mattcarberry/echolink_hardware/Documentation/Project Documents/Pictures for Presentation and other docs/dj-audio-mixer-clip-art.jpg

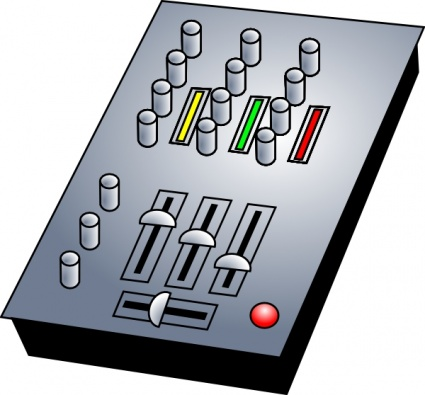
Documentation/Project Documents/Pictures for Presentation and other docs/dj-audio-mixer-clip-art.jpg
