mattcarberry/echolink_hardware/Documentation/Project Documents/2716_cyberspace/2716_example.jpg

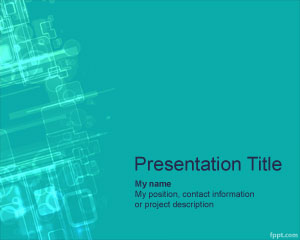
Documentation/Project Documents/2716_cyberspace/2716_example.jpg
