mattcarberry/echolink_hardware/README.md

# echolink_hardware
Hardware for interfacing AC6P's repeater design to an echolink server
