mattcarberry/echolink_hardware/Documentation/Project/Final Presentation/Final_Pres_SC_Only.pptx

## Antenna Switching Circuit

- System that switches active antenna
- Digital control and feedback signals

## Motivation

- Real time switching between antennas
- Switching event through DTMF tones

## Initial Design and Implementation

- Power supply
- Coaxial relays
- Power MOSFETs
- Two feedback signals

## Challenges

- Rectified DC voltage higher than calculations predicted
- Power resistors were found to get very hot
- DTMF board can’t completely tell state of switching board

## Final Design

- Added a fan to cool
- Third feedback signal added

## Results

- Reliable antenna switching
