mattcarberry/echolink_hardware/Documentation/Project/Final Presentation/PresentationLuis.pptx

## DTMF Controller

Overview:
- The DTMF Controller acts as a central control for the antenna switching system
  - Logic is collected and sent between this circuit and the Linking Interface as well as the Switching Circuit
  - Verifies DTMF sequences through hardware and switches between the VPOL and CPOL antenna upon an appropriate sequence

## Initial Design and Implementation

- Initial Design included DTMF decoder chip MT8870 and an Atmega328P
  - Atmega 328P provides enough GPIO ports for desired inputs, outputs, and additional pins for future work
  - Atmega 328P inputs are compatible with Decoder outputs
- Initial design involved Pulsed inputs using AND gates

## Challenges

- Debugging
- Slow Decoding
- Pulsed signals had potential for timing errors, so instead designed to function with latched signals synchronous

## Results

- Final Design
  - Faster Decoding Time
  - Latched Inputs
  - LCD Display
  - Status LED’s
  - Manual Switch
  - Audible Tone

## All Star Link Node

- Overview
  - Odroid U3
  - Asterisk PBX
  - AllStar Link
  - Validated Users
  - Security

## Approach and Initial Design

- IRLP
- Odroid U3
- CM 108 Audio Codec
- U3 I/O Daughter Board

## Challenges

- Processing power
- Software Installation
- Device Driver
- Little Documentation
- No Support for Odroid
- UDP Port Access

## Results
