mattcarberry/echolink_hardware/Documentation/Project/Meeting Records/meetingweek1.docx

Tim:

IRLP, and Echolink:

Maybe first, integrate each system on their own microcontroller, and once its working, then look into integrating them onto a single board.

Make sure to transpose all notes to a physical notebook.

Tim and Luis:

Make sure to specifically differentiate the work that each one does every week.

Kevin:
