mattcarberry/echolink_hardware/CPOLAntenna/TRASCO RF Relay kc-11200.pdf

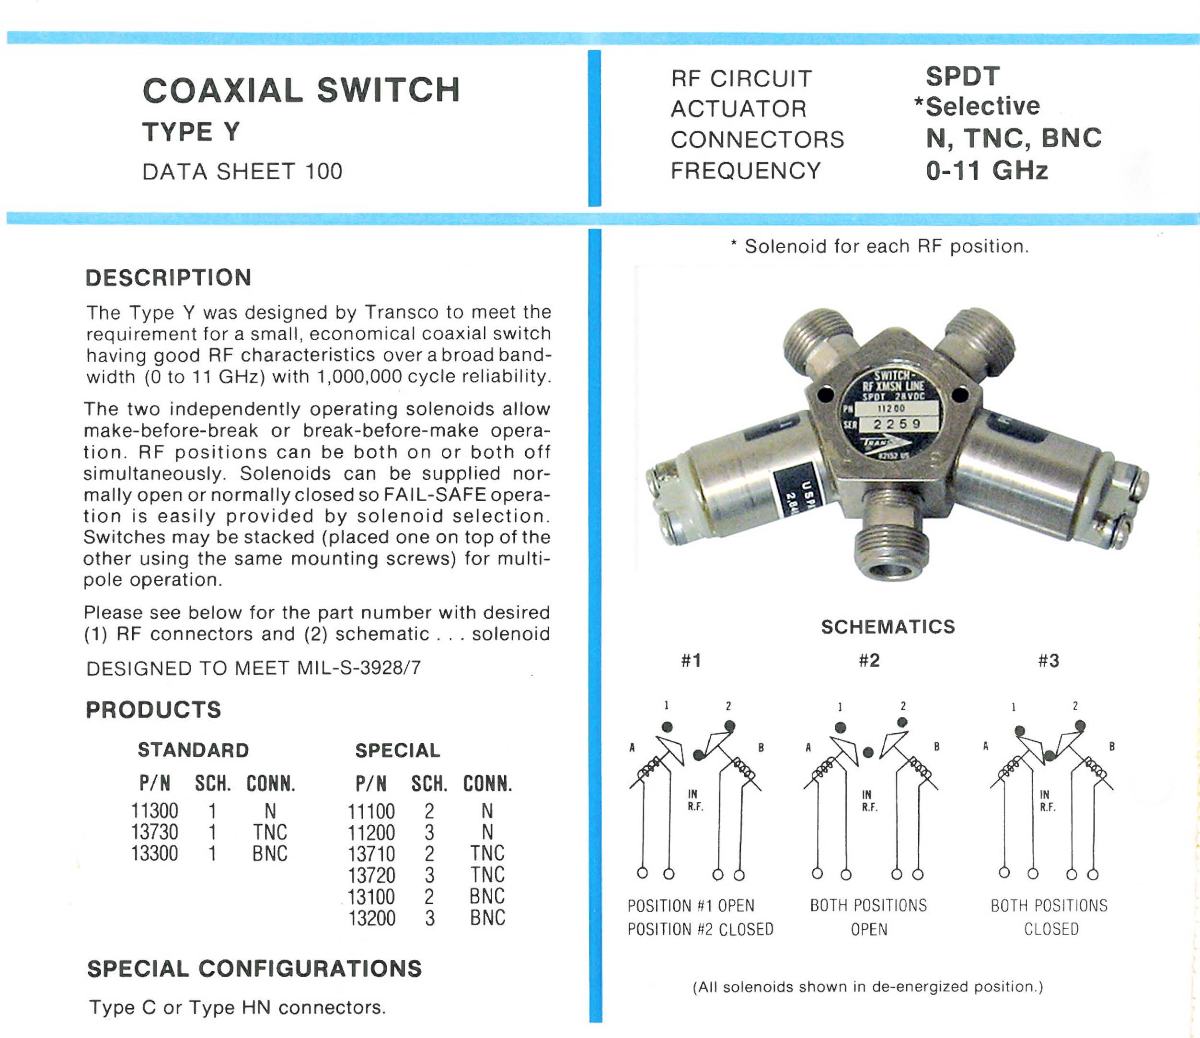
[picture p41: page 1]
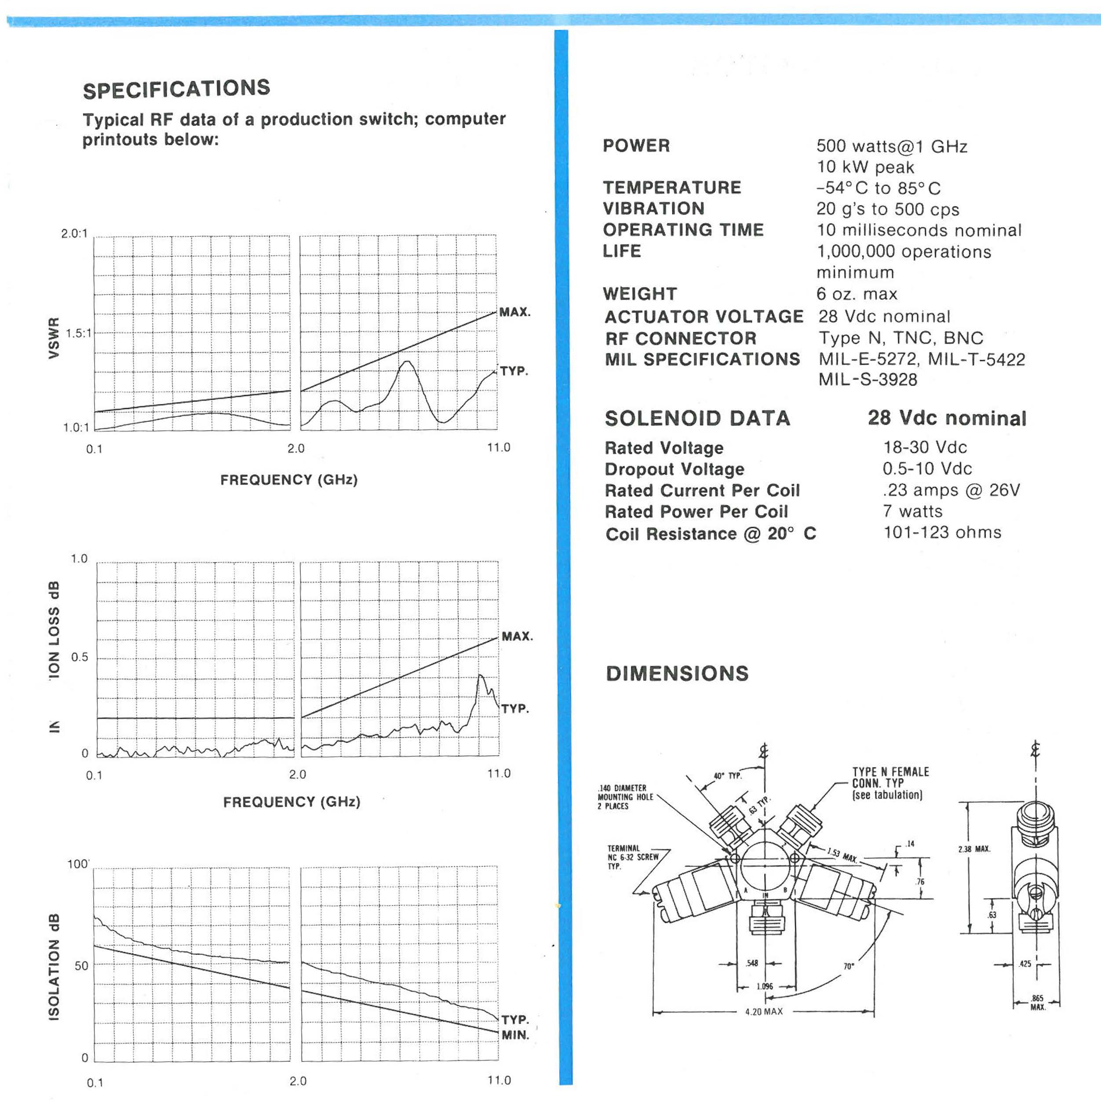
[picture p42: page 2]
