mattcarberry/echolink_hardware/Documentation/repeater_interface_v2_0.pdf

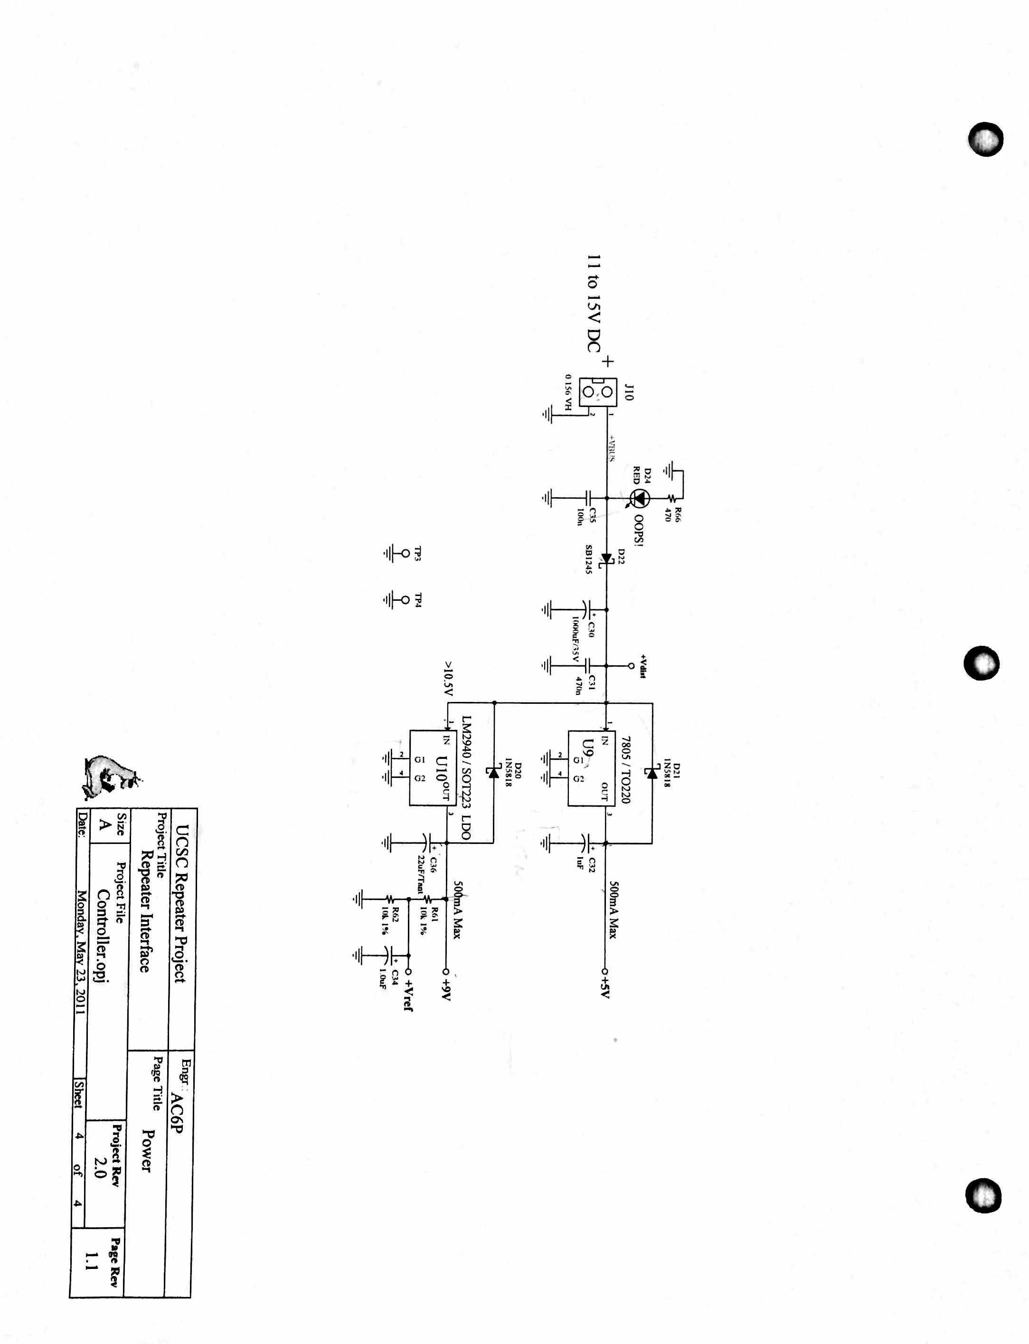
[picture p43: page 1]
