mattcarberry/echolink_hardware/Documentation/BlockDiagrams/Doc - Feb 17, 2015, 4-01 PM.pdf

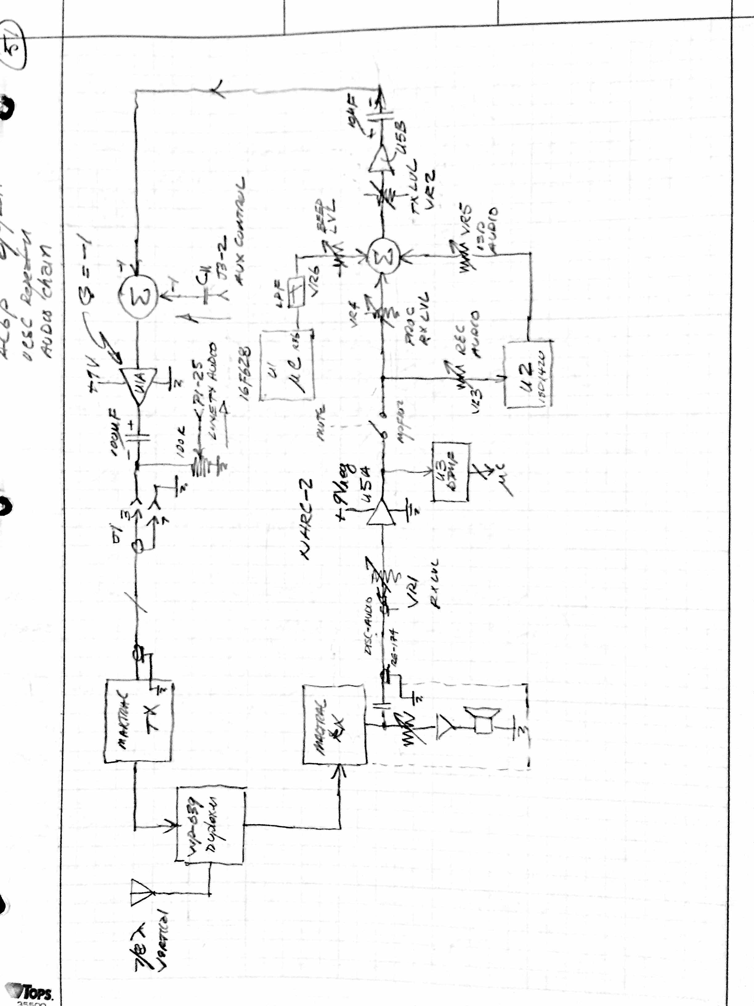
[picture p44: page 1]
