mattcarberry/echolink_hardware/Documentation/BlockDiagrams/Doc - Mar 3, 2015, 4-58 PM.pdf

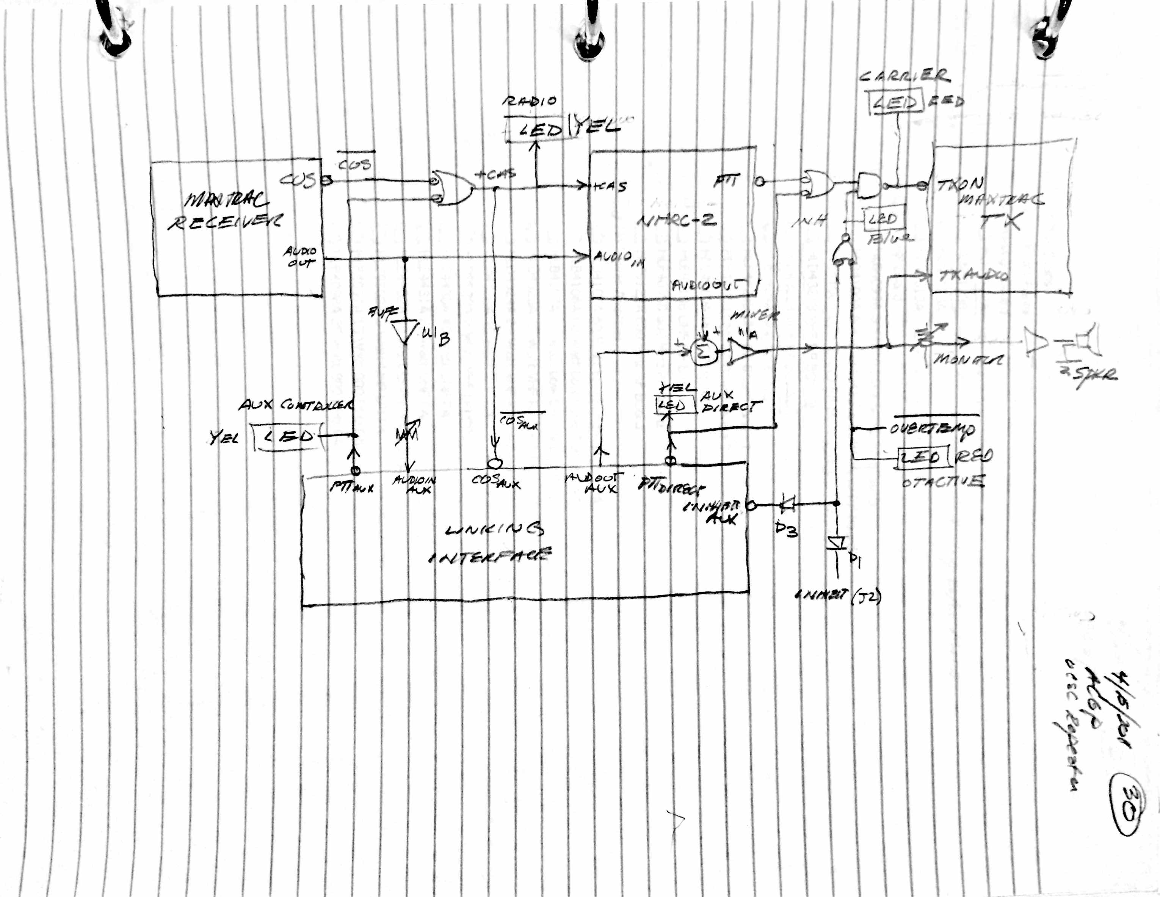
[picture p45: page 1]
