mattcarberry/echolink_hardware/Documentation/AppNotes/DTMF-code-table.jpg

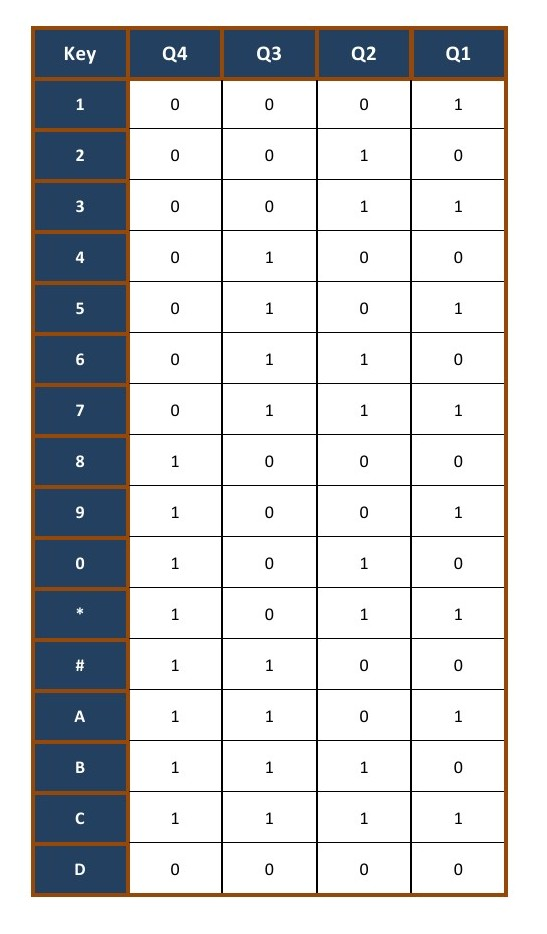
Documentation/AppNotes/DTMF-code-table.jpg
