mattcarberry/echolink_hardware/Documentation/AppNotes/image8.png

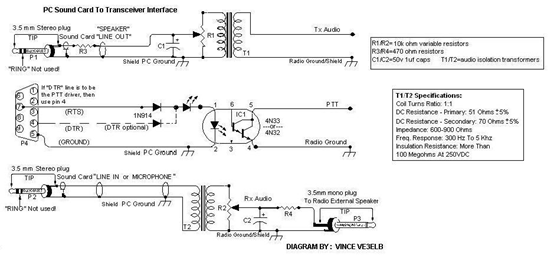
Documentation/AppNotes/image8.png
