mattcarberry/echolink_hardware/Documentation/AppNotes/image11.png

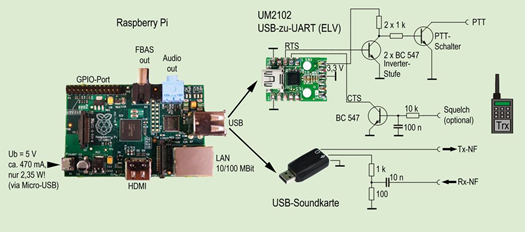
Documentation/AppNotes/image11.png
