mattcarberry/echolink_hardware/Documentation/AppNotes/irlpd.jpg

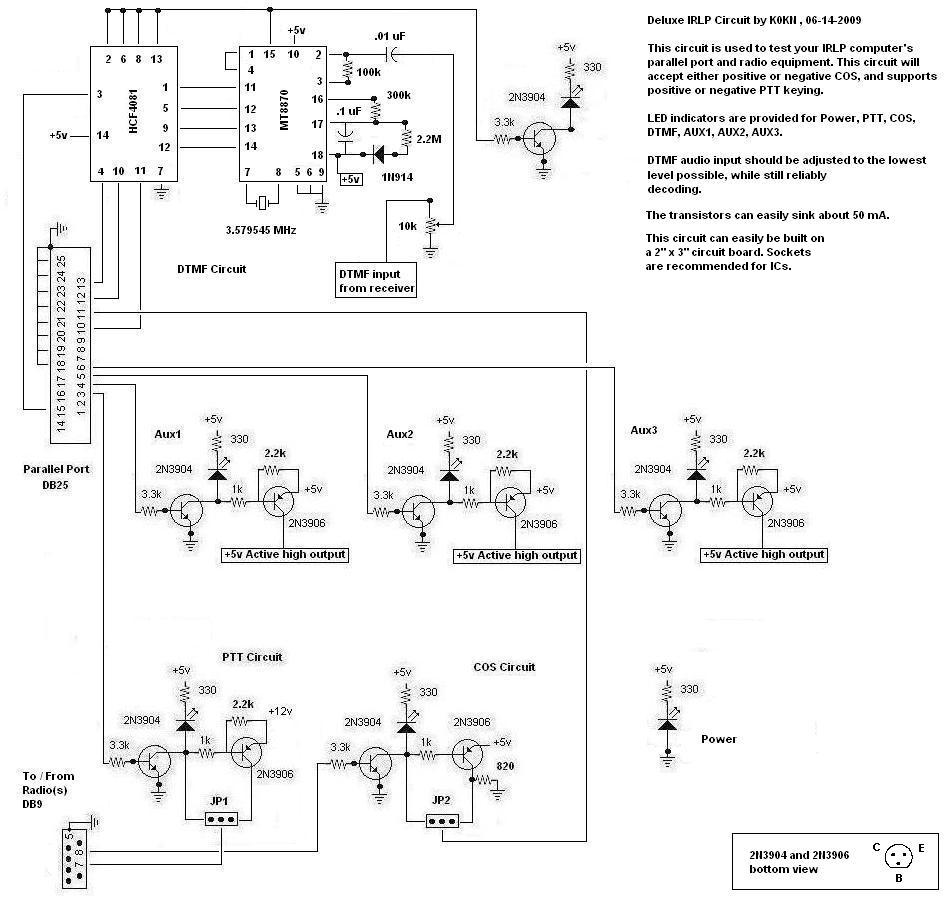
Documentation/AppNotes/irlpd.jpg
