mattcarberry/echolink_hardware/Documentation/AppNotes/simple_interface1.png

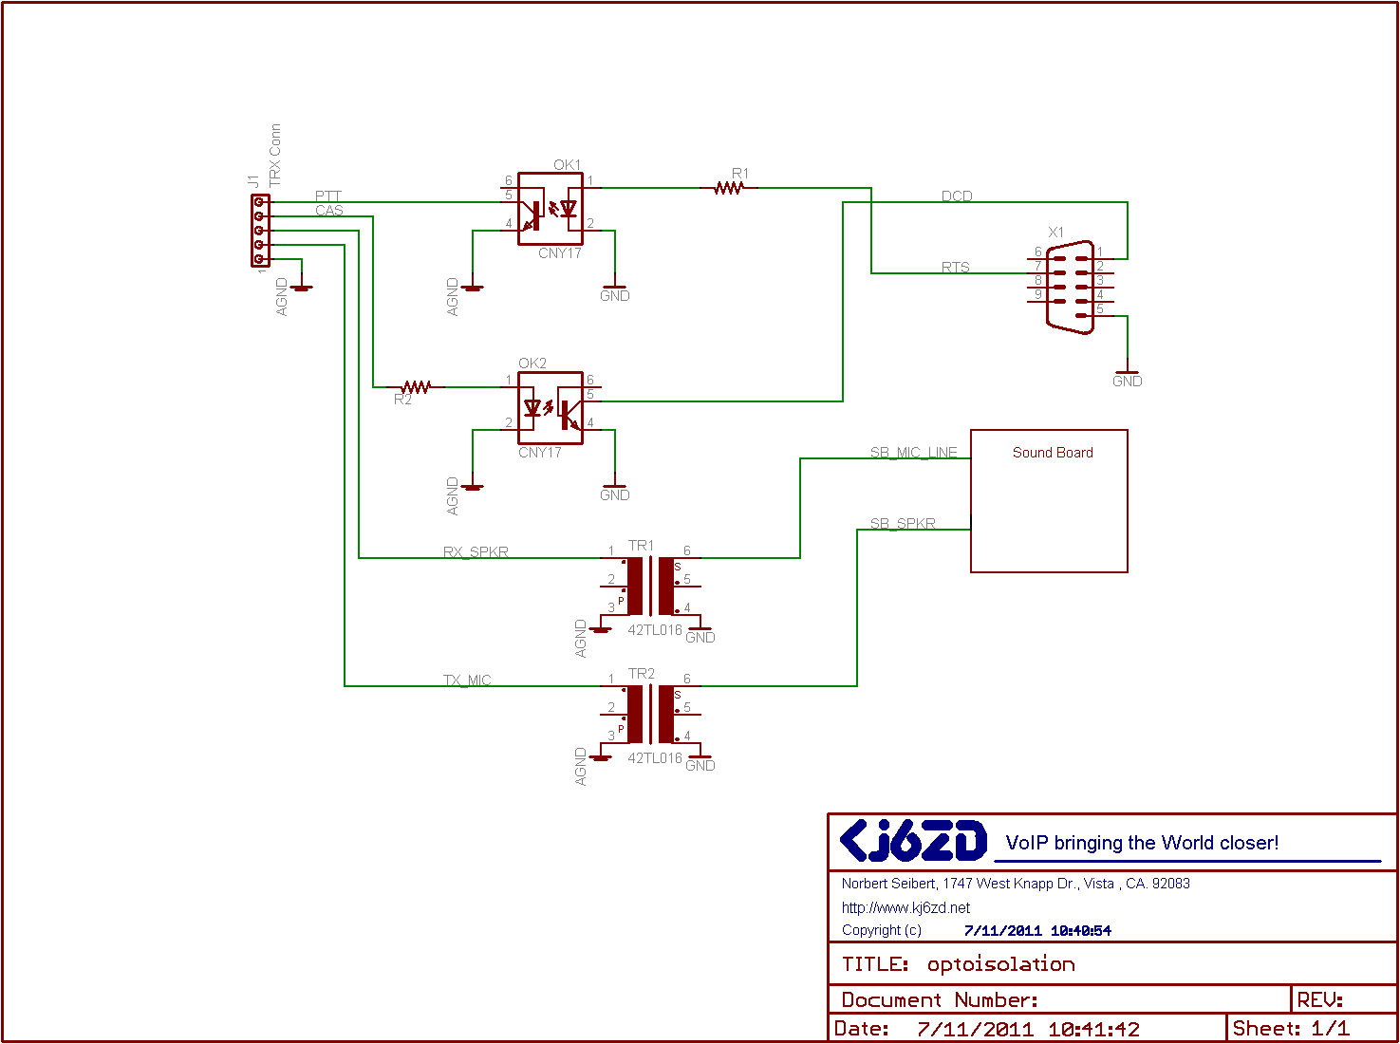
Documentation/AppNotes/simple_interface1.png
