mattcarberry/echolink_hardware/Documentation/AppNotes/SvxLink-Extension2.png

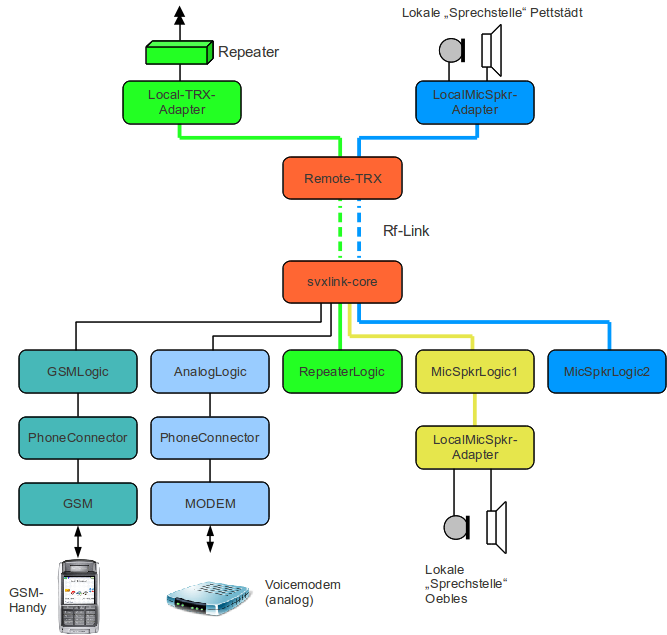
Documentation/AppNotes/SvxLink-Extension2.png
