mattcarberry/echolink_hardware/Documentation/AppNotes/typical.gif

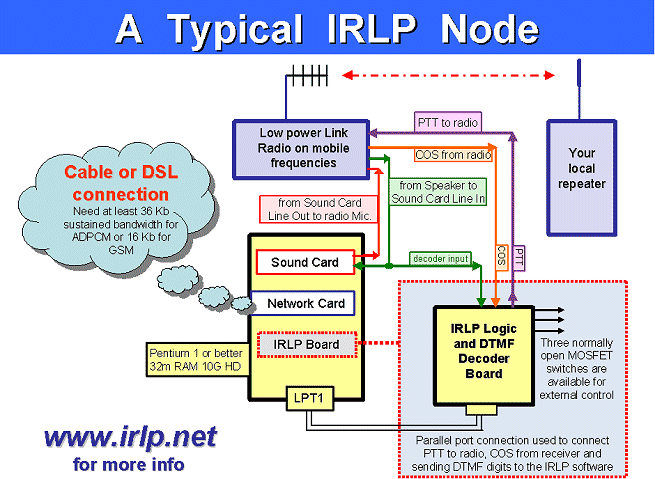
Documentation/AppNotes/typical.gif
