mattcarberry/echolink_hardware/Documentation/BlockDiagrams/FullSystemBlockDiagram_Final.jpg

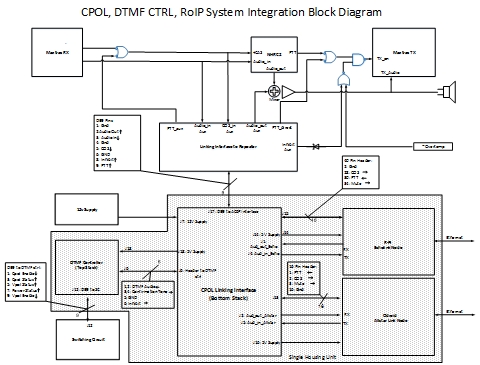
Documentation/BlockDiagrams/FullSystemBlockDiagram_Final.jpg
