mattcarberry/echolink_hardware/Documentation/BlockDiagrams/Screen Shot 2015-01-08 at 4.49.24 PM.png

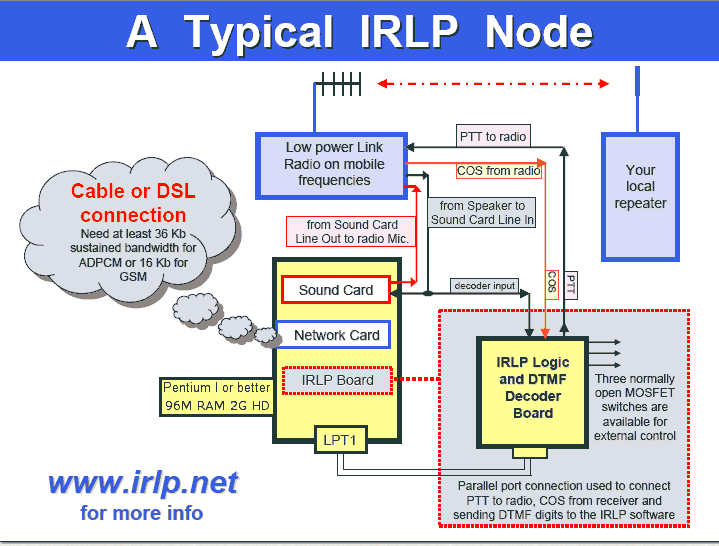
Documentation/BlockDiagrams/Screen Shot 2015-01-08 at 4.49.24 PM.png
