mattcarberry/echolink_hardware/Documentation/BlockDiagrams/Screen Shot 2015-01-08 at 7.00.11 PM.png

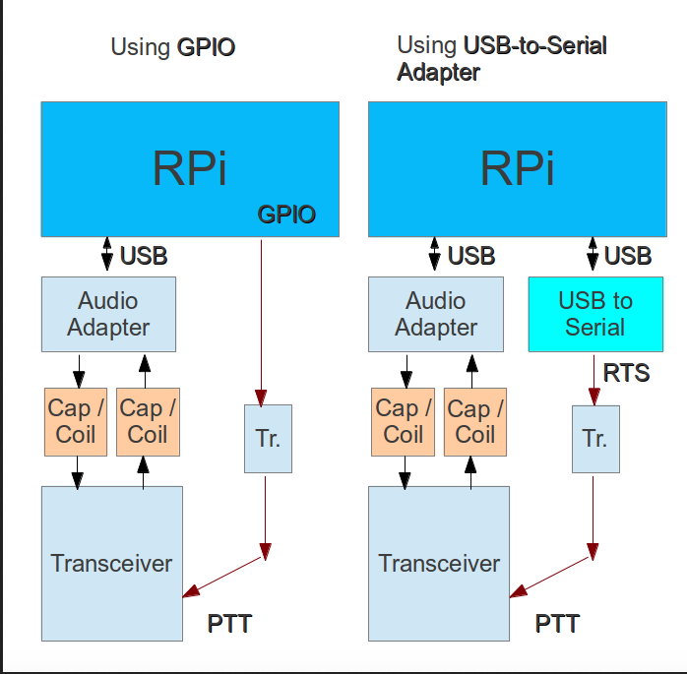
Documentation/BlockDiagrams/Screen Shot 2015-01-08 at 7.00.11 PM.png
