mattcarberry/echolink_hardware/Documentation/BlockDiagrams/SystemBlockDiagram_EcholinkANDAllstarLink.jpg

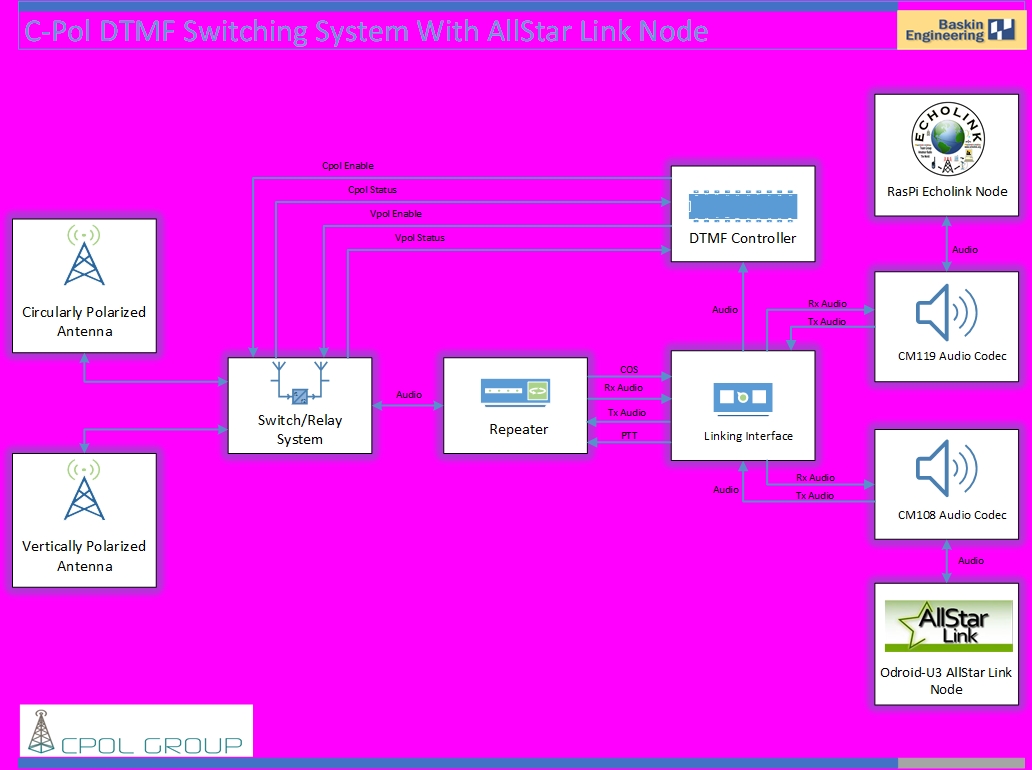
Documentation/BlockDiagrams/SystemBlockDiagram_EcholinkANDAllstarLink.jpg
