mattcarberry/echolink_hardware/Documentation/linking_interface_usb.png

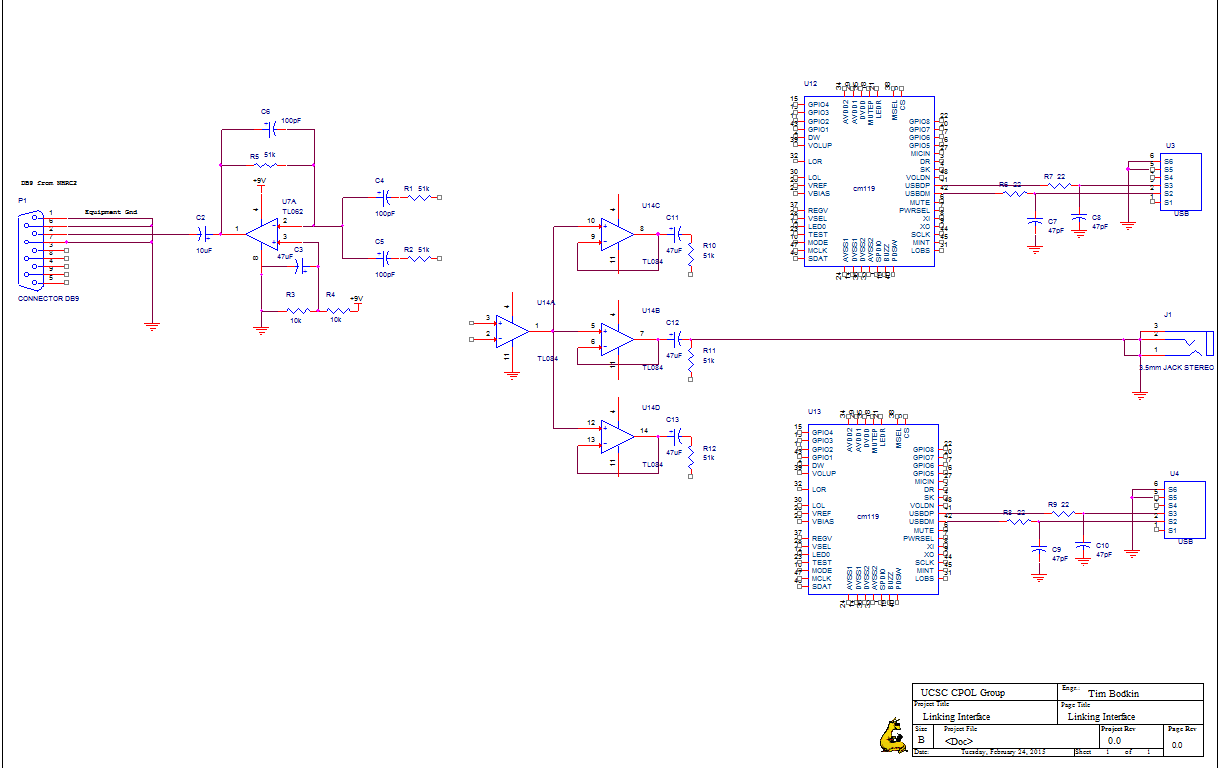
Documentation/linking_interface_usb.png
