mattcarberry/echolink_hardware/Documentation/plria.jpg

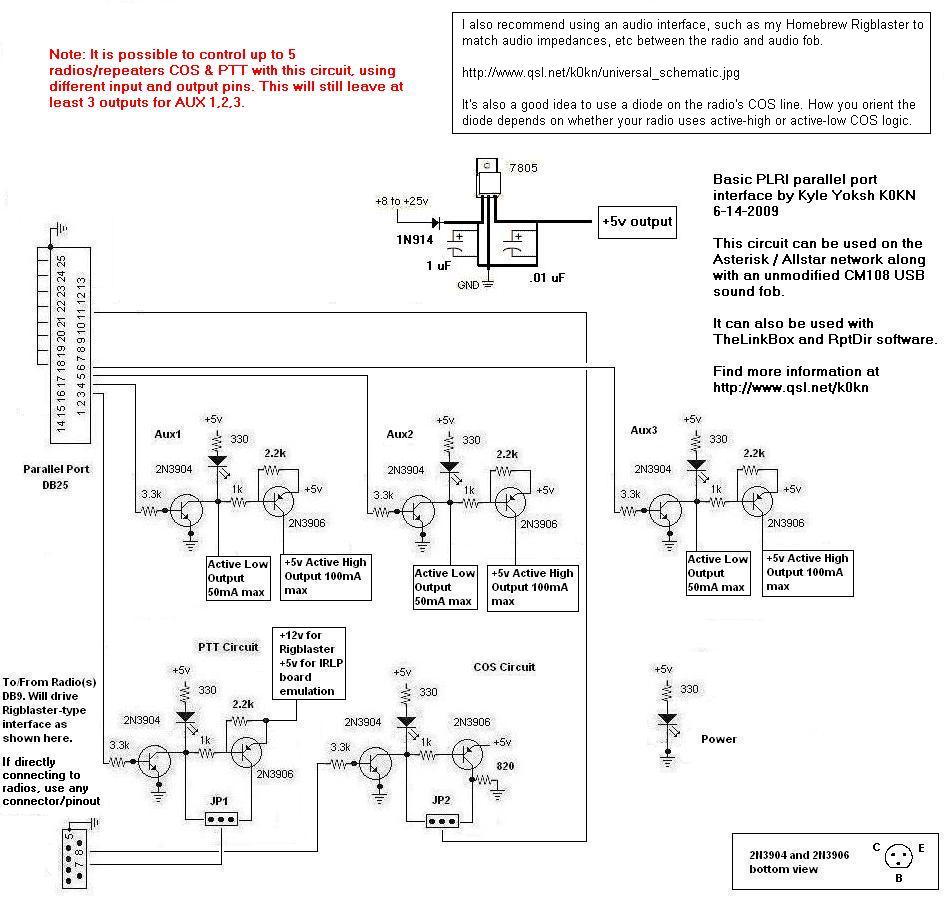
Documentation/plria.jpg
