mattcarberry/echolink_hardware/Documentation/Project Documents/2716_cyberspace/template_internal.jpg

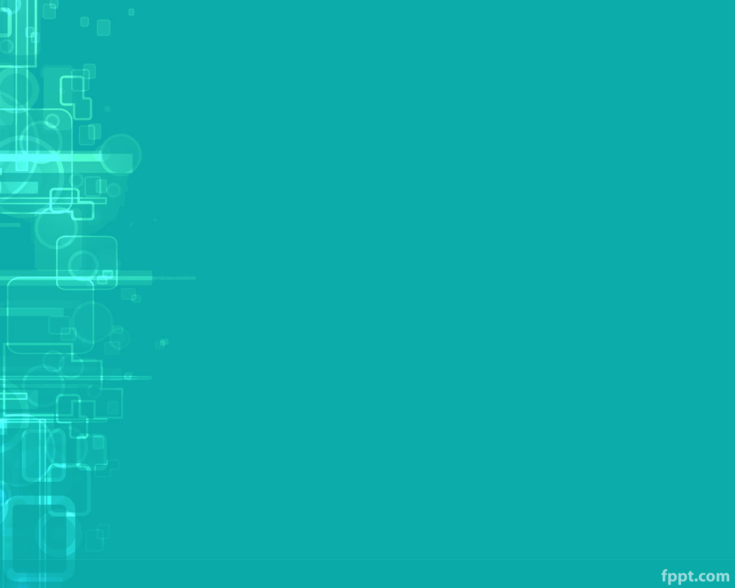
Documentation/Project Documents/2716_cyberspace/template_internal.jpg
