mattcarberry/echolink_hardware/Documentation/Project Documents/Pictures for Presentation and other docs/1105a.jpg

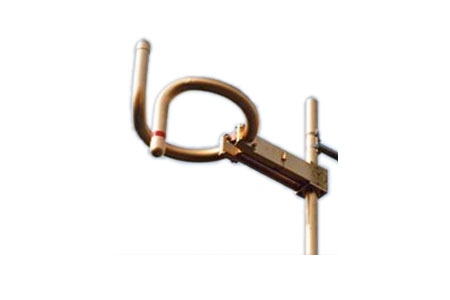
Documentation/Project Documents/Pictures for Presentation and other docs/1105a.jpg
