mattcarberry/echolink_hardware/Documentation/Project Documents/Pictures for Presentation and other docs/antenna-tower1.png

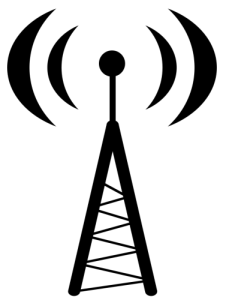
Documentation/Project Documents/Pictures for Presentation and other docs/antenna-tower1.png
