mattcarberry/echolink_hardware/Documentation/Project Documents/Pictures for Presentation and other docs/arrl_diamond_1.gif

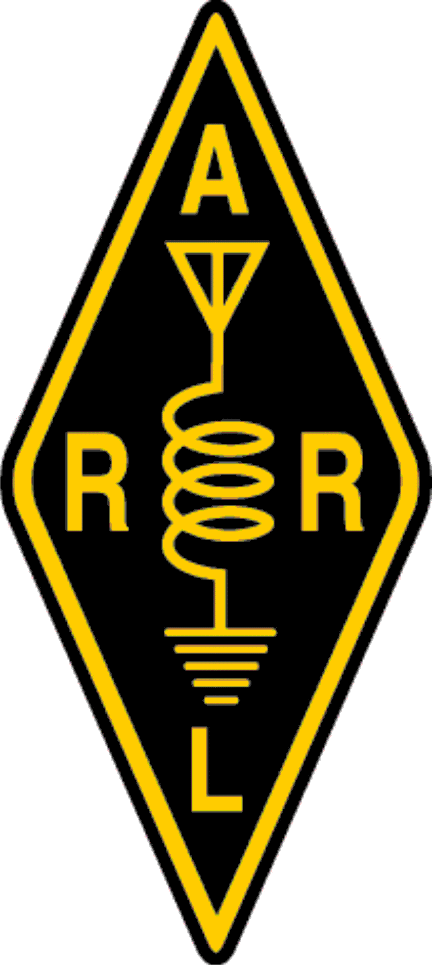
Documentation/Project Documents/Pictures for Presentation and other docs/arrl_diamond_1.gif
