mattcarberry/echolink_hardware/Documentation/Project Documents/Pictures for Presentation and other docs/capture_1x.png

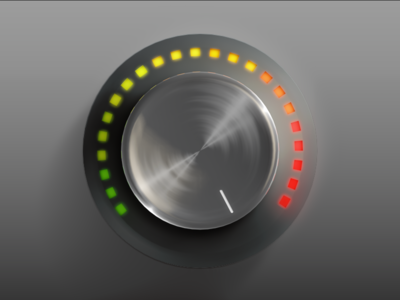
Documentation/Project Documents/Pictures for Presentation and other docs/capture_1x.png
