mattcarberry/echolink_hardware/Documentation/Project Documents/Pictures for Presentation and other docs/CPOL.jpg

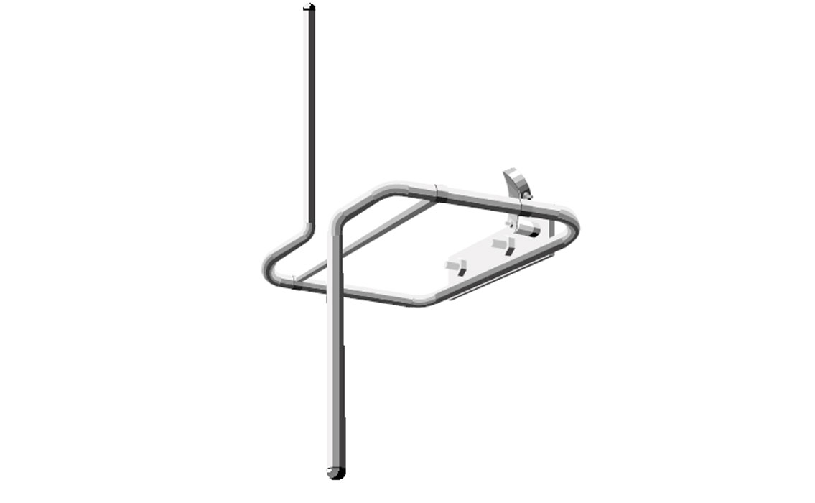
Documentation/Project Documents/Pictures for Presentation and other docs/CPOL.jpg
