mattcarberry/echolink_hardware/Documentation/Project Documents/Pictures for Presentation and other docs/Cycdiag2.gif

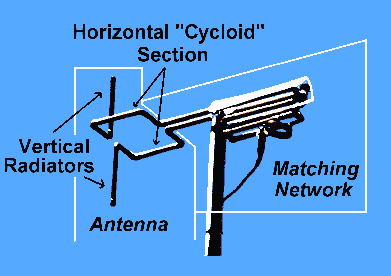
Documentation/Project Documents/Pictures for Presentation and other docs/Cycdiag2.gif
