mattcarberry/echolink_hardware/Documentation/Project Documents/Pictures for Presentation and other docs/fm1mountingdetail.gif

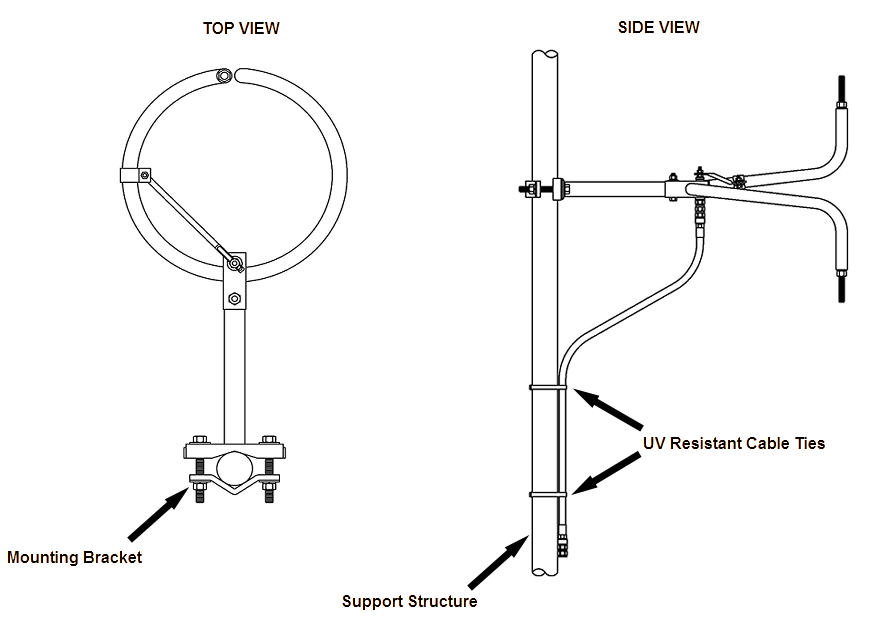
Documentation/Project Documents/Pictures for Presentation and other docs/fm1mountingdetail.gif
