mattcarberry/echolink_hardware/Documentation/Project Documents/Pictures for Presentation and other docs/keypad.gif

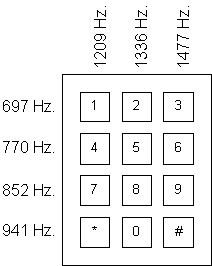
Documentation/Project Documents/Pictures for Presentation and other docs/keypad.gif
