mattcarberry/echolink_hardware/Documentation/Project Documents/Pictures for Presentation and other docs/maxresdefault.jpg

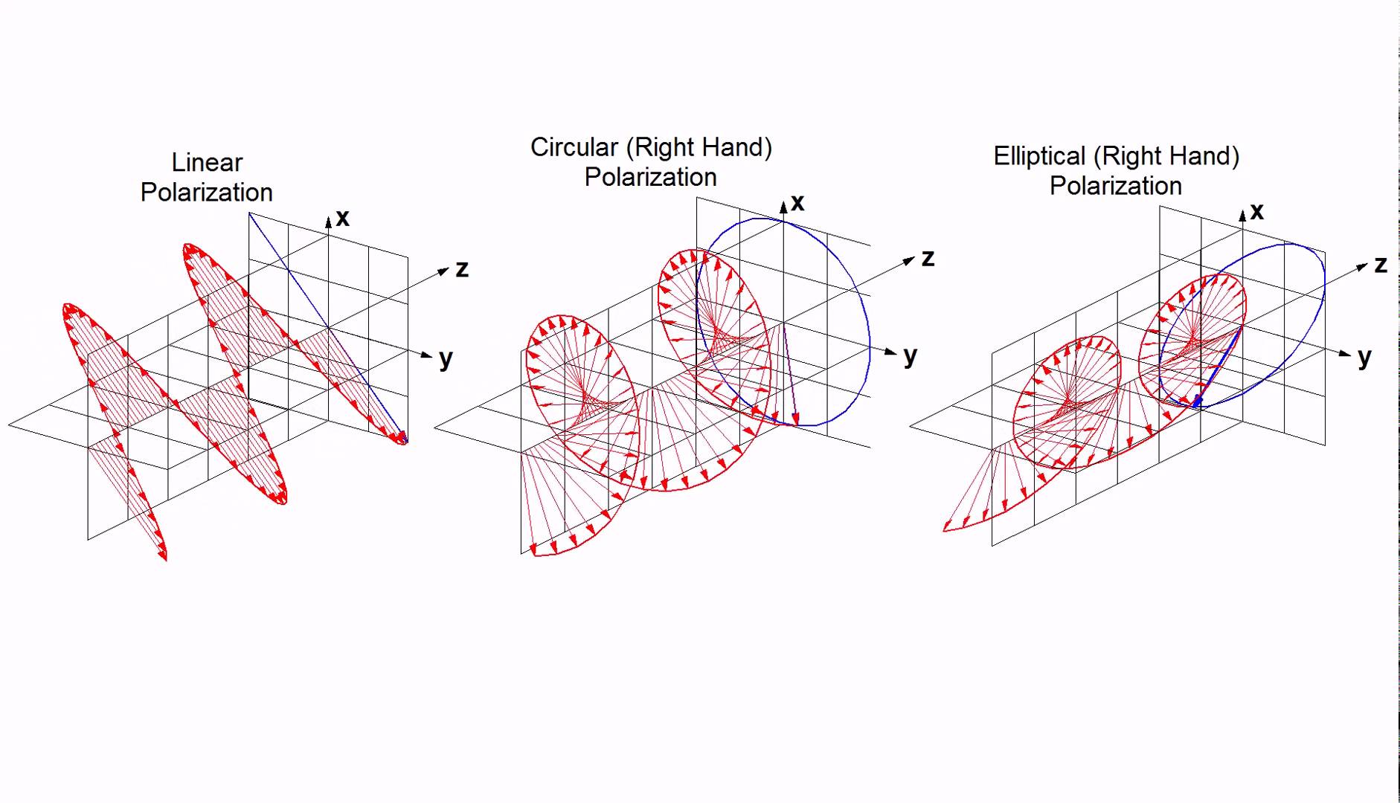
Documentation/Project Documents/Pictures for Presentation and other docs/maxresdefault.jpg
