mattcarberry/echolink_hardware/Documentation/Project Documents/Pictures for Presentation and other docs/P0013158_new_com3.jpg

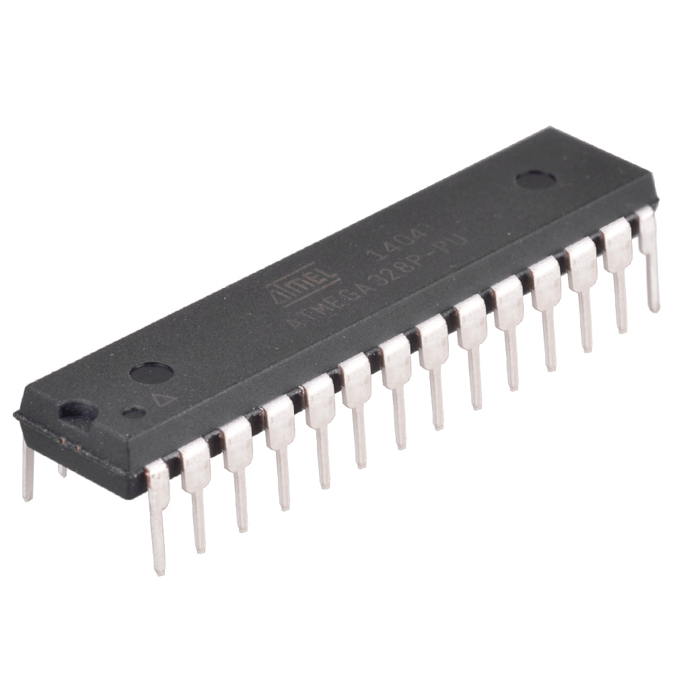
Documentation/Project Documents/Pictures for Presentation and other docs/P0013158_new_com3.jpg
