mattcarberry/echolink_hardware/Documentation/Project Documents/Pictures for Presentation and other docs/raspberry_pi_model_b_0.jpg

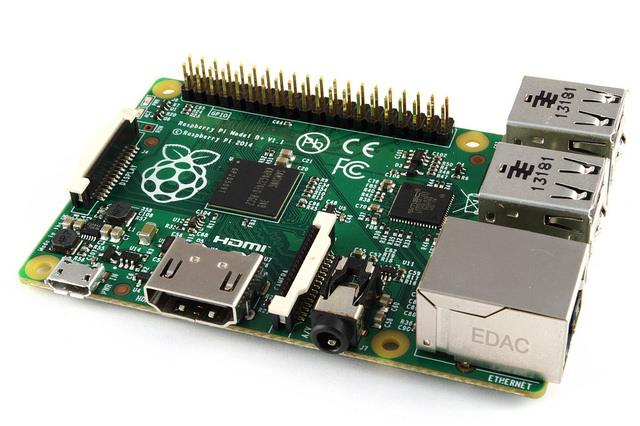
Documentation/Project Documents/Pictures for Presentation and other docs/raspberry_pi_model_b_0.jpg
