mattcarberry/echolink_hardware/Documentation/Project Documents/Pictures for Presentation and other docs/Untitled-1.png

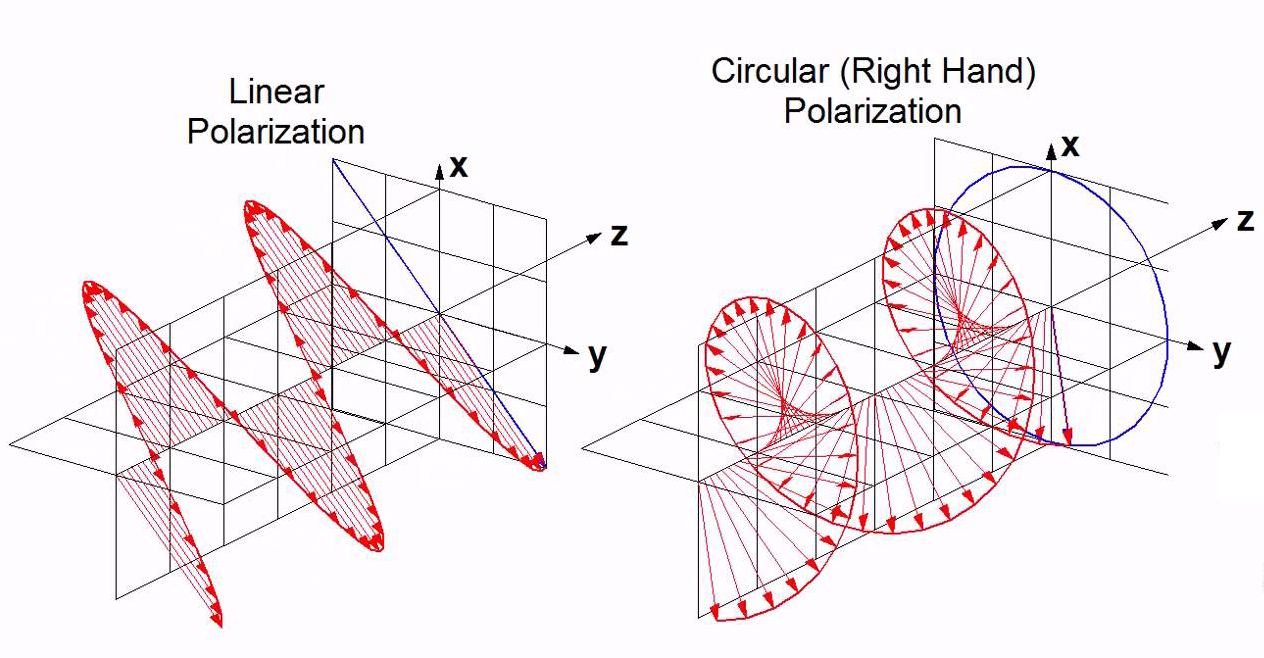
Documentation/Project Documents/Pictures for Presentation and other docs/Untitled-1.png
