mattcarberry/echolink_hardware/Documentation/Project Documents/Pictures for Presentation and other docs/walkie-talkie.gif

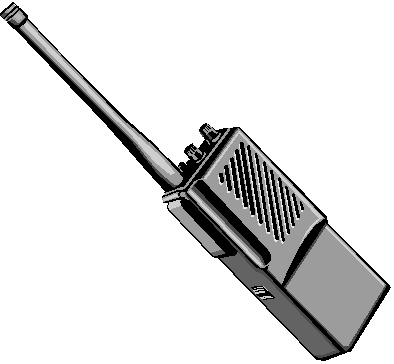
Documentation/Project Documents/Pictures for Presentation and other docs/walkie-talkie.gif
