mattcarberry/echolink_hardware/Documentation/Project Documents/Powerpoint Presentation/20150209_020059.jpg

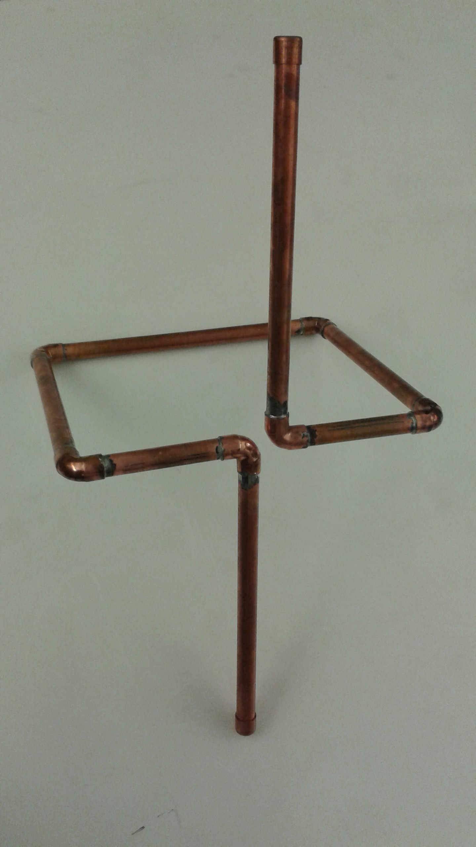
Documentation/Project Documents/Powerpoint Presentation/20150209_020059.jpg
