mattcarberry/echolink_hardware/Documentation/Project Documents/Powerpoint Presentation/IMG_1258.JPG

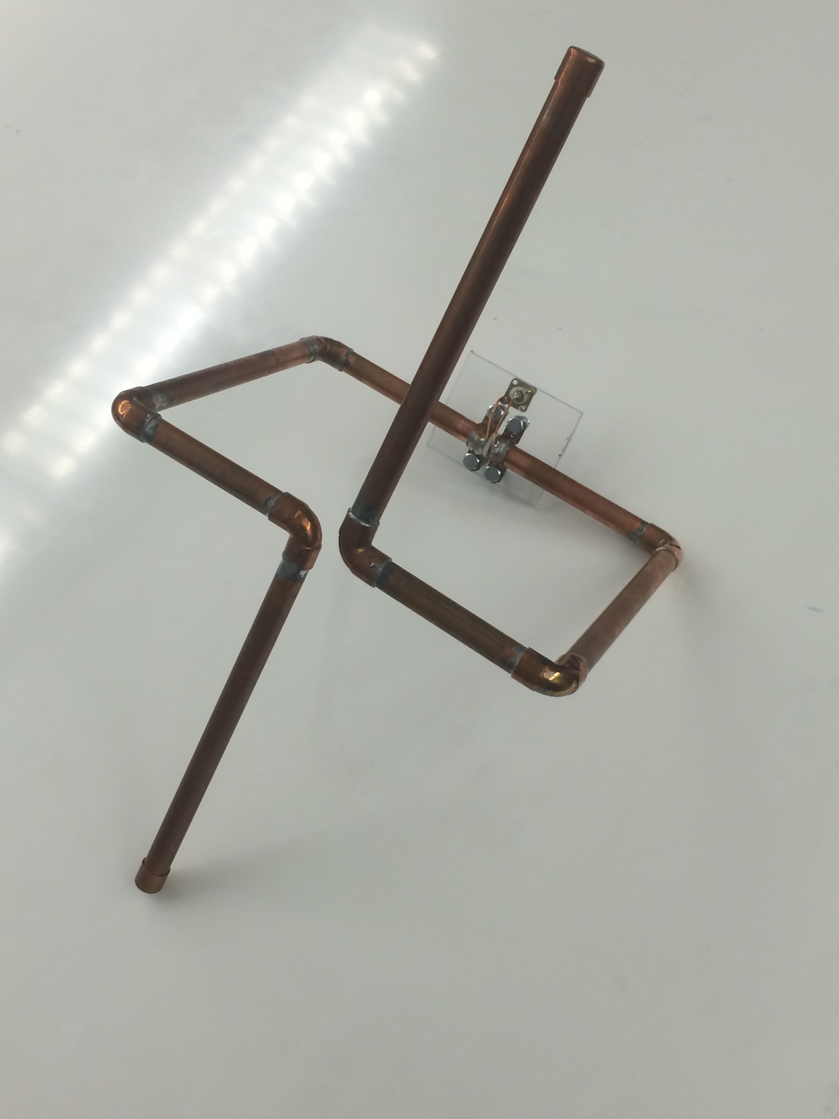
Documentation/Project Documents/Powerpoint Presentation/IMG_1258.JPG
