mattcarberry/echolink_hardware/Documentation/Project/Final Presentation/hpto stuff/circular.png

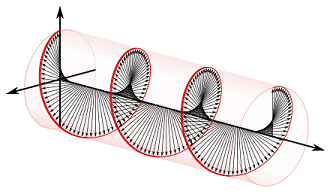
Documentation/Project/Final Presentation/hpto stuff/circular.png
