mattcarberry/echolink_hardware/Documentation/Project/Final Presentation/hpto stuff/polarisation.gif

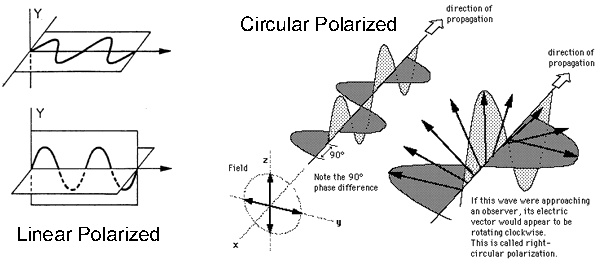
Documentation/Project/Final Presentation/hpto stuff/polarisation.gif
