mattcarberry/echolink_hardware/Documentation/Project/IMG_1249.JPG

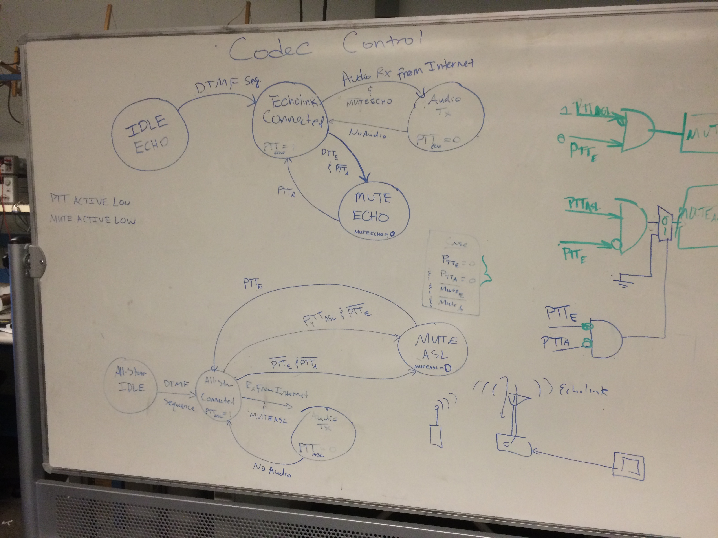
Documentation/Project/IMG_1249.JPG
