mattcarberry/echolink_hardware/Documentation/Project/Interim Report/InterfaceSchematic2.2.png

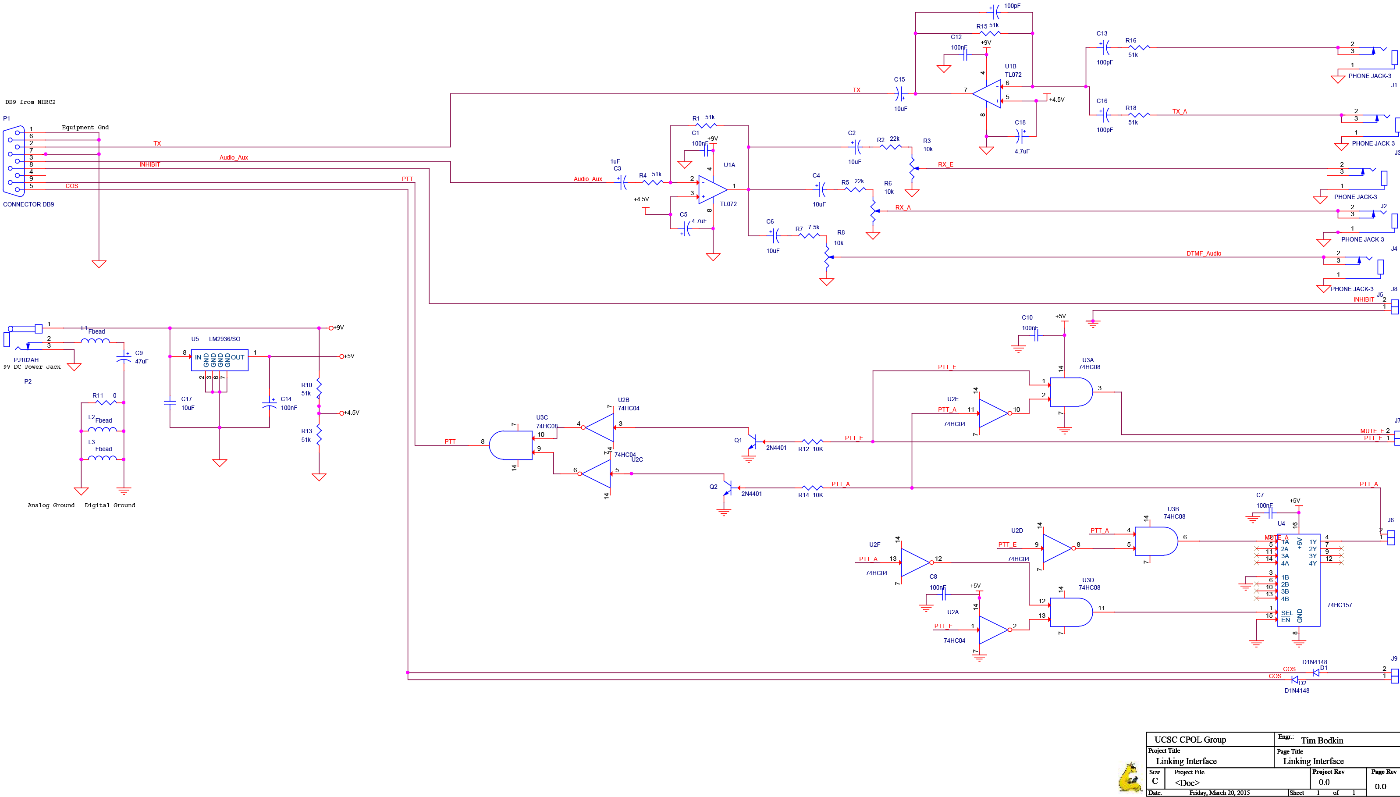
Documentation/Project/Interim Report/InterfaceSchematic2.2.png
