mattcarberry/echolink_hardware/Documentation/Project/Interim Report/LinkingInterfaceV2.2.png

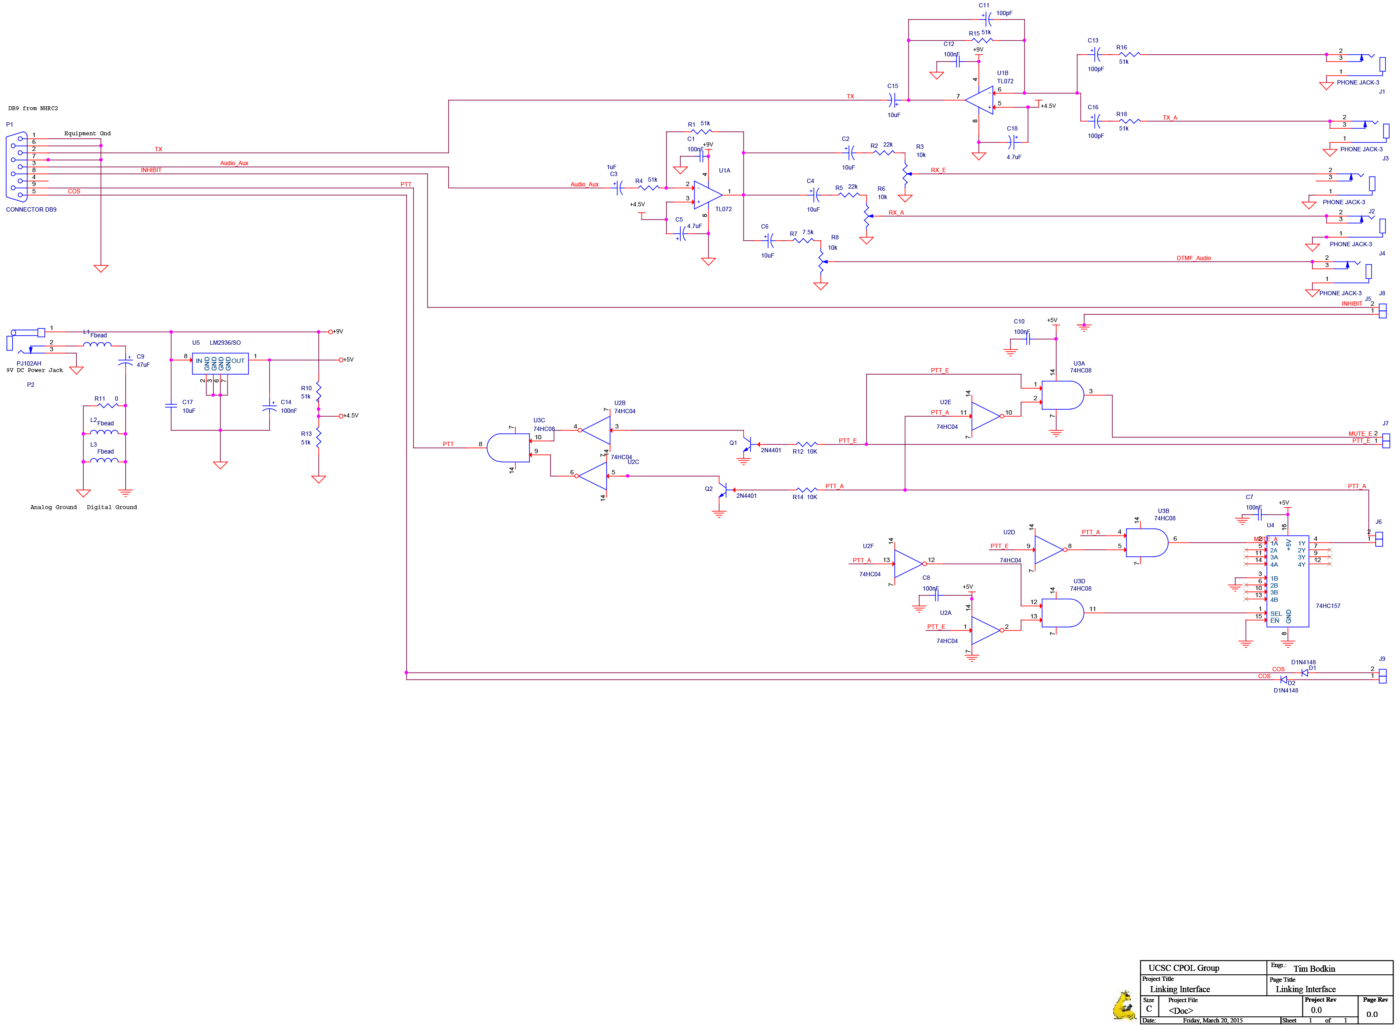
Documentation/Project/Interim Report/LinkingInterfaceV2.2.png
