mattcarberry/echolink_hardware/Documentation/universal_schematic.jpg

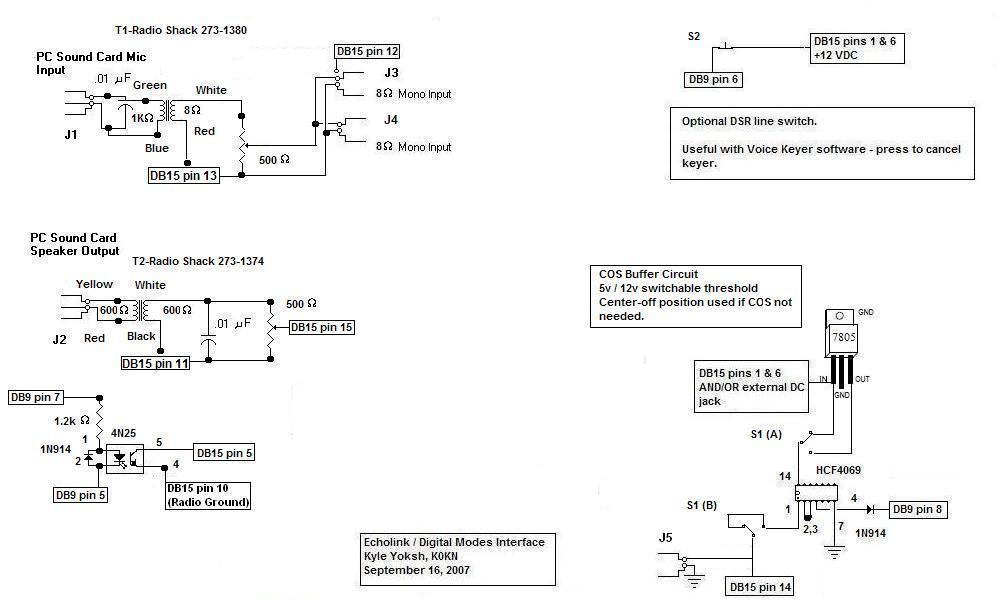
Documentation/universal_schematic.jpg
