mattcarberry/echolink_hardware/Documentation/Connector_Order_June1.xlsx

Description | Digikey Part Number | Number in Stock | Number Needed | Module
2 Pin Header | A1971-ND | 80 | 0
3 Pin Header | A24165-ND | 20 | 0
4 Pin Header | A1922-ND | 5 | 0
5 Pin Header | A19471-ND | 8 | 0
10 Pos Header | 609-3243-ND | 8 | 0
2 Pin Header Shell | A19950-ND | 7 | 50
3 Pin Header Shell | A19971-ND | 0 | 20
5 Pin Header Shell | A31020-ND | 10 | 0
18-24 AWG Socket | A32533-ND | 50 | 50
0805 LED's 10mA | 160-1177-1-ND | 0 | 12
DIODE SCHOTTKY 20V 3A SMC | B320-FDICT-ND | 33000 | 2 | Linking Interface
IC OPAMP JFET 3MHZ 8DIP | 296-1775-5-ND | 3100 | 2 | Linking Interface
CONN HEADR 40POS.100" | A108958-ND | 15 | 1 | Linking Interface
CONN HEADER R/A .100 16POS 15AU | A26683-ND | 447 | 1 | Linking Interface
CONN HEADER VERT 10POS GOLD | ED1543-ND | 26934 | 1 | Linking Interface
CONN HEADER VERT 6POS .100 TIN | A1923-ND | 33497 | 2 | Linking Interface
CONN HEADER 6POS .100 STR TIN | 609-3263-ND | 57845 | 2 | Linking Interface
296-20796-6-ND | IC REG LDO 5V 1.5A DDPAK | 8000 | 2 | Linking Interface
