mattcarberry/echolink_hardware/DTMFBoard/DTMF Controller/BOM-DTMF.xlsx

BOM
No
Designator | No | Part | Manufacturer | PartNum | DigiKey# | PricePerItem | Total
J14 | 1 | Power Jack | CUI INC | PJ-059B | CP-059B-ND | 1.21 | 1.21
R1,R2 | 2 | 100k 0805 Resistor | Panasonic Electronic | ERJ-6GEYJ104V | P100KACT-ND | 0.1 | 0.2
R3 | 1 | 10k 0805 Resistor | Panasonic Electronics | ERJ-6GEYJ103V | P10KACT-ND | 0.1 | 0.1
R4 | 1 | 10k potentiometer | Bourns nc | 3310C-001-103L | 3310C-001-103L-ND | 2.77 | 2.77
C4,C5 | 2 | 22pF 0805 Capacitor | Murata Electronics | GQM2195C1H220JB01D | 490-3608-1-ND | 0.78 | 1.56
C1,C2,C8-C11 | 6 | 10000pF Capacitor | Murata Electronics | GRM216R71H103KA01D | 490-1664-1-ND | 0.1 | 0.6
U1 | 1 | AND Gate HCF 4081 | STMicroelectronics | HCF4081BEY | 497-1371-5-ND | 2.8 | 2.8
Y1 | 1 | 3.579545MHZ Crystal | ESC Inc | ECS-35-17-4 | X079-ND | 0.81 | 0.81
Y2 | 1 | 16MHzCrystal | TXC Corporation | 9C-16.000MAAE-T | 887-2423-1-ND | 0.41 | 0.41
J12 | 1 | 4 pin terminal | On Shore Technology Inc | OSTTE040104 | ED2742-ND | 0.67 | 0.67
J11 | 1 | 3 pin terminal | Weidmuller | 1760520000 | 281-1883-ND | 0.86 | 0.86
 | 1 | power plug | CUI Inc | PP-013 | CP-013-ND | 1.22 | 1.22
J13 | 1 | pin headers | Harwin Inc | D01-9922046 | 952-1900-ND | 3.8 | 3.8
U7 | 1 | 8-bit microcontroller | Atmel | ATMEGA328P-PU | ATMEGA328P-PU-ND | 3.7 | 3.7
J15 | 1 | 5 Terminal Block | Phoenix Contact | 1935190 | ED2228-ND | 0.88 | 0.88
U6 | 1 | DTMF Decoder MT8870 | MICROSEMI | MT8870DE1 | future electronics | $1.14 | $1.14
