mattcarberry/echolink_hardware/Documentation/AppNotes/ODROID_wiring-pi2-odc1.pdf

Wiring-Pi2-Odroid-C1

WiringPI pin | Name | Header (odd) Header (even) | Name | WiringPi pin
| 3.3v | 12 | 5v
8 | SDA | 34 | 5v
9 | SCL | 56 | GND
7 | GPIO7 | 78 | TXD | 15
| GND | 910 | RXD | 16
0 | GPIO0 | 1112 | GPIO1 | 1
2 | GPIO2 | 1314 | GND
3 | GPIO3 | 1516 | GPIO4 | 4
| 3.3v | 1718 | GPIO5 | 5
12 | MOSI | 1920 | GND
13 | MISO | 2122 | GPIO6 | 6
14 | SCLK | 2324 | CE0 | 10
| GND | 2526 | CE1 | 11
