mattcarberry/echolink_hardware/Documentation/Tutorials/Build a 3 Channels Audio Splitter Amplifier Circuit Diagram using TL084.jpg

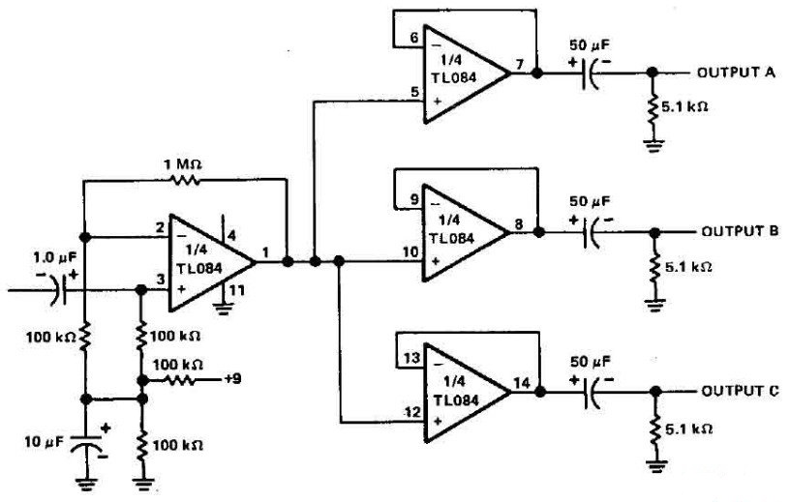
Documentation/Tutorials/Build a 3 Channels Audio Splitter Amplifier Circuit Diagram using TL084.jpg
