mattcarberry/echolink_hardware/Documentation/Tutorials/Echolink/echolinkschaltung1.png

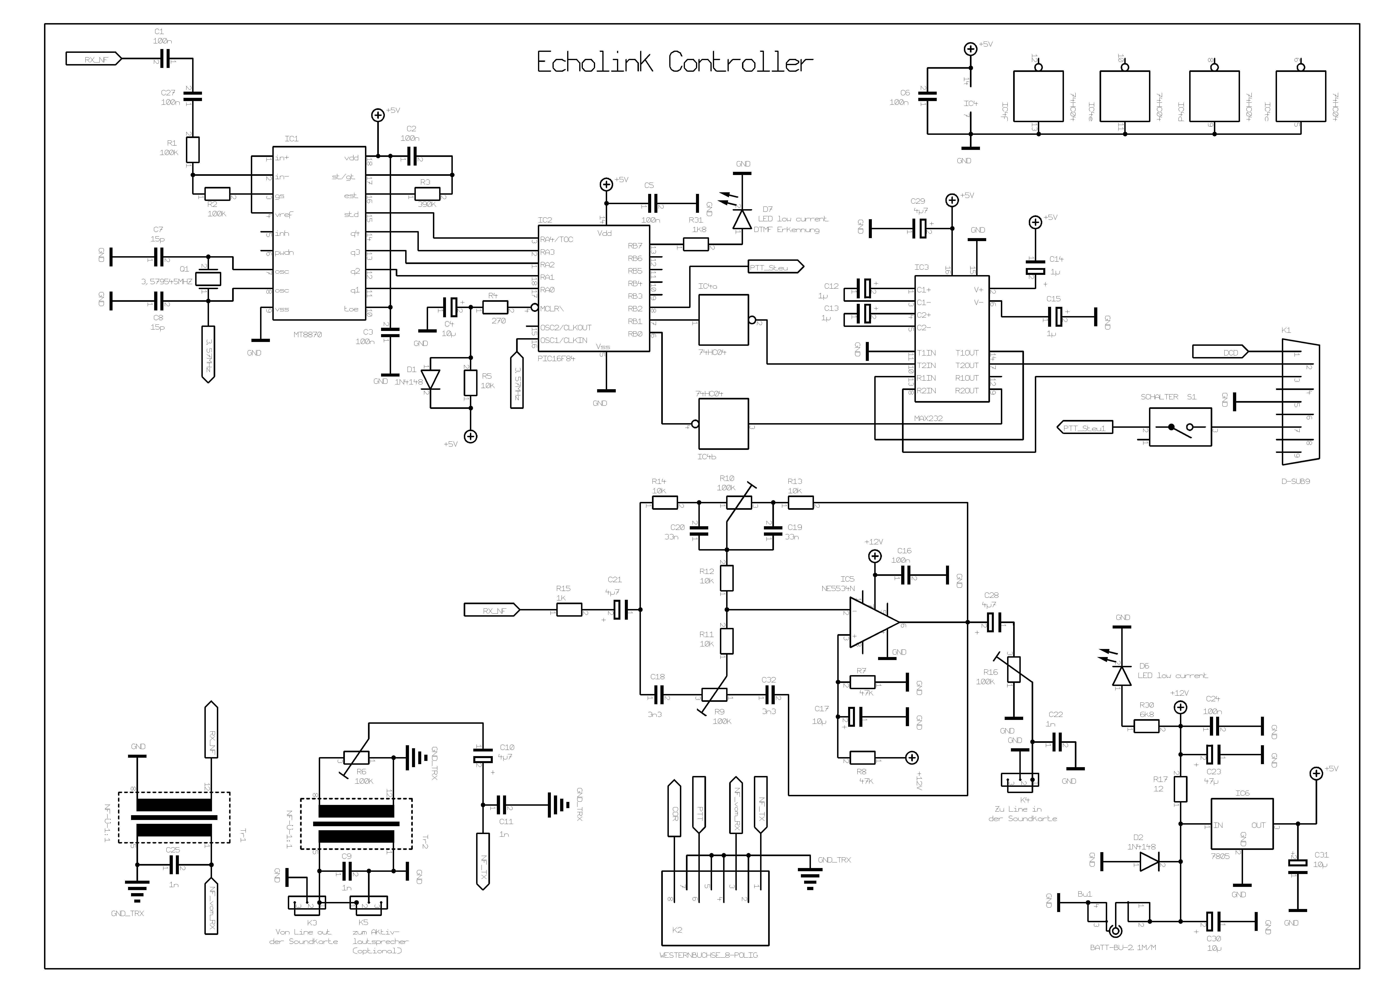
Documentation/Tutorials/Echolink/echolinkschaltung1.png
