mattcarberry/echolink_hardware/Documentation/Tutorials/Echolink/echolinkschaltung2.png

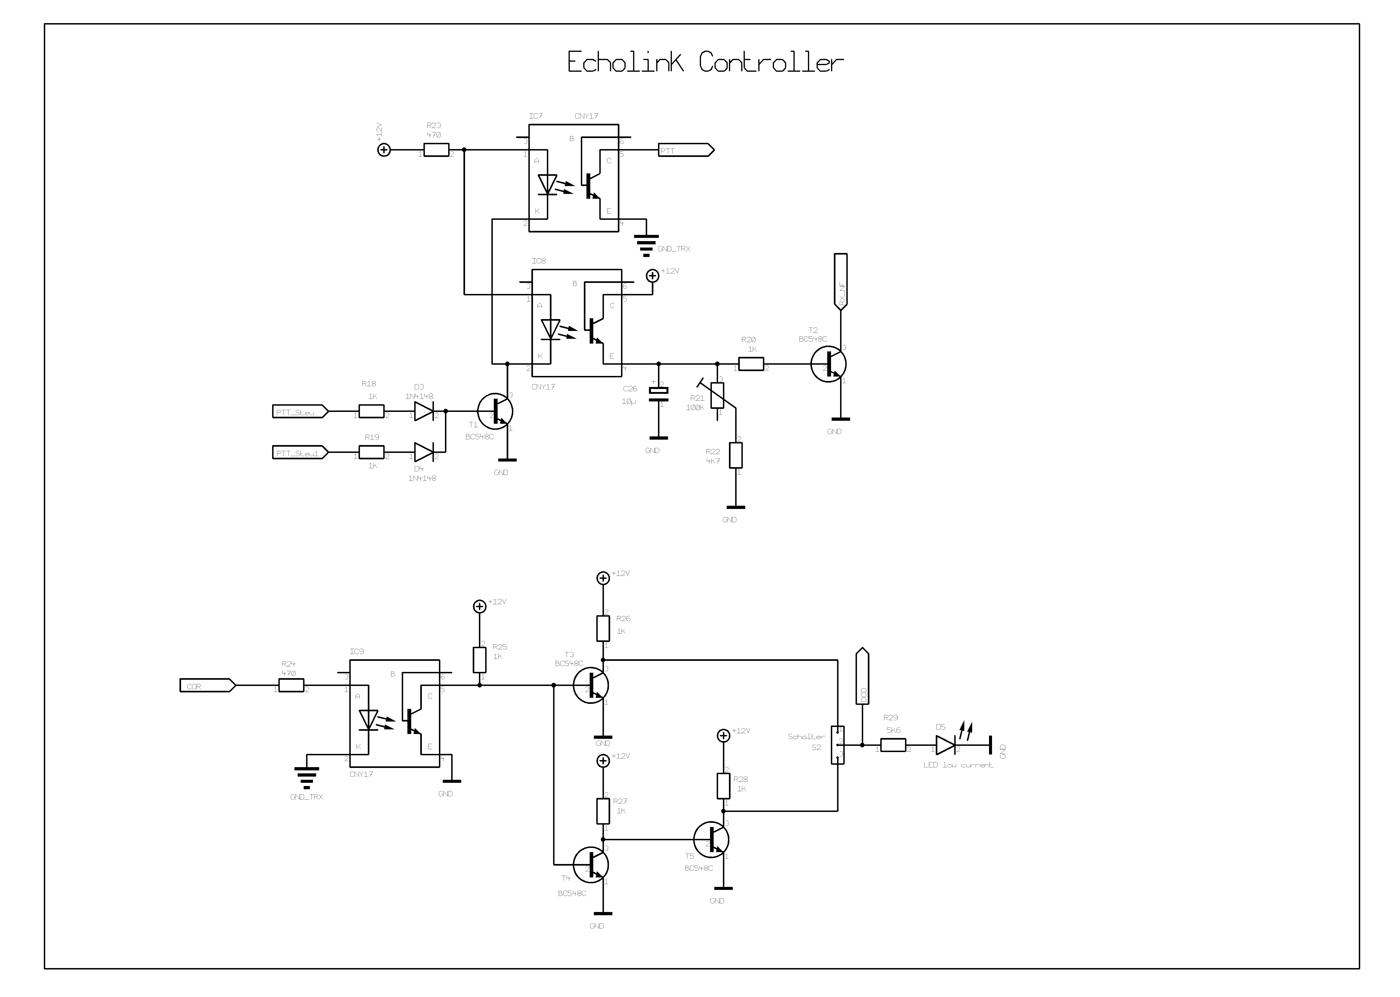
Documentation/Tutorials/Echolink/echolinkschaltung2.png
