mattcarberry/echolink_hardware/Documentation/Tutorials/RandomCircuits/opamp17a.gif

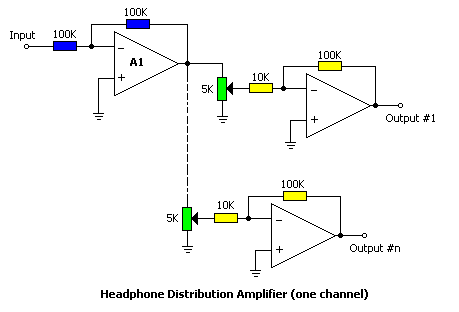
Documentation/Tutorials/RandomCircuits/opamp17a.gif
