mattcarberry/echolink_hardware/Documentation/Tutorials/RandomCircuits/tl06-tl064-audio-distribution.jpg

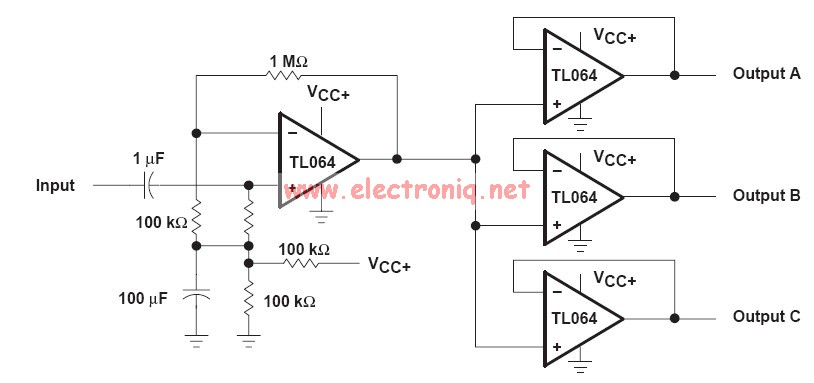
Documentation/Tutorials/RandomCircuits/tl06-tl064-audio-distribution.jpg
