mattcarberry/echolink_hardware/Documentation/Tutorials/squelchschaltung.png

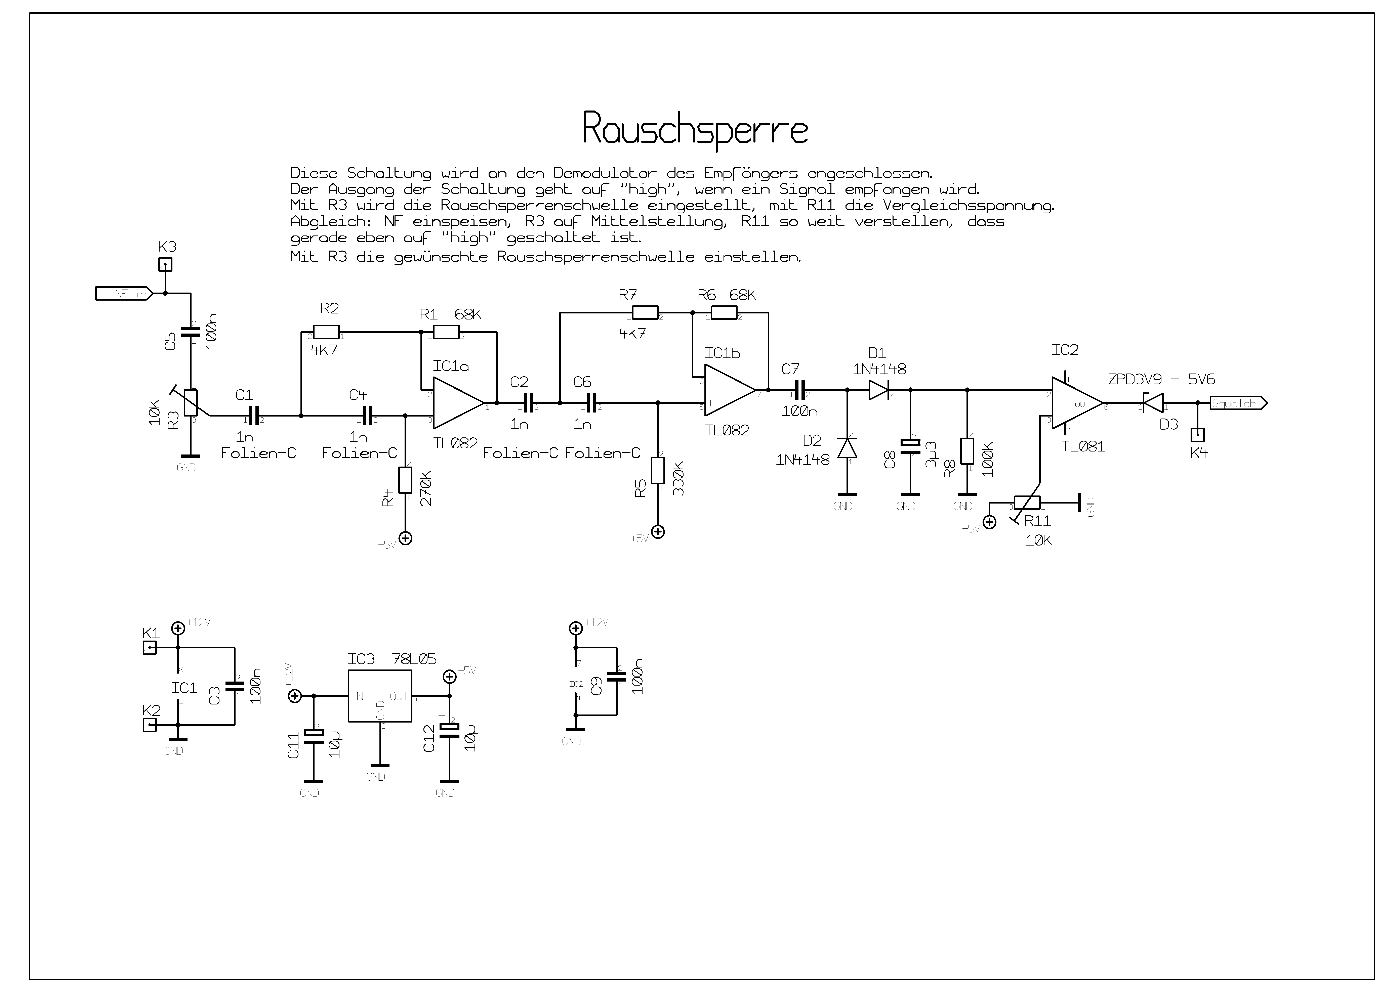
Documentation/Tutorials/squelchschaltung.png
