mattcarberry/echolink_hardware/Documentation/Wolfson Audio Card Schematic Diagram.pdf

### DC IN (+5V)

+5V

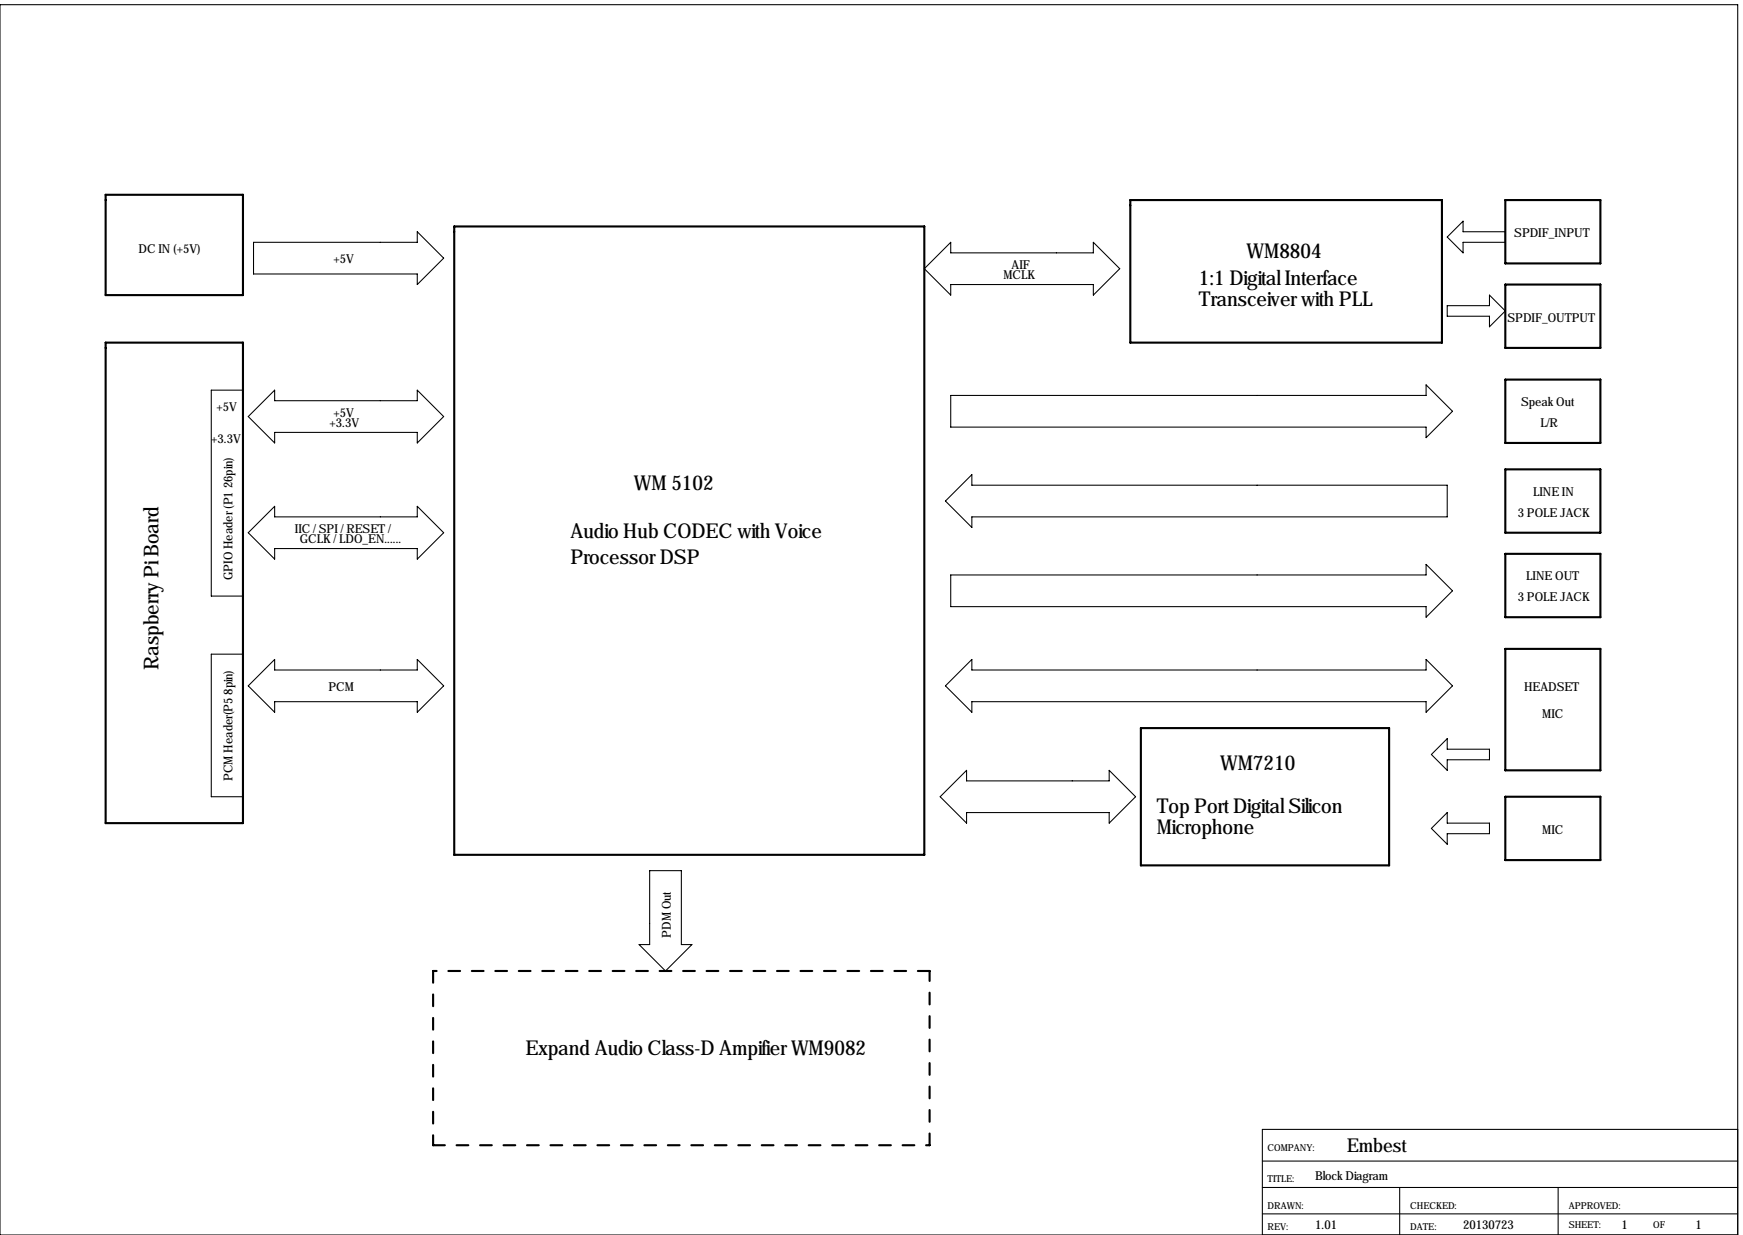
[picture p87: page 1]
Embest; Block Diagram; COMPANY:; TITLE:; PCM; AIF MCLK; SPDIF_INPUT; SPDIF_OUTPUT; LINE IN; LINE OUT; 3 POLE JACK; HEADSET; MIC; Speak Out

1:1 Digital Interface
Transceiver with PLL

+3.3VGPIO Header ⁽P¹ 26pin⁾ PCM Header⁽P5 8pin⁾

Raspberry Pi Board

IIC / SPI / RESET /
GCLK / LDO_EN......

Audio Hub CODEC with Voice
Processor DSP

Top Port Digital Silicon
Microphone

Expand Audio Class-D Ampifier WM9082 PDM Out

DRAWN: | CHECKED: | APPROVED:
REV: | 20130723 DATE: | SHEET: OF

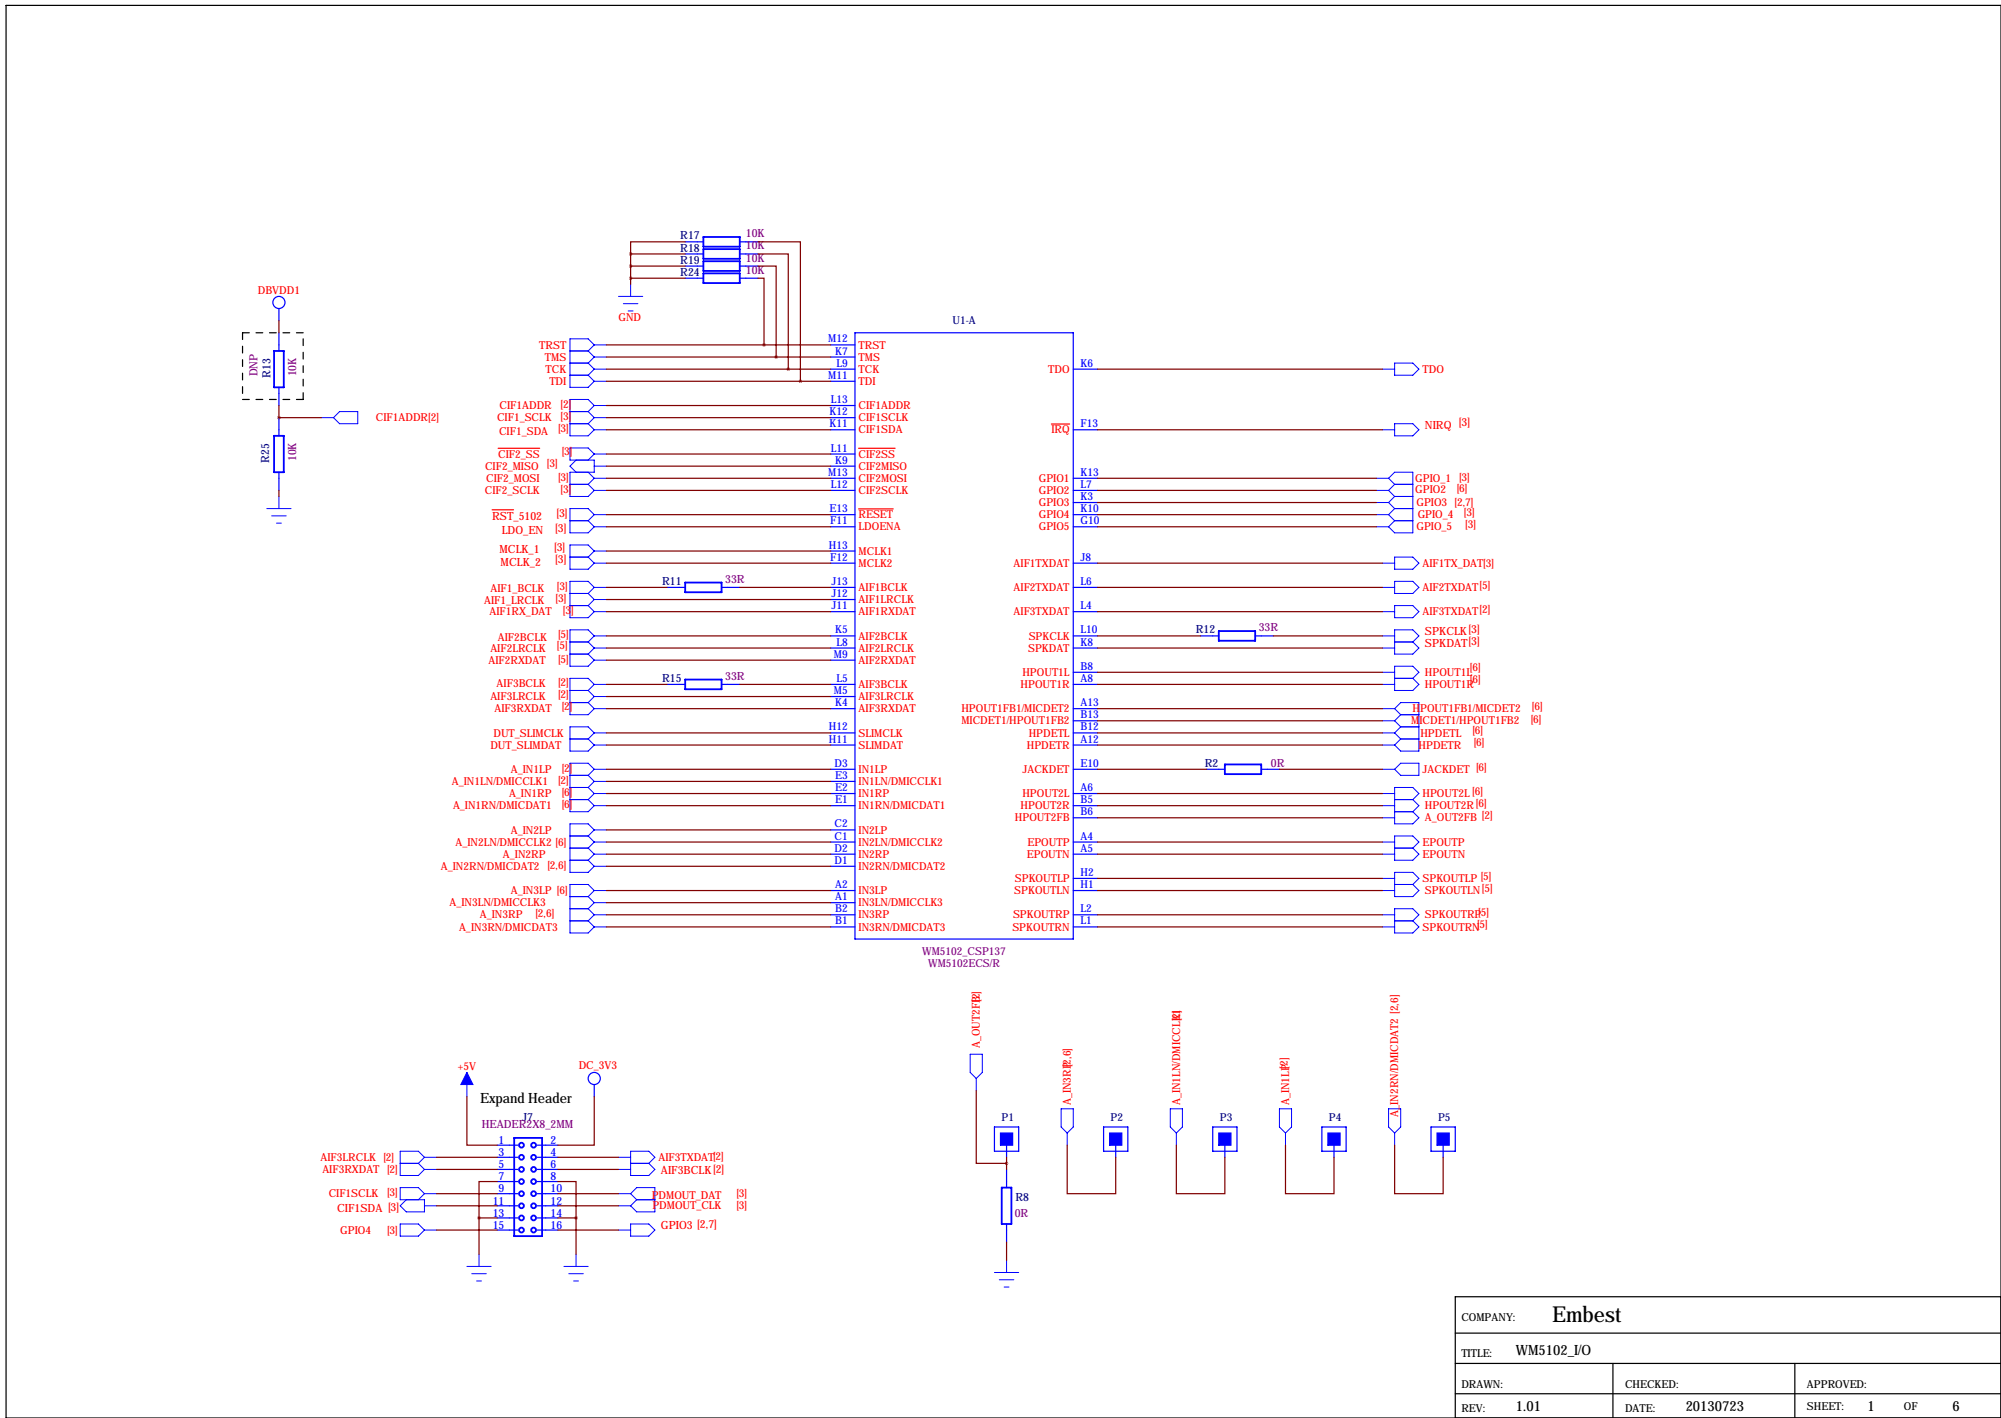
[picture p88: page 2]

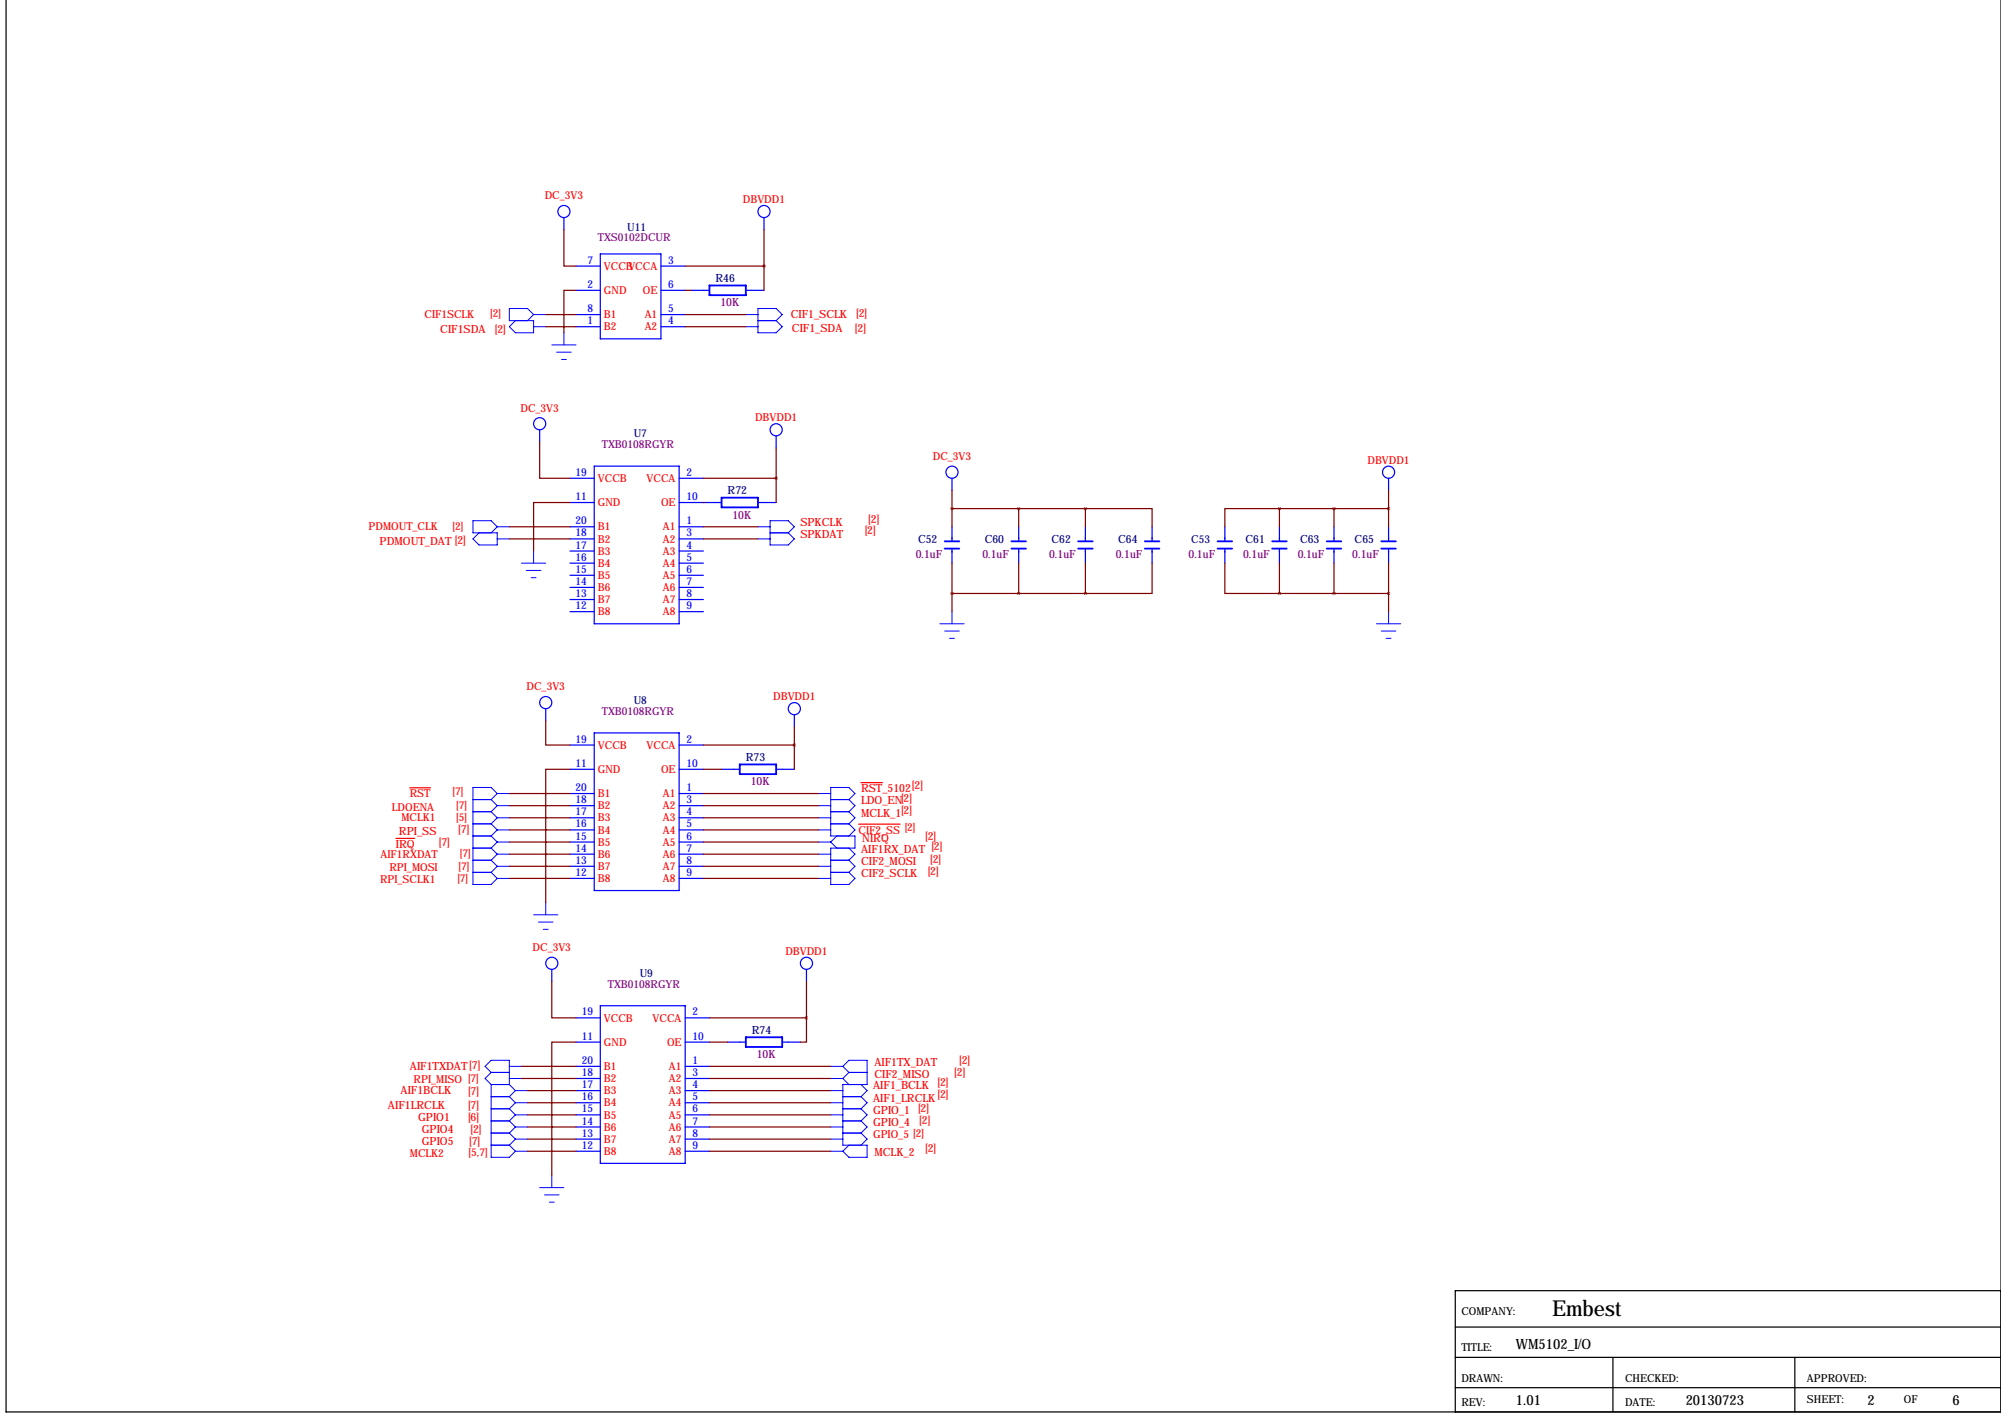
[picture p89: page 3]

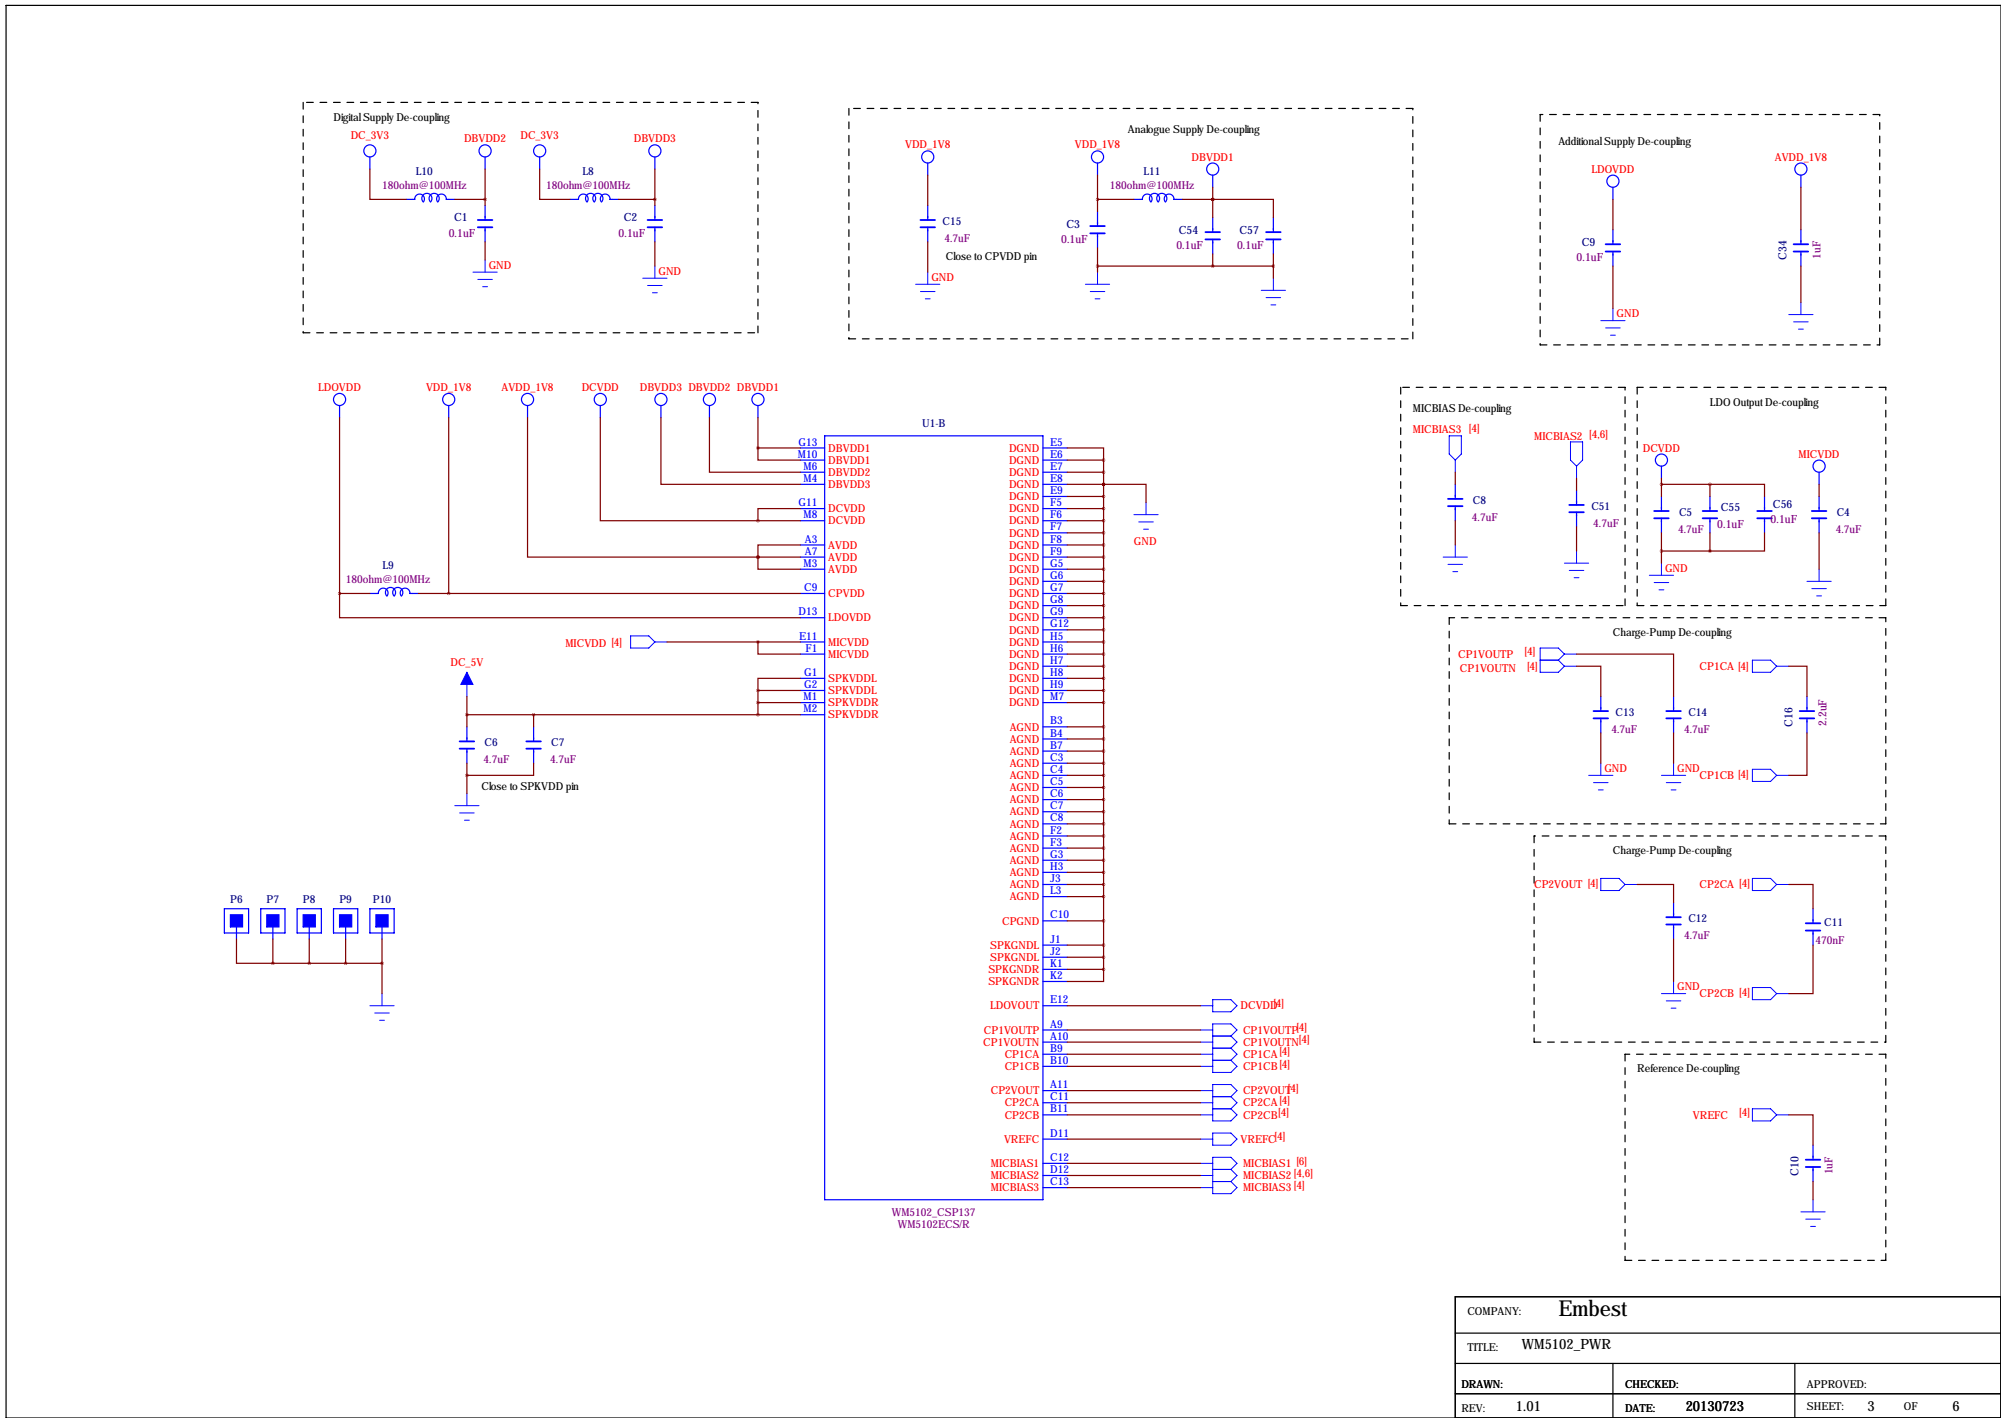
[picture p90: page 4]

Digital Supply De-coupling

Analogue Supply De-coupling

Additional Supply De-coupling

LDO Output De-coupling

Charge-Pump De-coupling

Close to SPKVDD pin

DRAWN: | CHECKED: | APPROVED:
REV: 1.01 | DATE: DATE: 20130723 20130723 | 3 6

## SPEAKER OUTPUTS

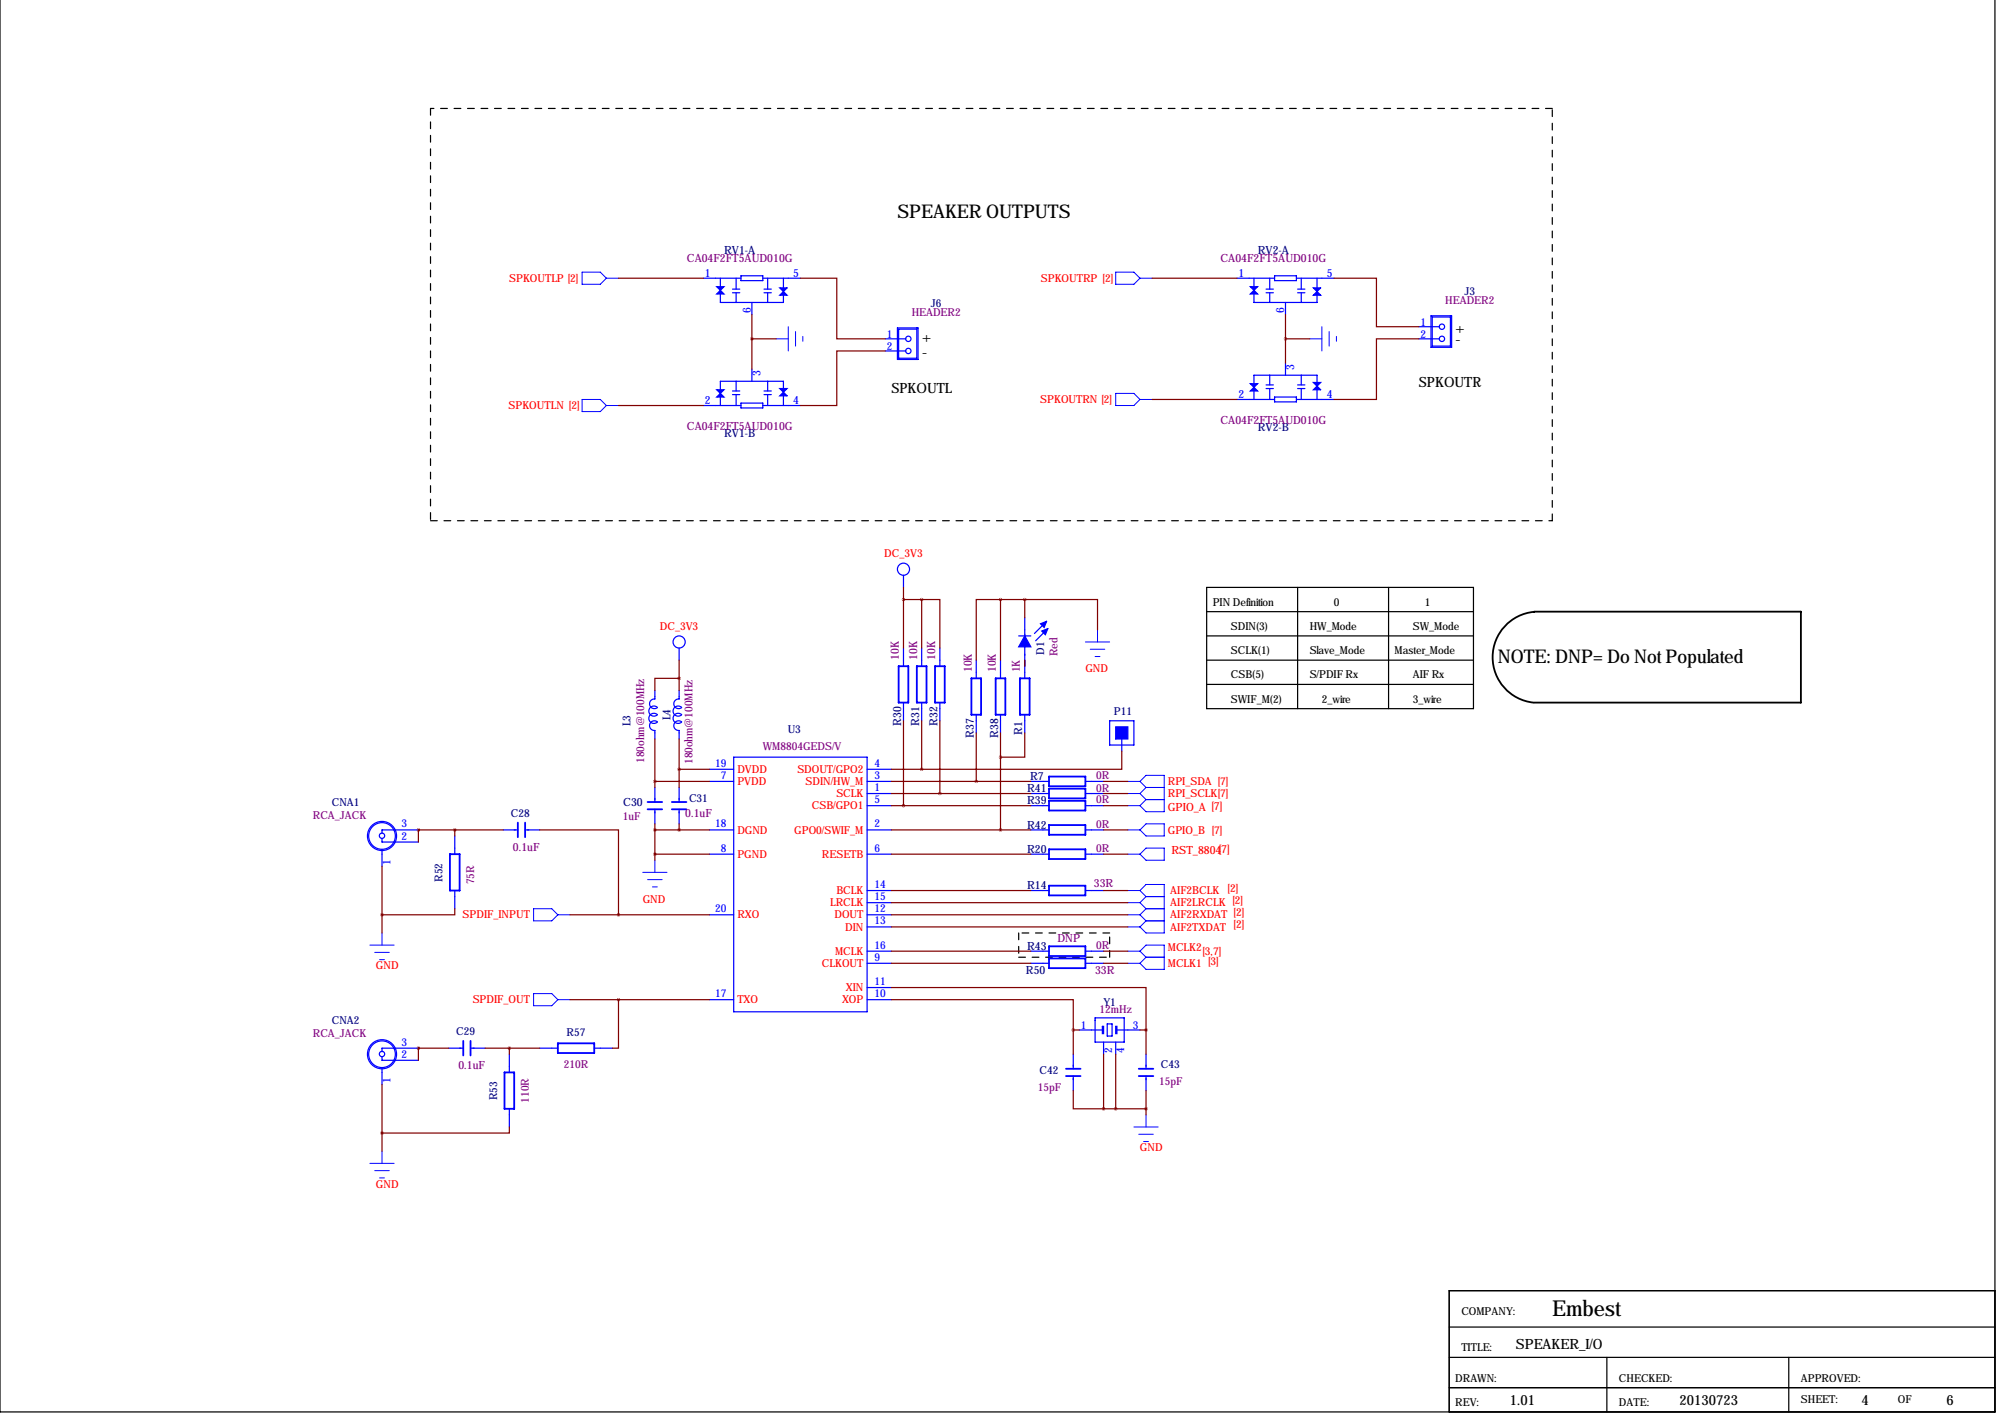
[picture p91: page 5]

PIN Definition | 0 | 1

SDIN(3) | HW_Mode | SW_Mode

SCLK(1) | Slave_Mode | Master_Mode

NOTE: DNP= Do Not Populated

CSB(5) | S/PDIF Rx | AIF Rx

SWIF_M(2) | 2_wire | 3_wire

# line in line out

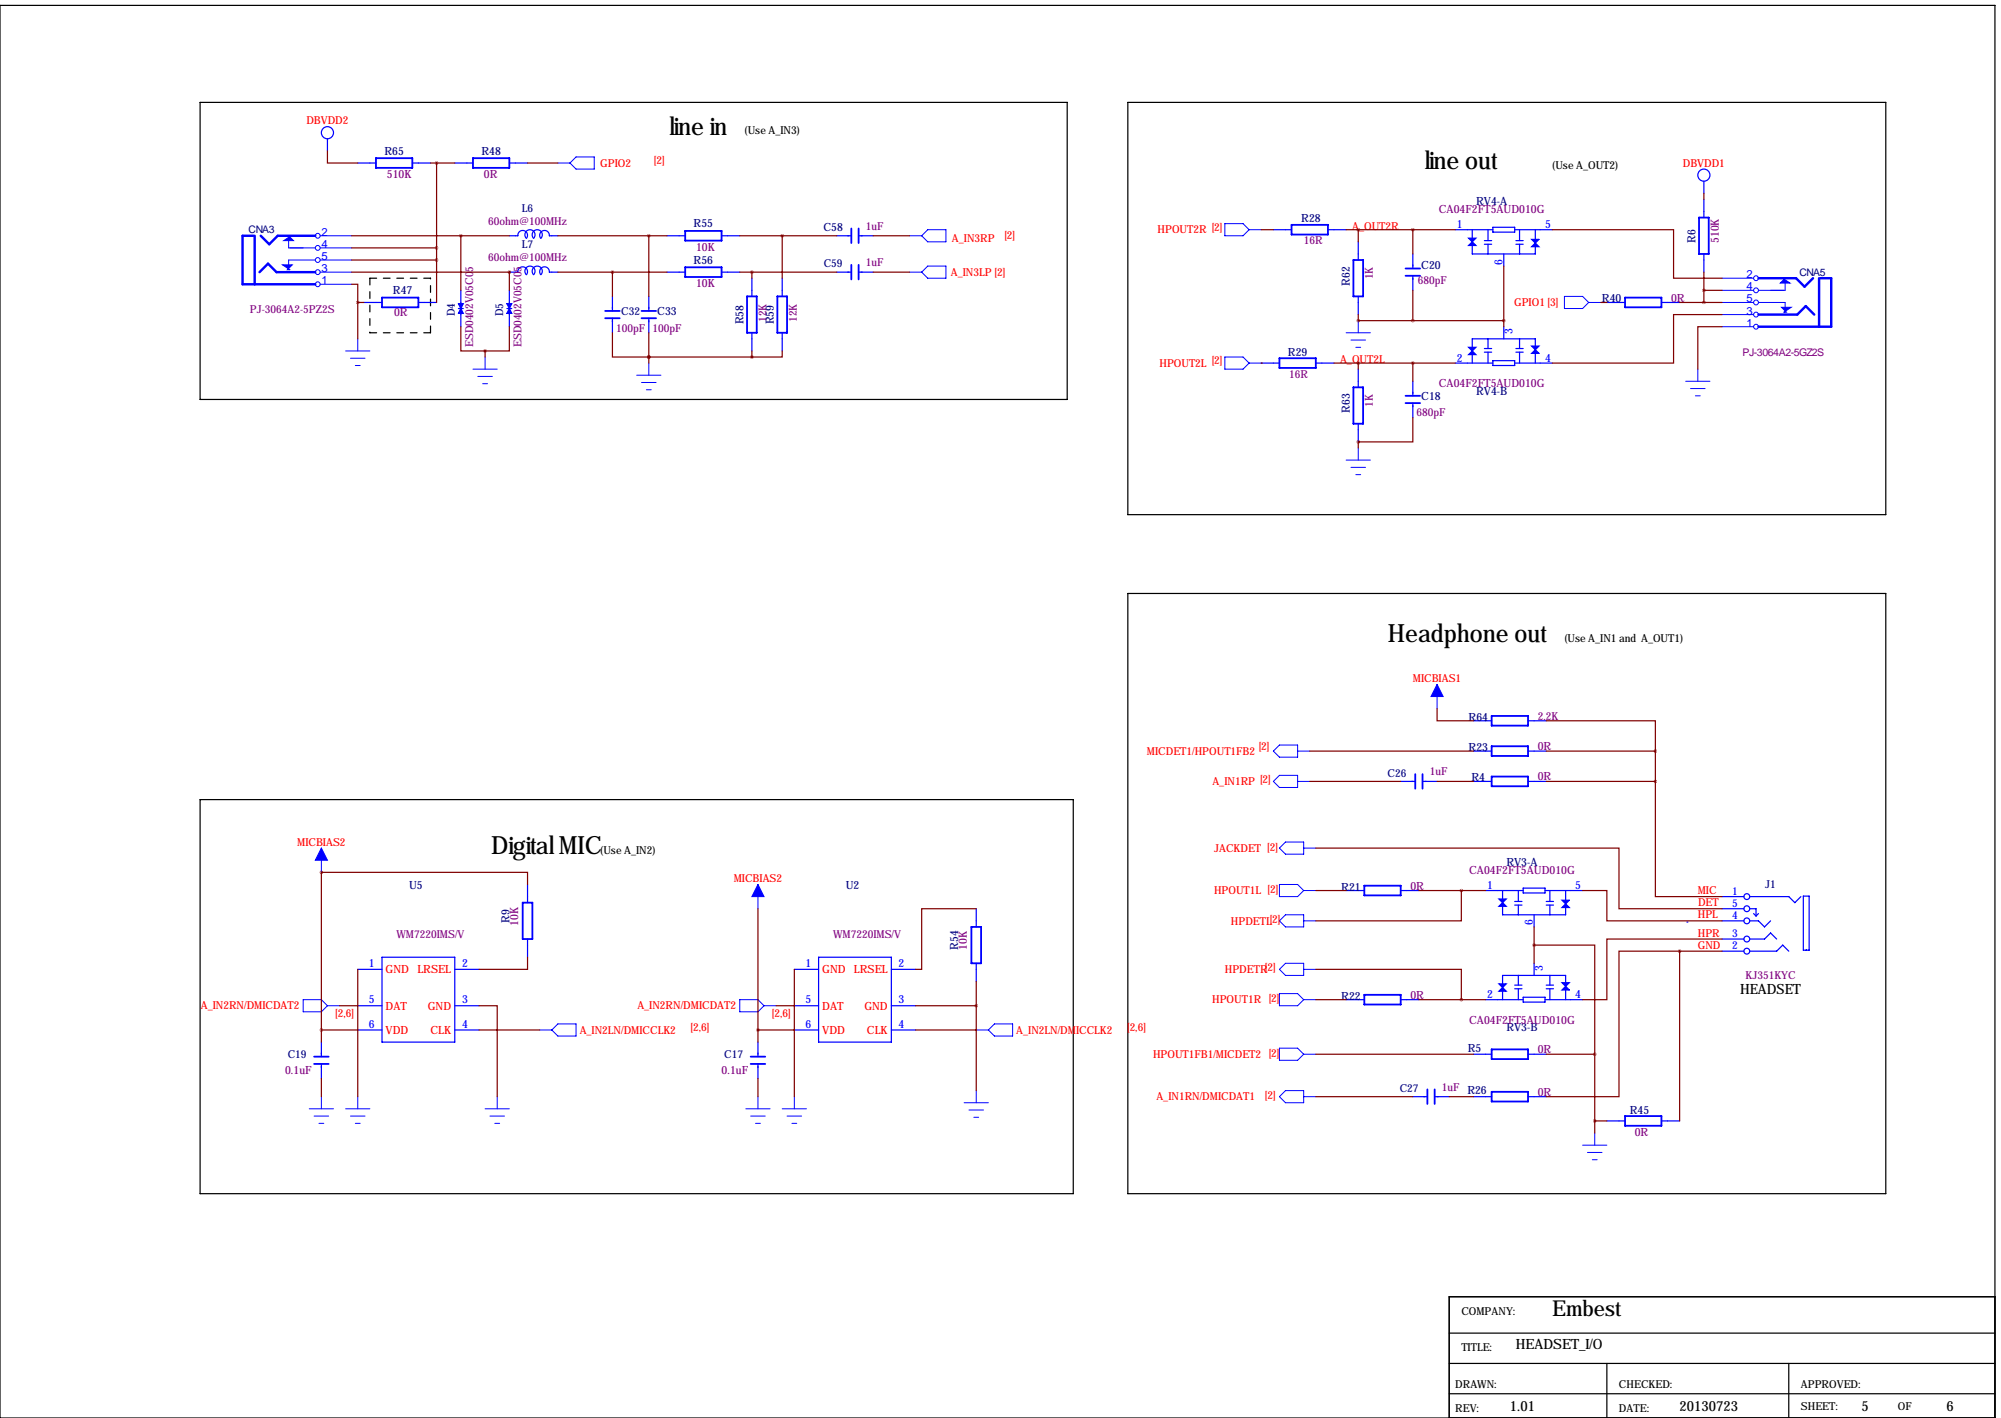
[picture p92: page 6]

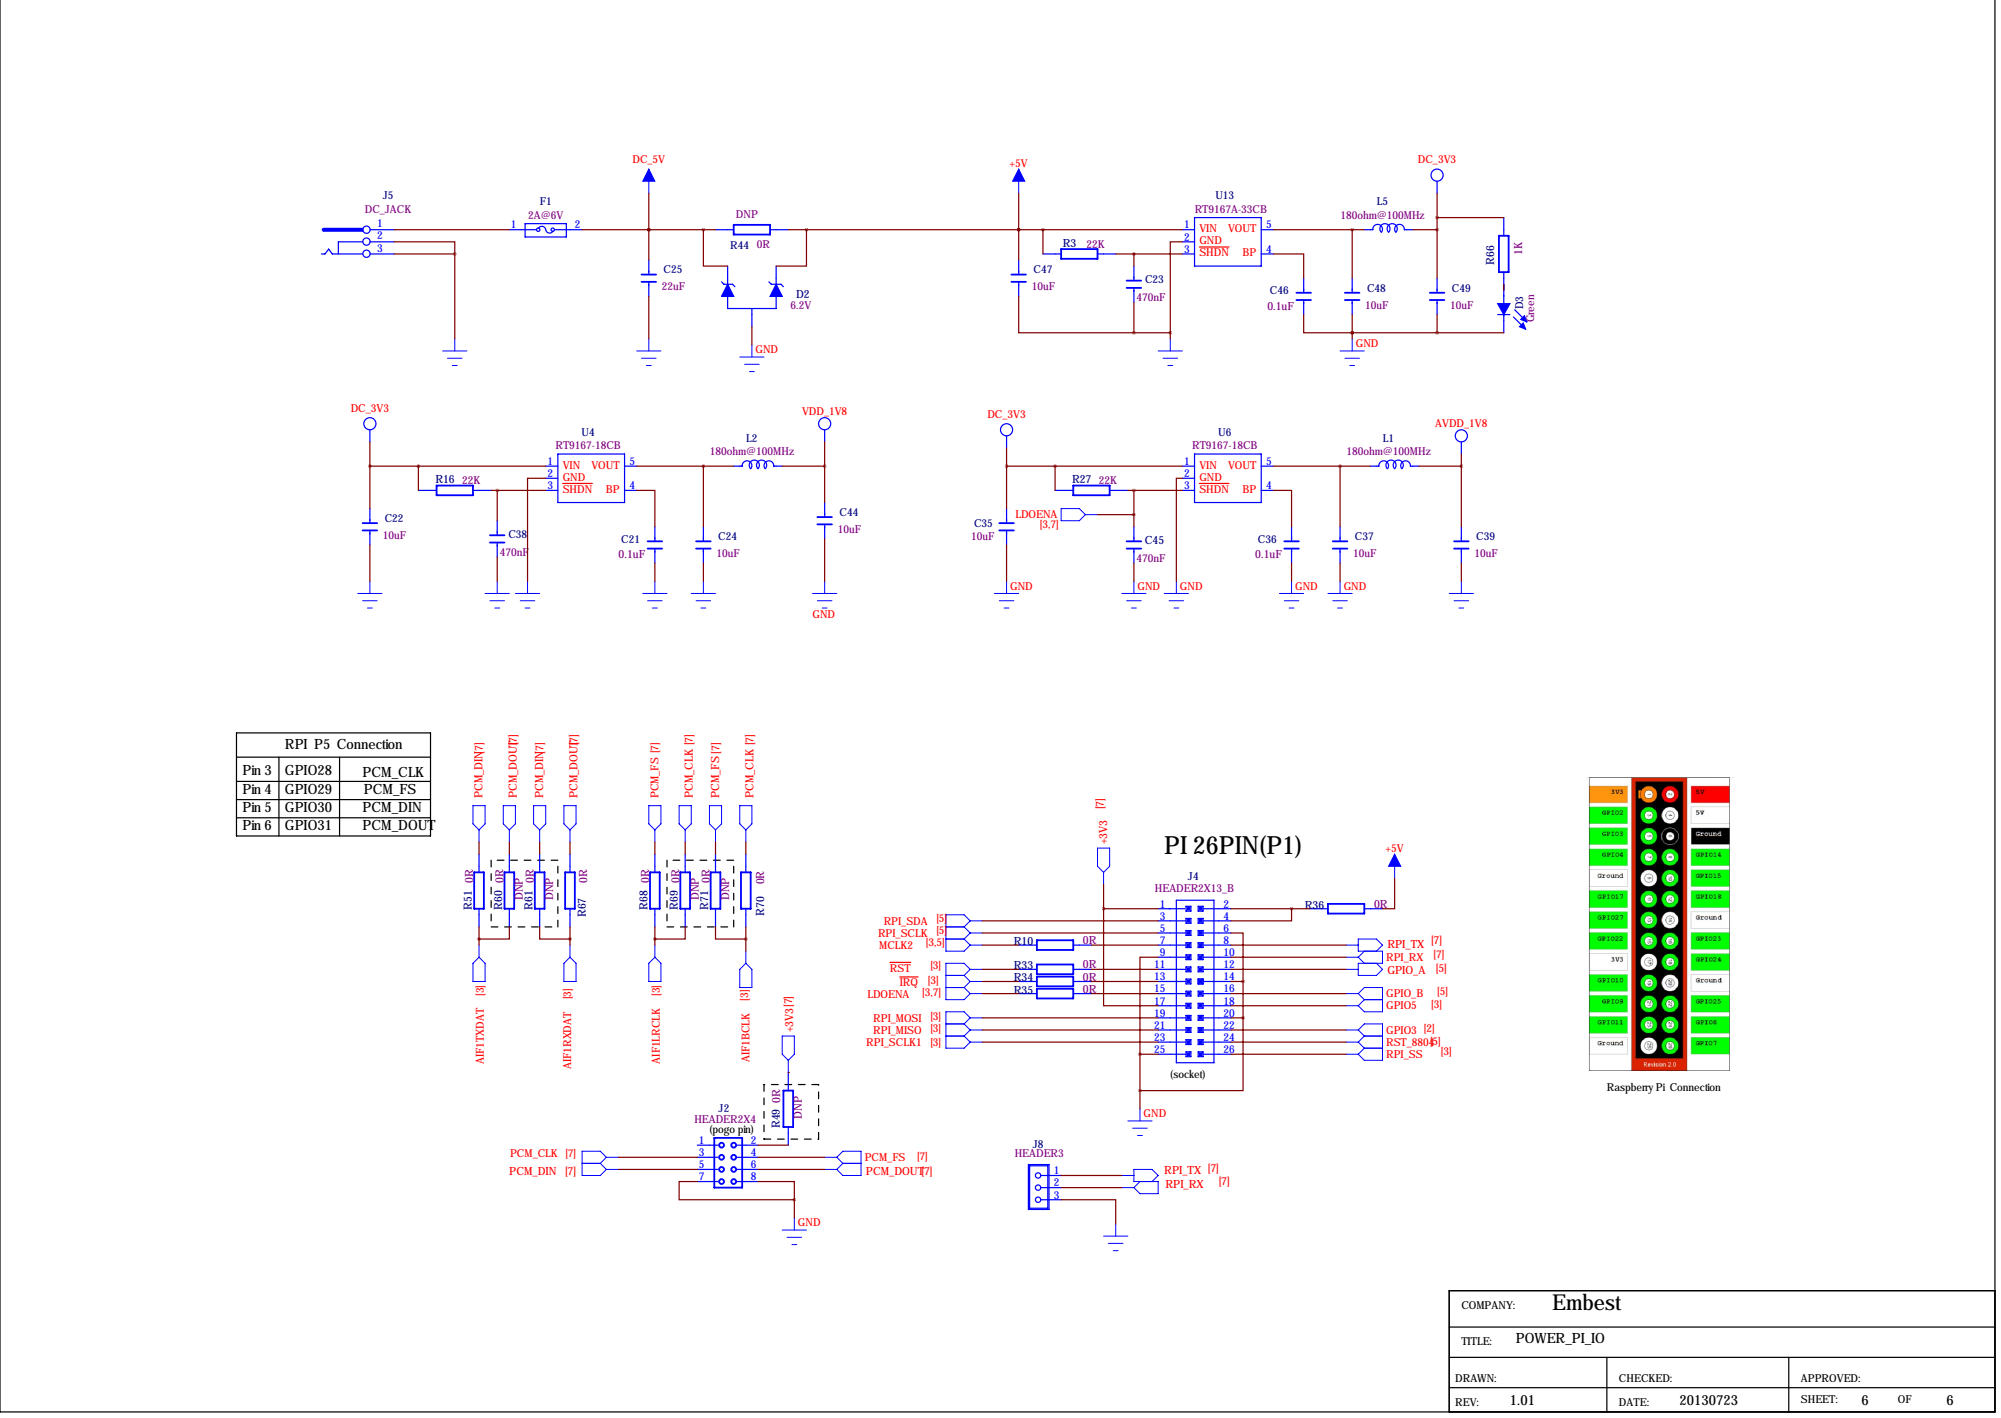
[picture p93: page 7]

Pin 3 | GPIO28 | PCM_CLK
Pin 4 | GPIO29 | PCM_FS
Pin 5 | GPIO30 | PCM_DIN
Pin 6 | GPIO31 | PCM_DOUT
