mattcarberry/echolink_hardware/Documentation/BlockDiagrams/Chassis_PlacementSpecs.pdf

# Dimensions of Fully Integrated System Housing

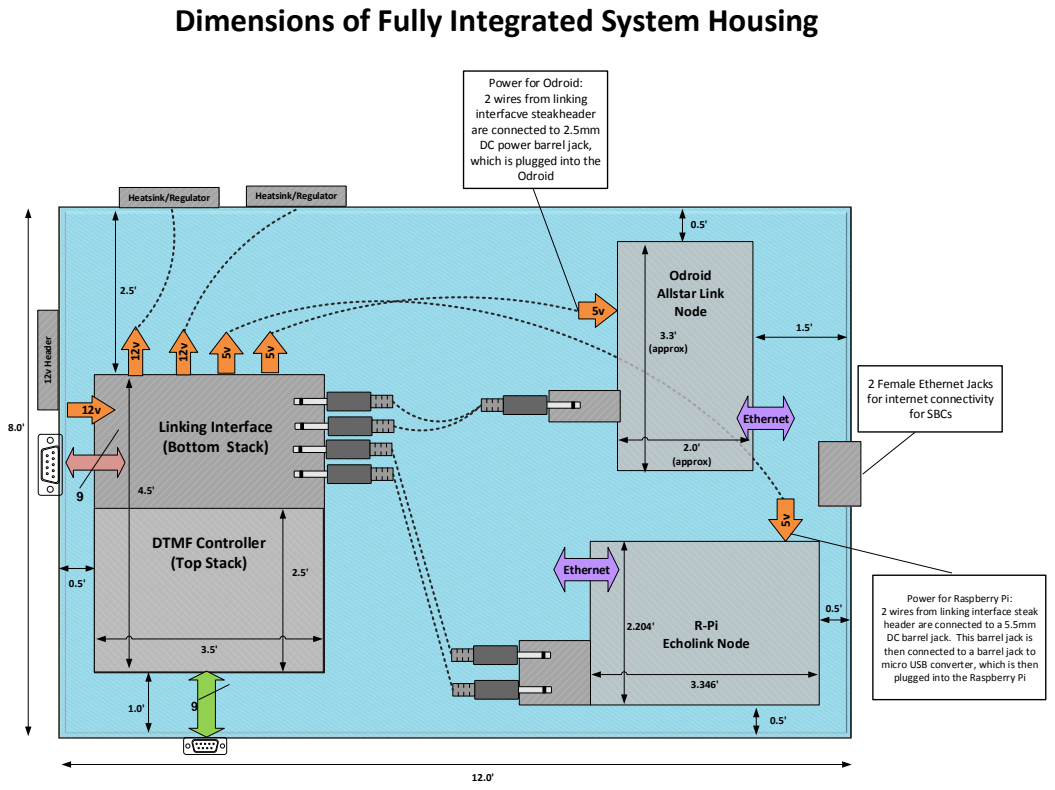
[picture p94: page 1]
DTMF Controller (Top Stack); Linking Interface (Bottom Stack); Ethernet; Odroid Allstar Link Node; R-Pi Echolink Node; Odroid; for SBCs; Heatsink/Regulator; 12v Header; 3.3' (approx); 2.0' (approx)

Power for Odroid:
2 wires from linking
interfacve steakheader
are connected to 2.5mm
DC power barrel jack,
which is plugged into the

2 Female Ethernet Jacks
for internet connectivity

Power for Raspberry Pi:
2 wires from linking interface steak
header are connected to a 5.5mm
DC barrel jack. This barrel jack is
then connected to a barrel jack to
micro USB converter, which is then
plugged into the Raspberry Pi
