mattcarberry/echolink_hardware/Documentation/voter.pdf

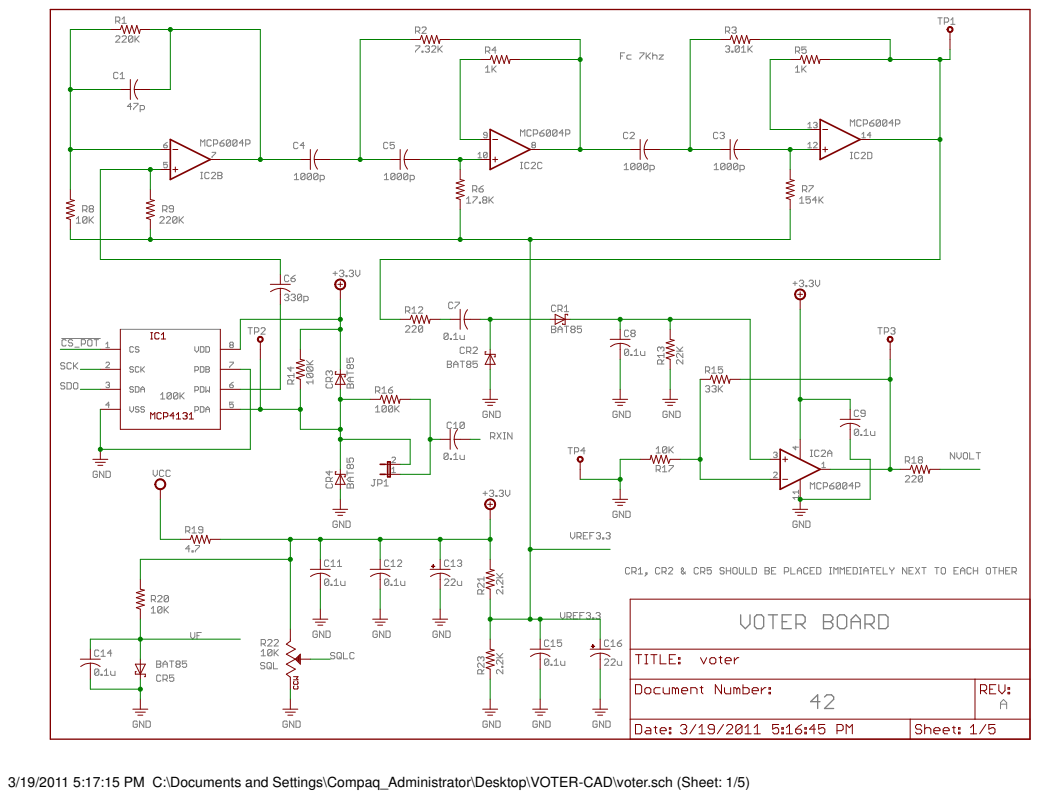
[picture p95: page 1]

3/19/2011 5:17:15 PM C:\Documents and Settings\Compaq_Administrator\Desktop\VOTER-CAD\voter.sch (Sheet: 1/5)

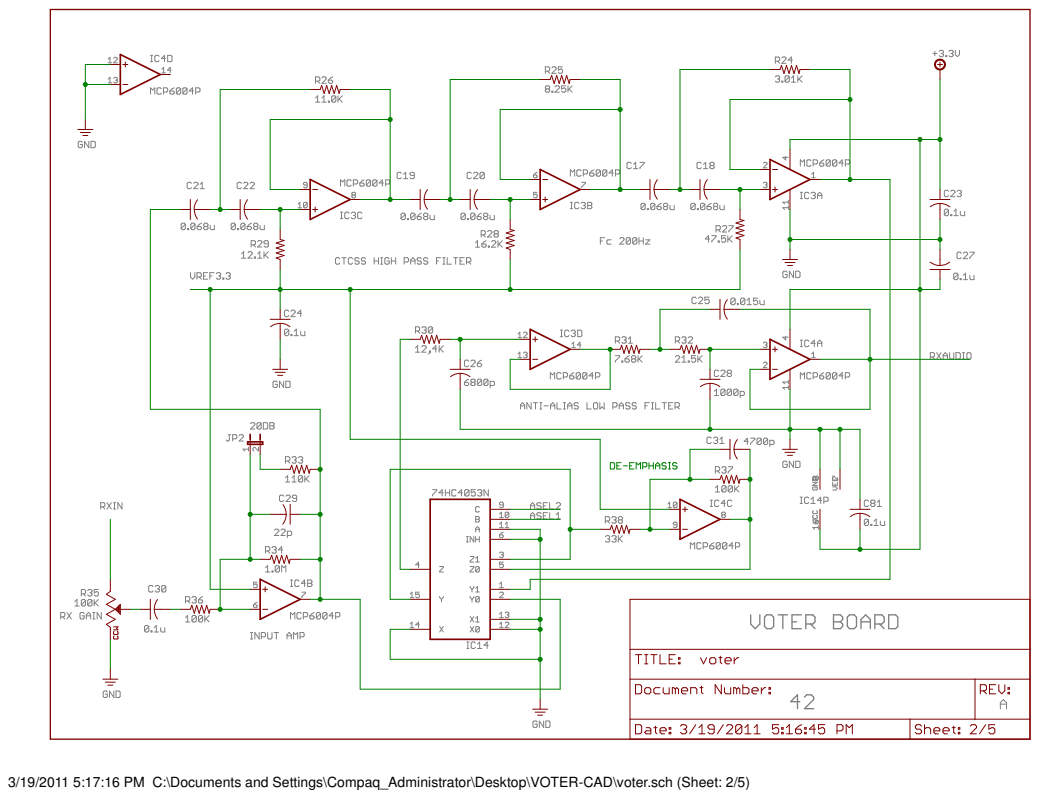
[picture p96: page 2]

3/19/2011 5:17:16 PM C:\Documents and Settings\Compaq_Administrator\Desktop\VOTER-CAD\voter.sch (Sheet: 2/5)

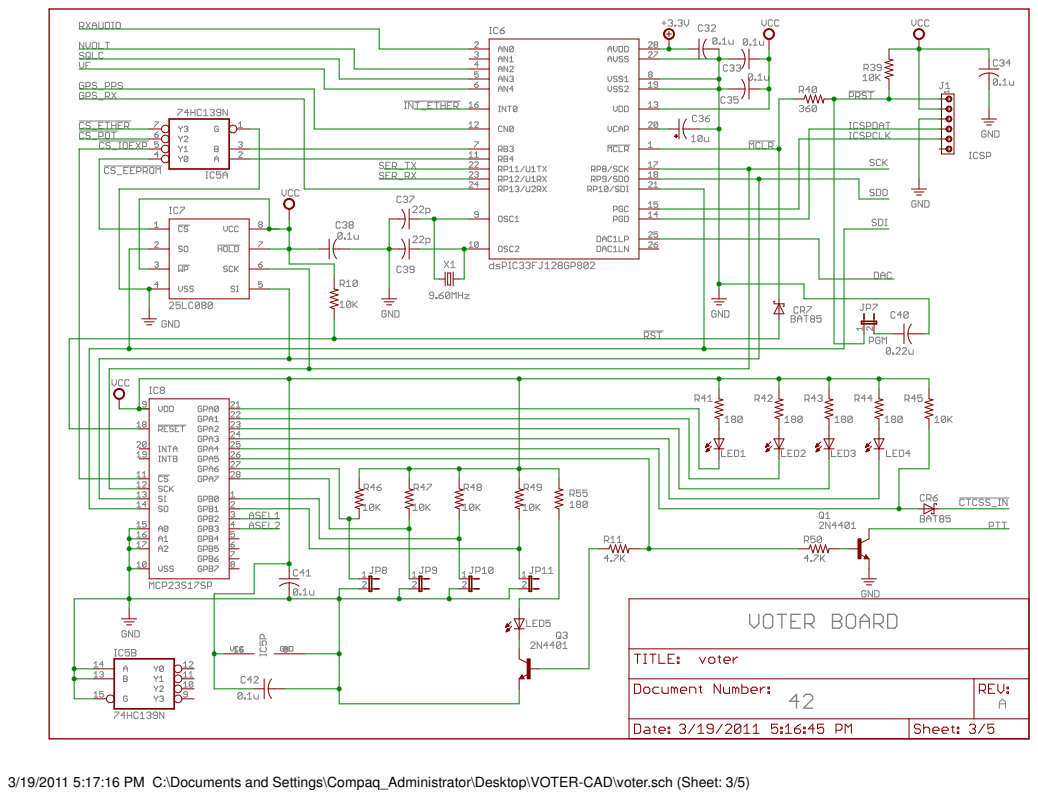
[picture p97: page 3]

3/19/2011 5:17:16 PM C:\Documents and Settings\Compaq_Administrator\Desktop\VOTER-CAD\voter.sch (Sheet: 3/5)

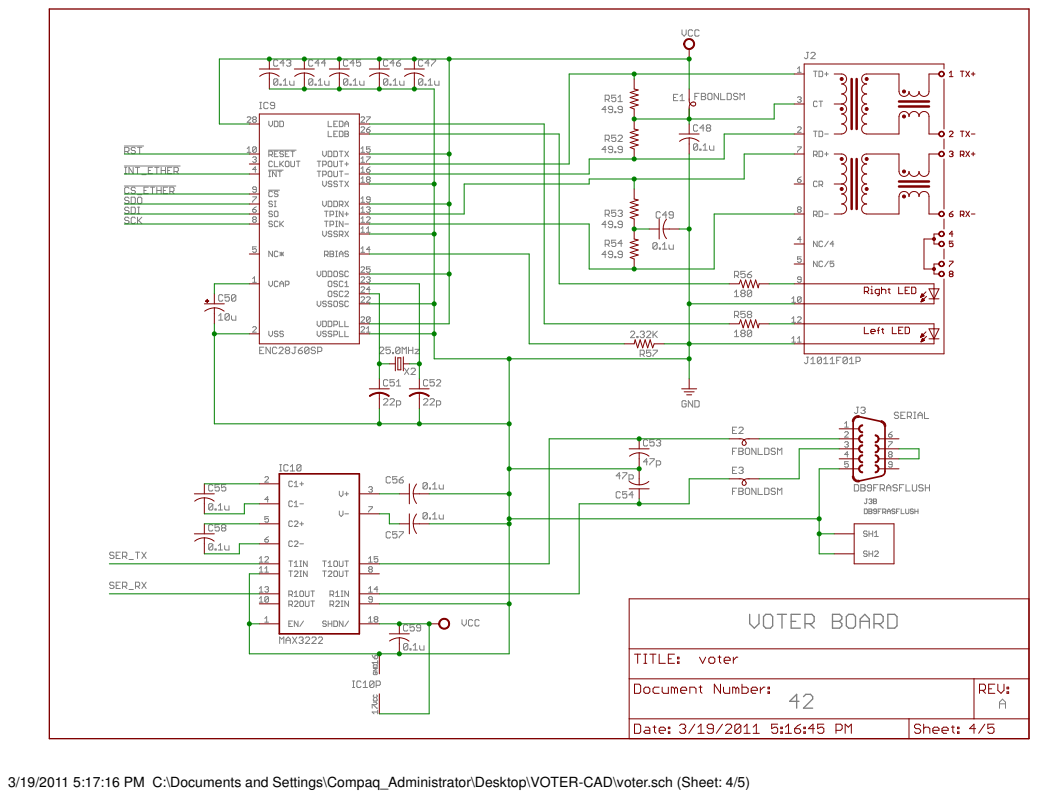
[picture p98: page 4]

3/19/2011 5:17:16 PM C:\Documents and Settings\Compaq_Administrator\Desktop\VOTER-CAD\voter.sch (Sheet: 4/5)

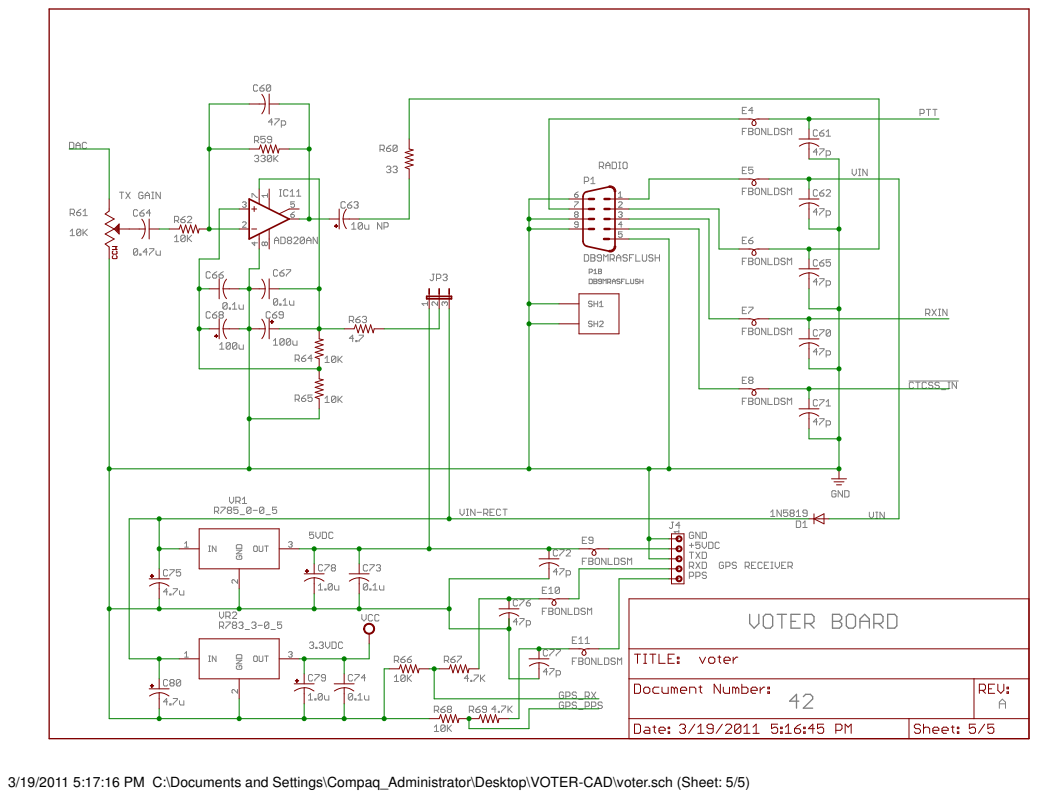
[picture p99: page 5]

3/19/2011 5:17:16 PM C:\Documents and Settings\Compaq_Administrator\Desktop\VOTER-CAD\voter.sch (Sheet: 5/5)
