mattcarberry/echolink_hardware/Documentation/BlockDiagrams/FullSystemBlockDiagram.pdf

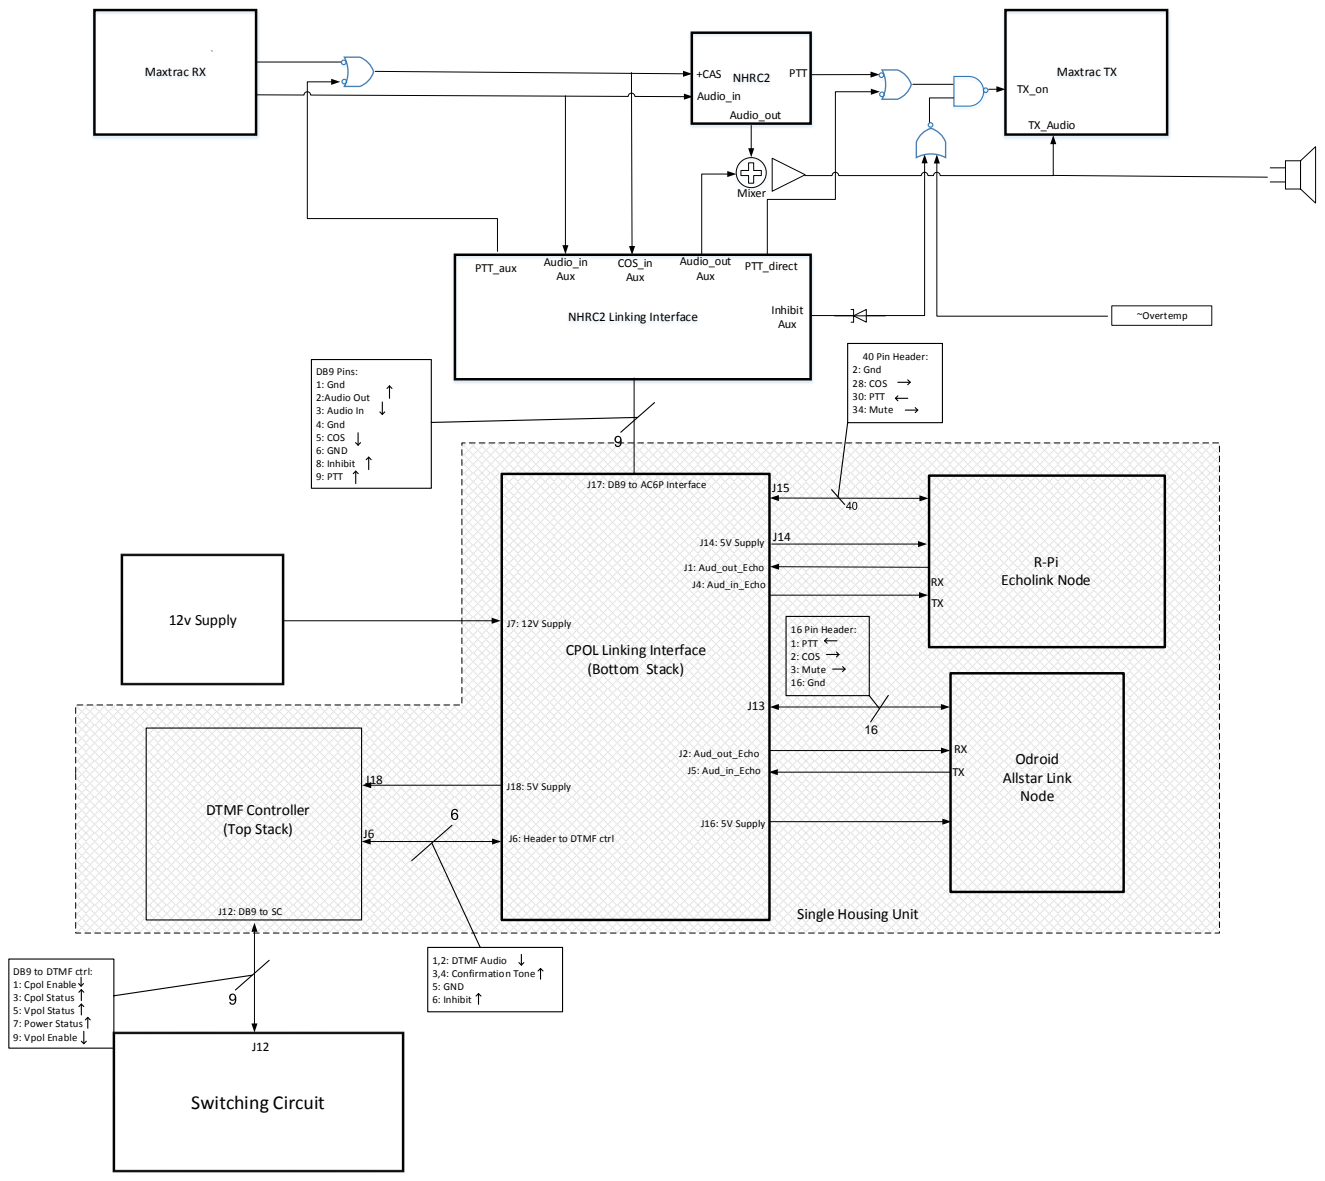
[picture p100: page 1]
DTMF Controller (Top Stack); R-Pi Echolink Node; Odroid Allstar Link Node; Switching Circuit; 12v Supply; J1: Aud_out_Echo; J16: 5V Supply; J17: DB9 to AC6P Interface; J6: Header to DTMF ctrl; Maxtrac RX; Maxtrac TX; NHRC2 Linking Interface; NHRC2; PTT_aux; Audio_in Aux; COS_in Aux; Audio_out Aux; PTT_direct; Mixer; Inhibit Aux; +CAS; PTT; Audio_in Audio_out; TX_Audio; J4: Aud_in_Echo; J2: Aud_out_Echo; J5: Aud_in_Echo; J14: 5V Supply; J7: 12V Supply; J18: 5V Supply; ~Overtemp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

CPOL Linking Interface
(Bottom Stack)

Single Housing Unit

DB9 to DTMF ctrl:
1: Cpol Enable
3: Cpol Status
5: Vpol Status
7: Power Status
9: Vpol Enable
