mattcarberry/echolink_hardware/Documentation/BlockDiagrams/FullSystemBlockDiagram_Final.pdf

# CPOL, DTMF CTRL, RoIP System Integration Block Diagram

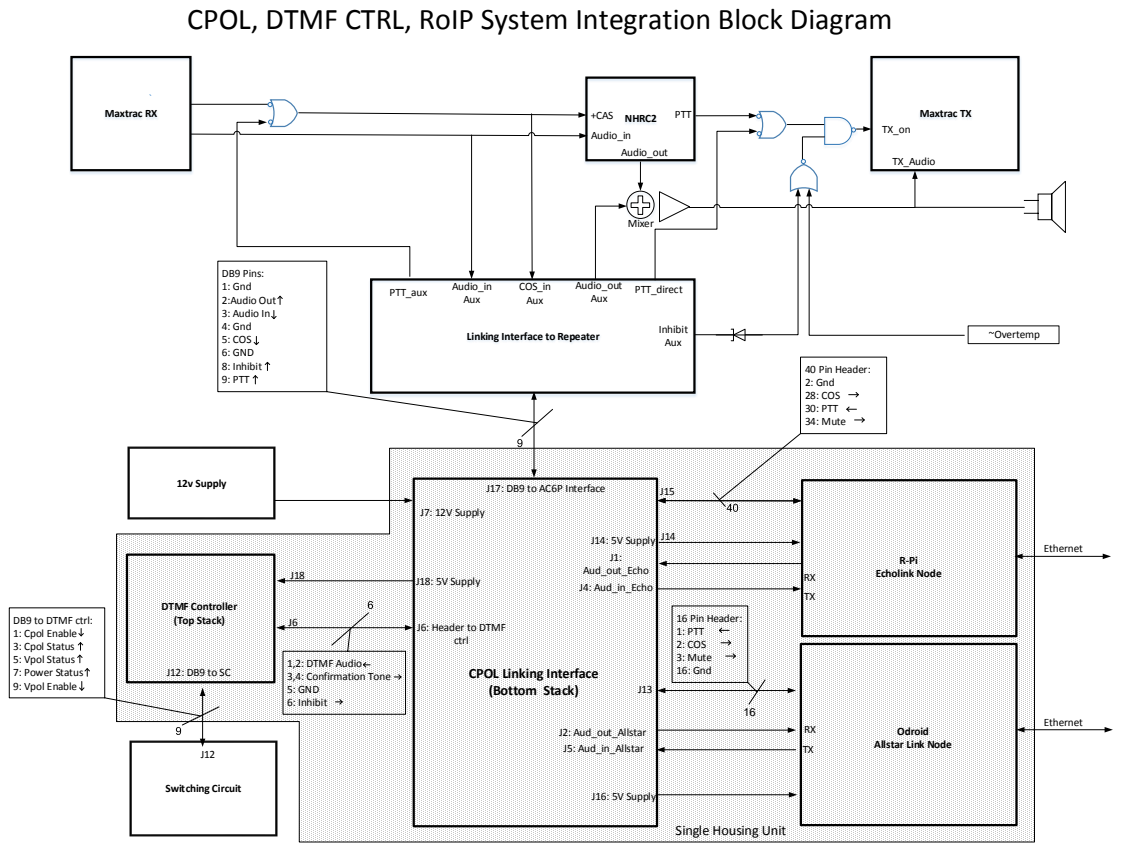
[picture p101: page 1]
DTMF Controller (Top Stack); R-Pi Echolink Node; Switching Circuit; 12v Supply; J1: Aud_out_Echo; J16: 5V Supply; J17: DB9 to AC6P Interface; ctrl; Maxtrac RX; Maxtrac TX; NHRC2; PTT_aux; Audio_in Aux; COS_in Aux; Audio_out Aux; PTT_direct; Mixer; Inhibit Aux; +CAS; PTT; Audio_in Audio_out; TX_Audio; J4: Aud_in_Echo; J2: Aud_out_Allstar J5: Aud_in_Allstar; J14: 5V Supply; J7: 12V Supply; J18: 5V Supply; ~Overtemp; DB9 Pins: 1: Gnd 2:Audio Out 3: Audio In 4: Gnd 5: COS 6: GND 8: Inhibit 9: PTT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

Linking Interface to Repeater

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

J6: Header to DTMF

CPOL Linking Interface
(Bottom Stack)

Odroid
Allstar Link Node

Single Housing Unit
