mattcarberry/echolink_hardware/Documentation/BlockDiagrams/SystemBlockDiagram_ALLStar.pdf

# C-Pol DTMF Switching System With AllStar Link Node

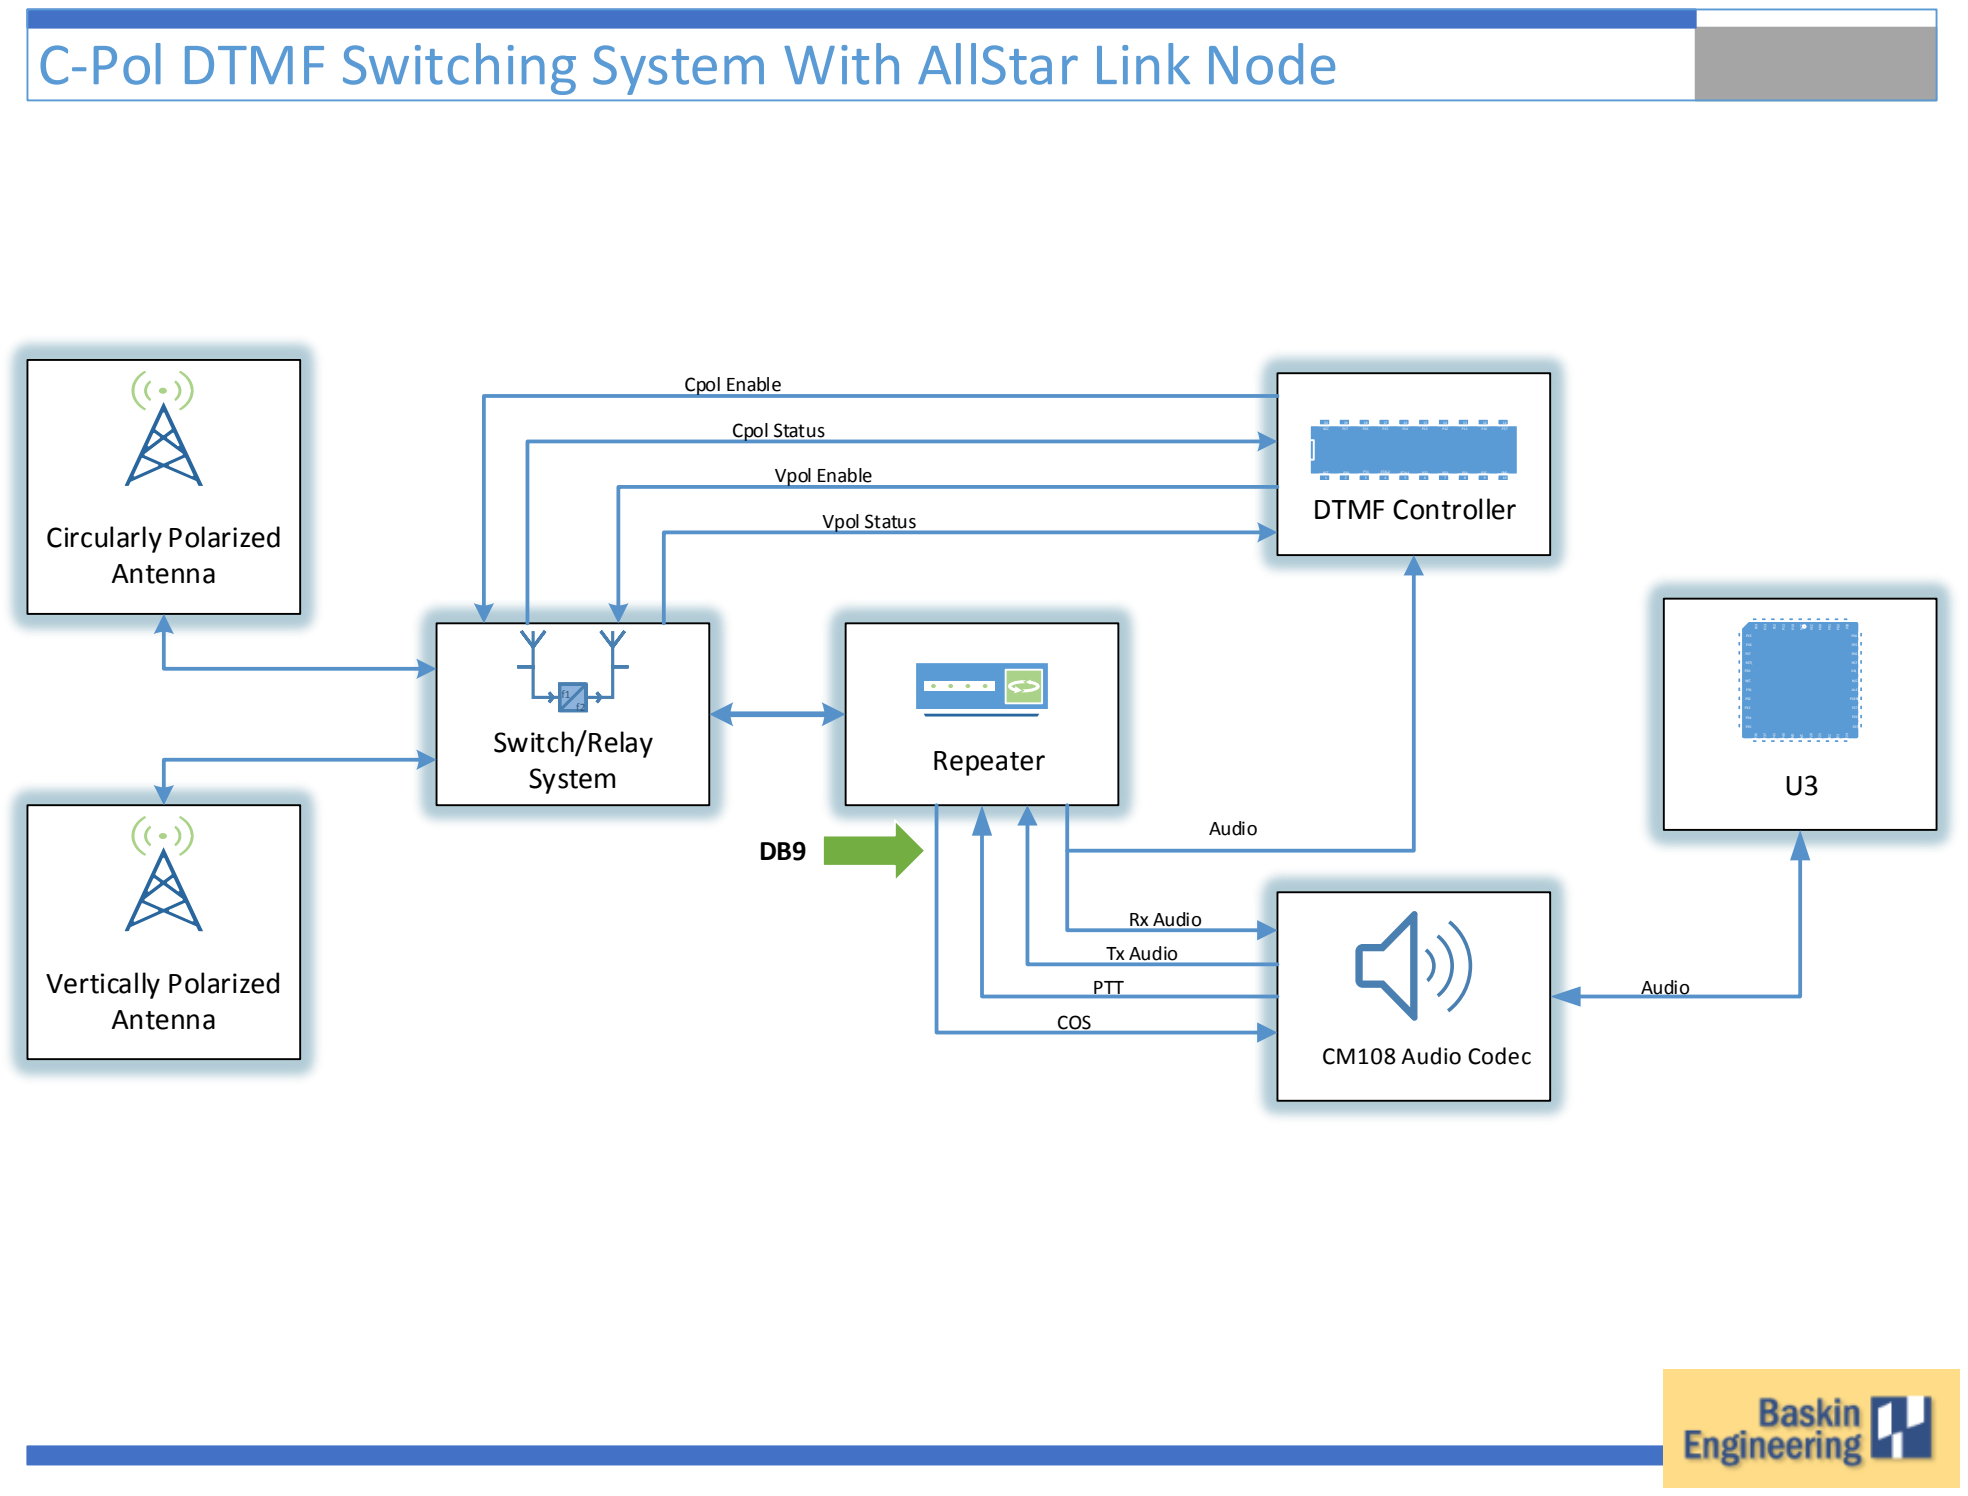
[picture p102: page 1]

Audio

Rx Audio
