mattcarberry/echolink_hardware/Documentation/BlockDiagrams/SystemBlockDiagram_EcholinkANDAllstr.pdf

# C-Pol DTMF Switching System With AllStar Link Node

# Cpol Enable

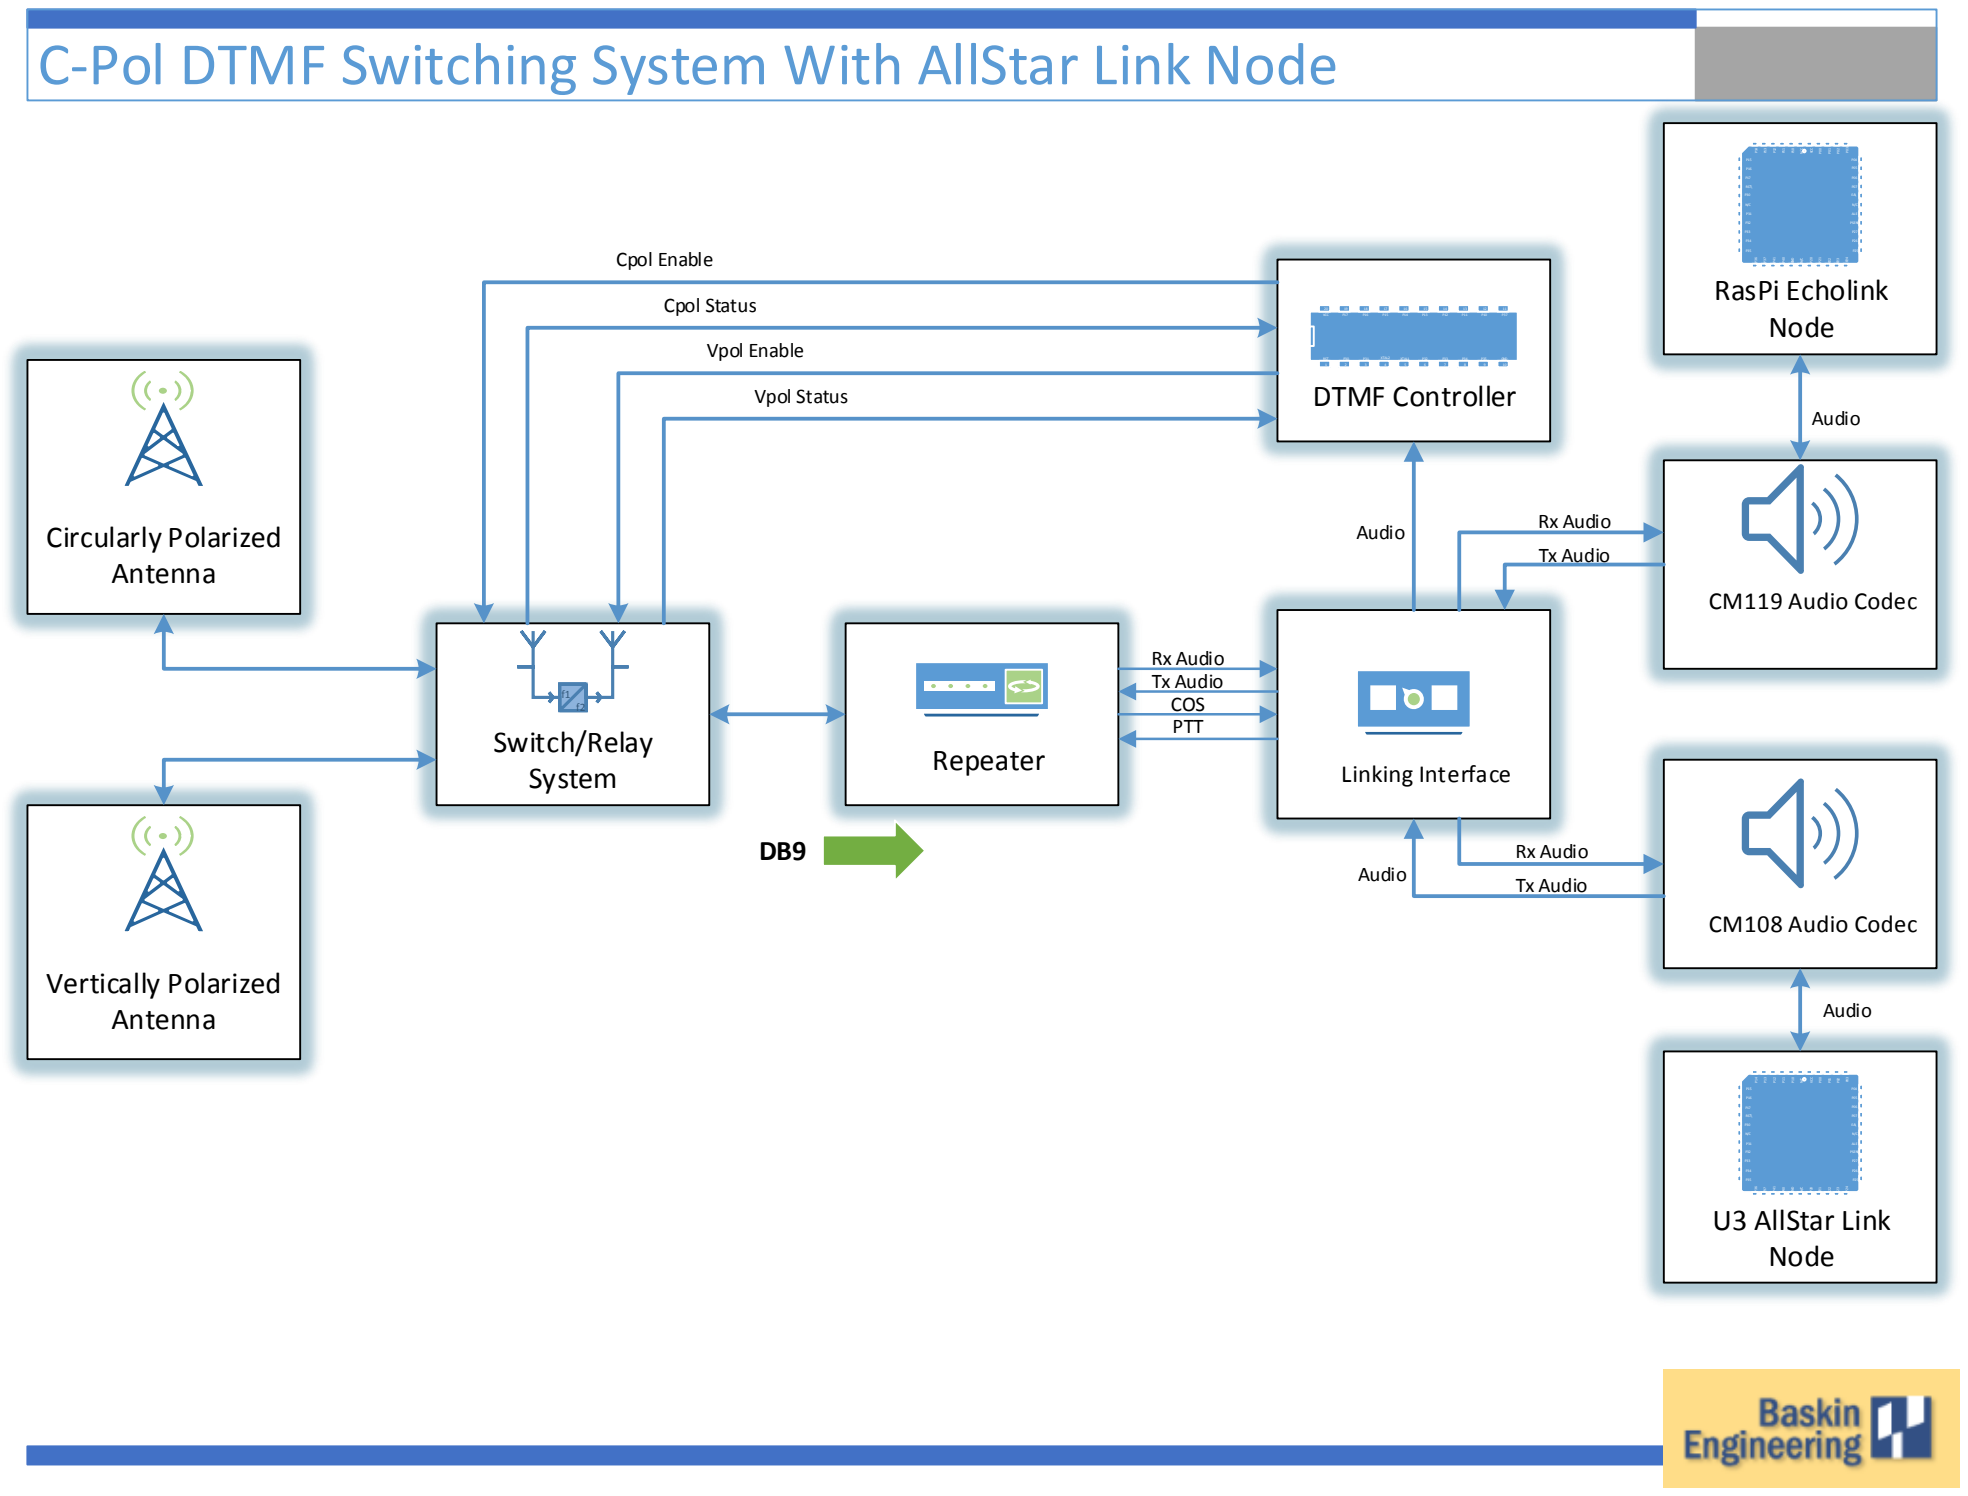
[picture p103: page 1]
