mattcarberry/echolink_hardware/Documentation/BlockDiagrams/SystemIntegrationCasingMockUp.pdf

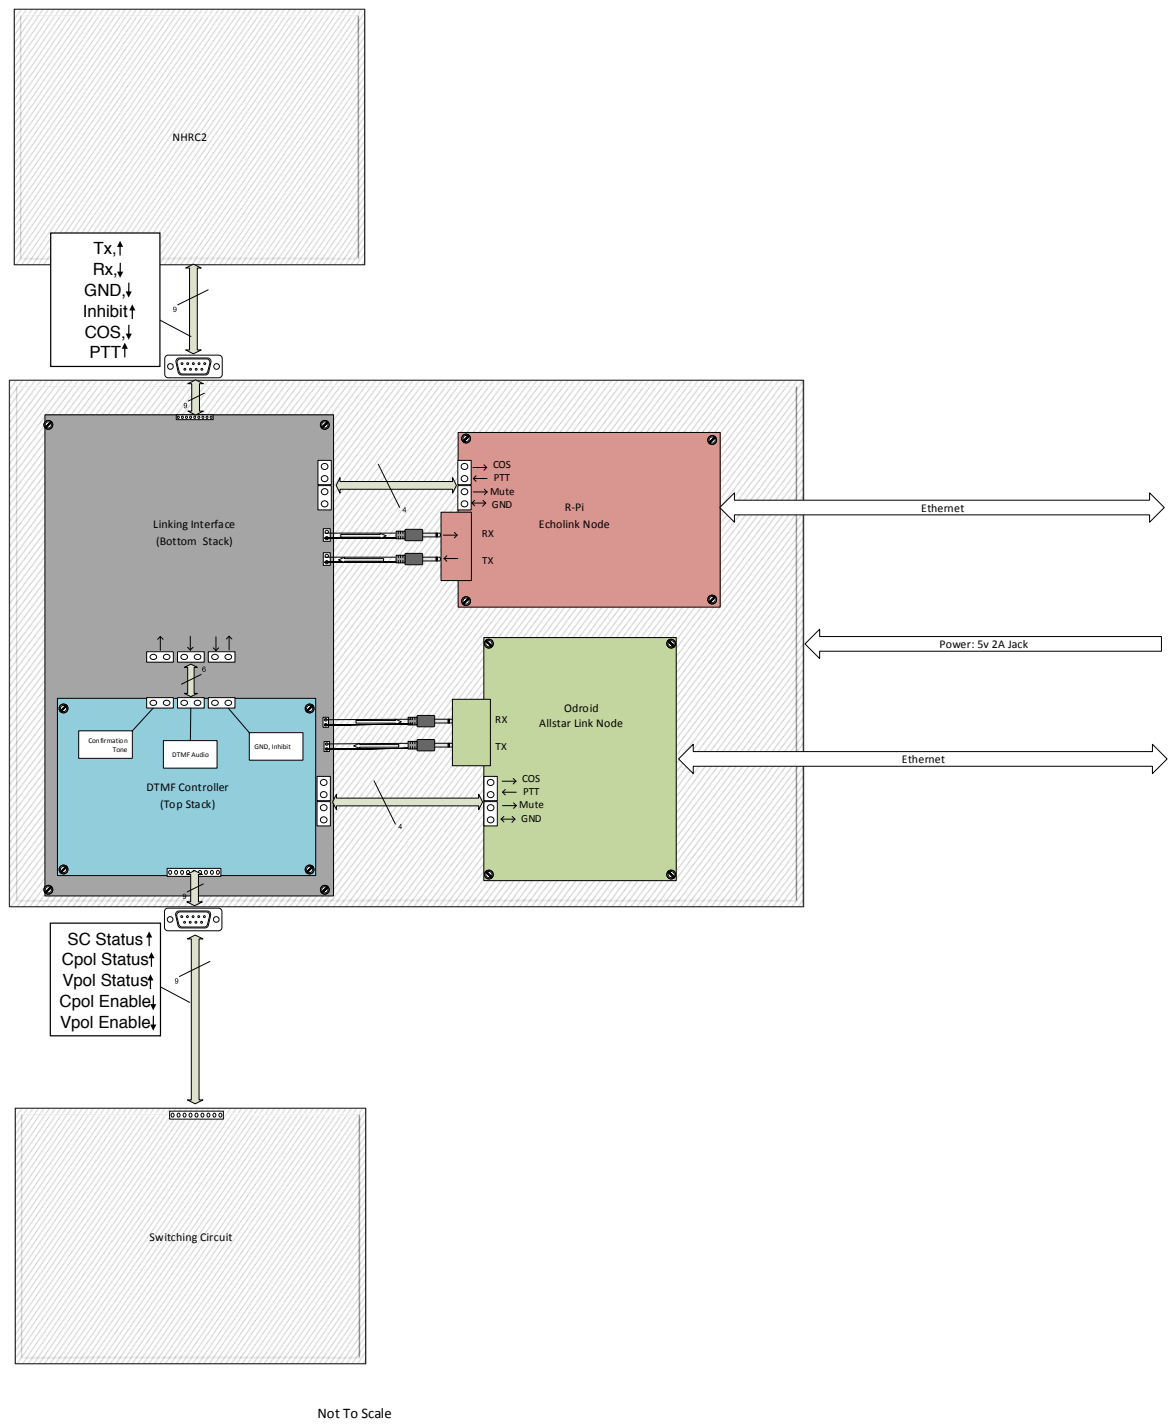
[picture p104: page 1]
DTMF Controller (Top Stack); Linking Interface (Bottom Stack); R-Pi Echolink Node; Switching Circuit; NHRC2; Power: 5v 2A Jack; Ethernet; COS PTT Mute GND; Confirmation; Tone; DTMF Audio; GND, Inhibit

Odroid
Allstar Link Node

Not To Scale
