mattcarberry/echolink_hardware/Documentation/Project/9094_revA.pdf

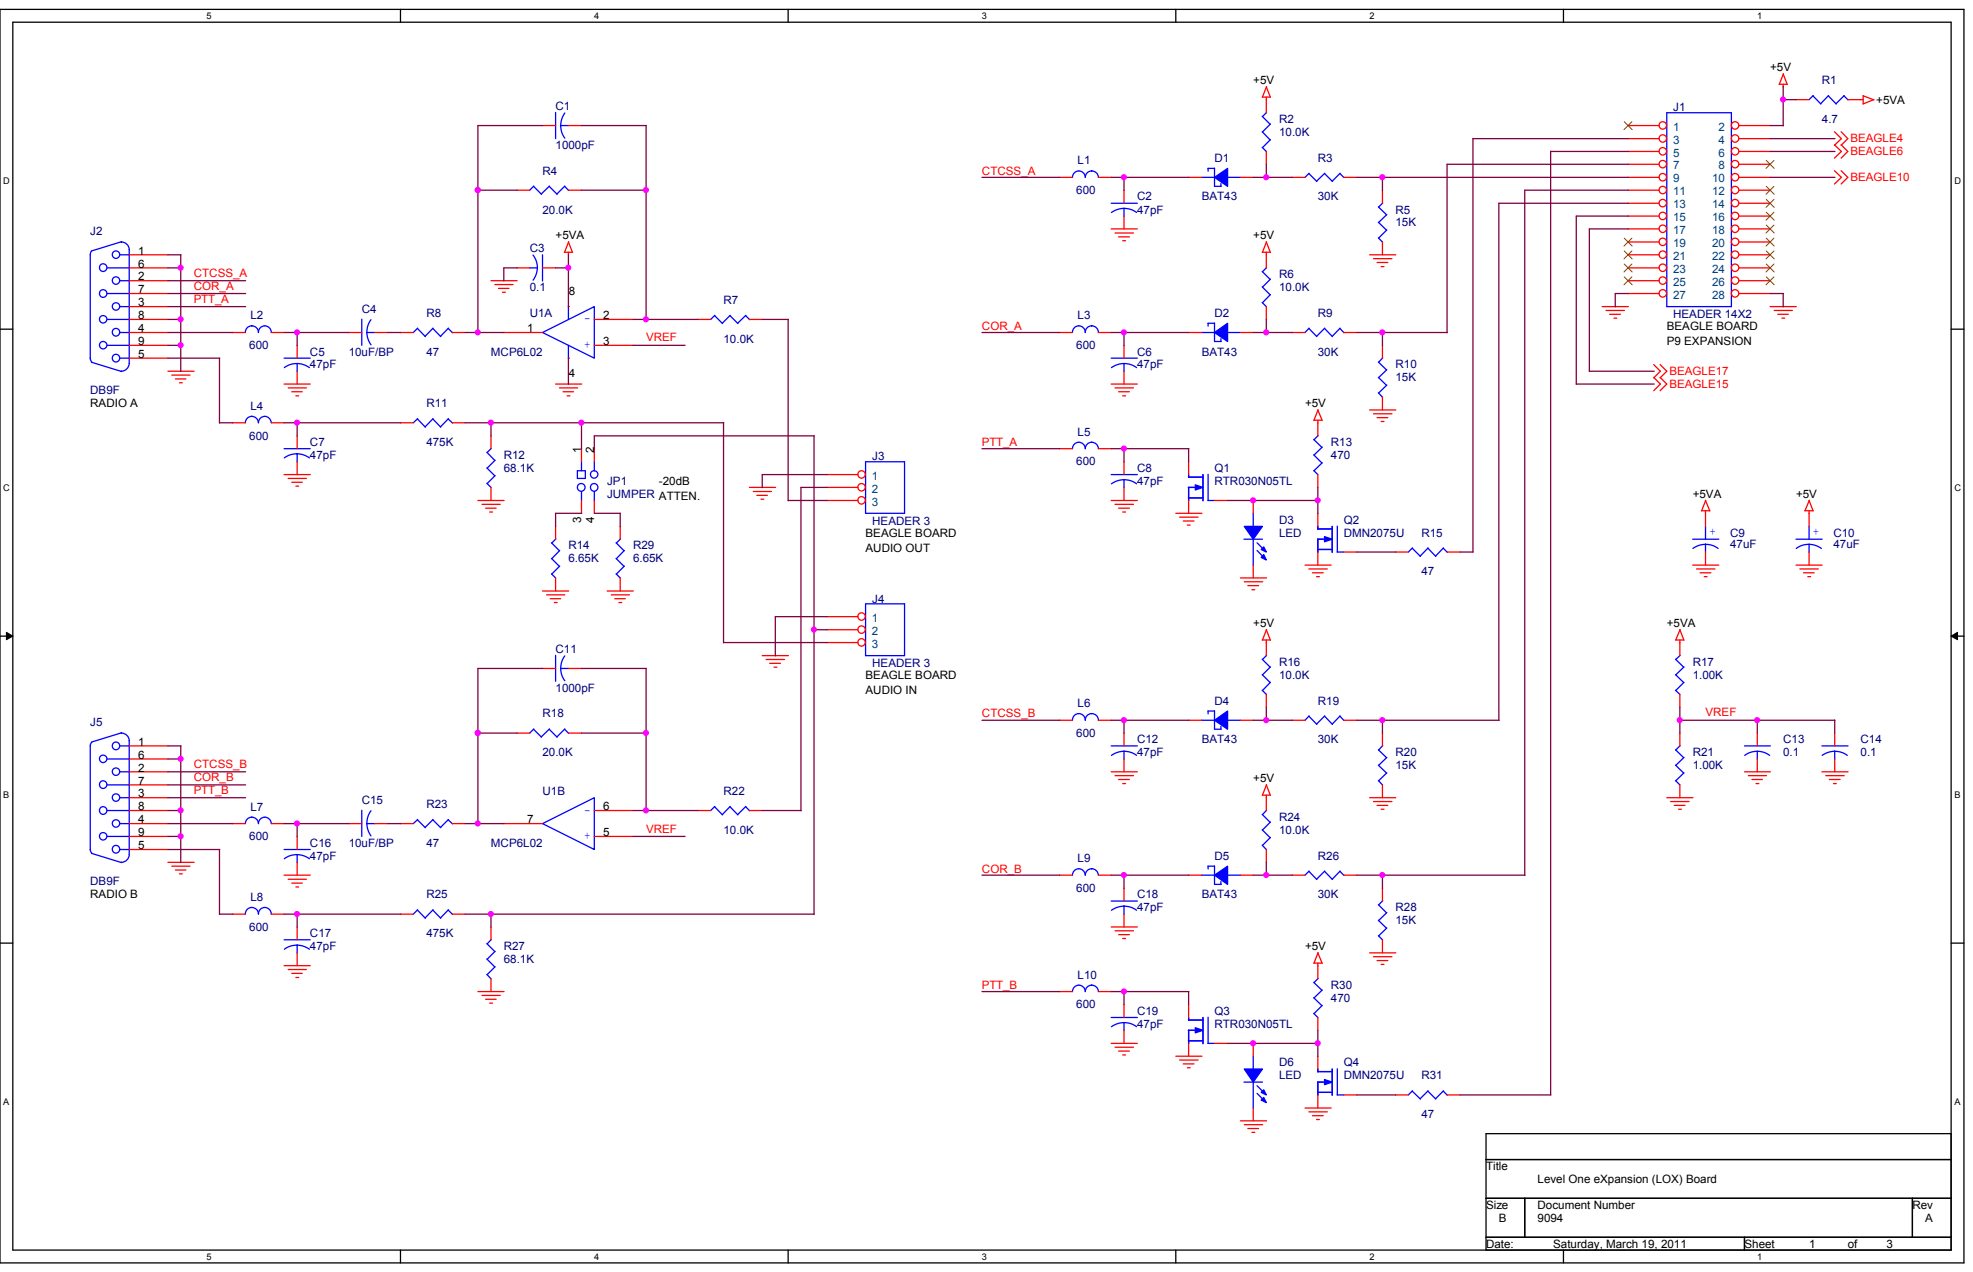
[picture p105: page 1]

Level One eXpansion (LOX) Board

Size B | Document Number | Rev A

Date: Saturday, March 19, 2011 | Sheet 1 of 3

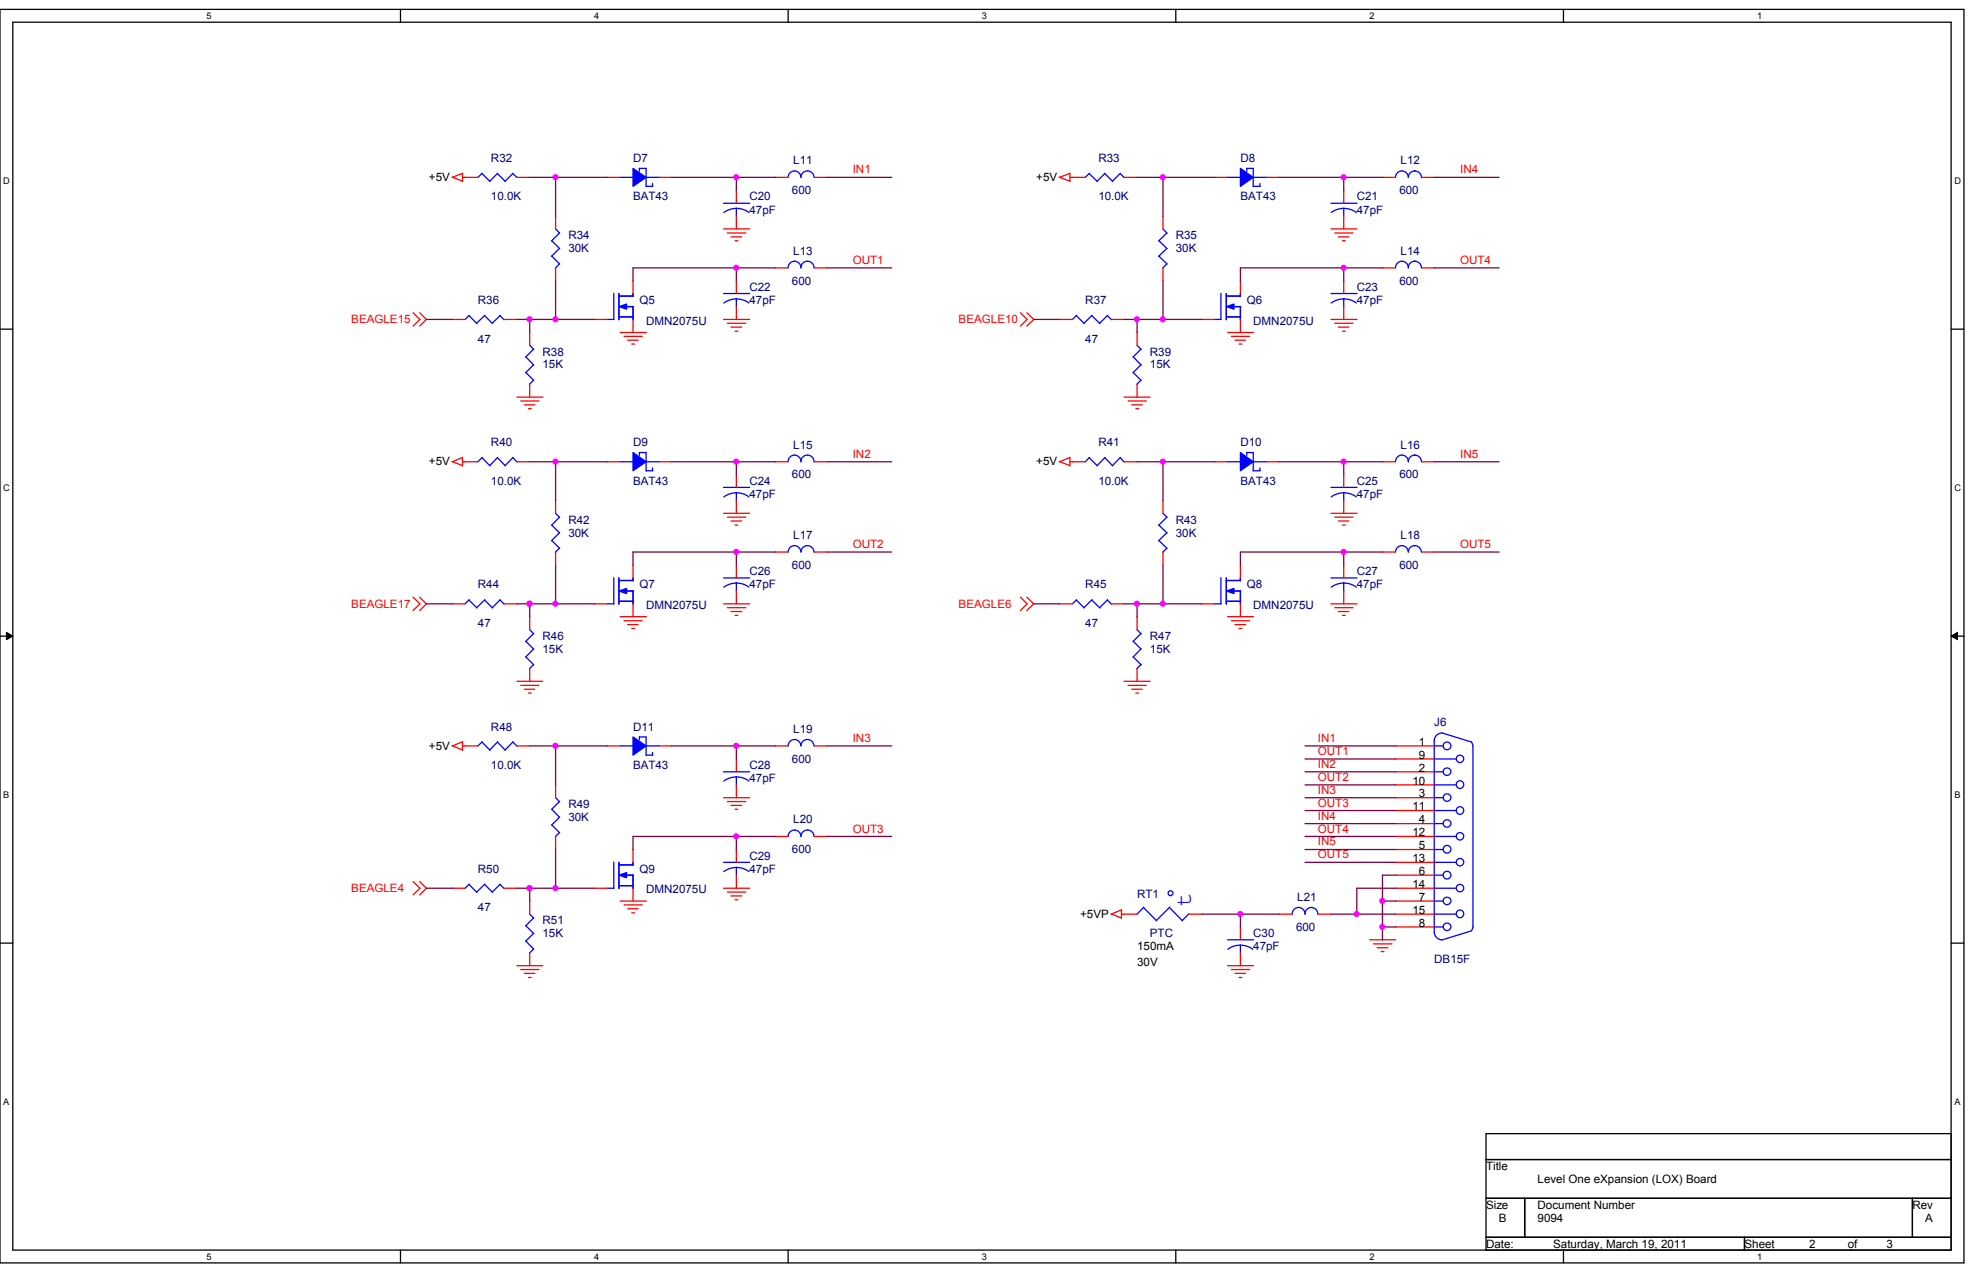
[picture p106: page 2]

Level One eXpansion (LOX) Board

Saturday, March 19, 2011 | 2 3

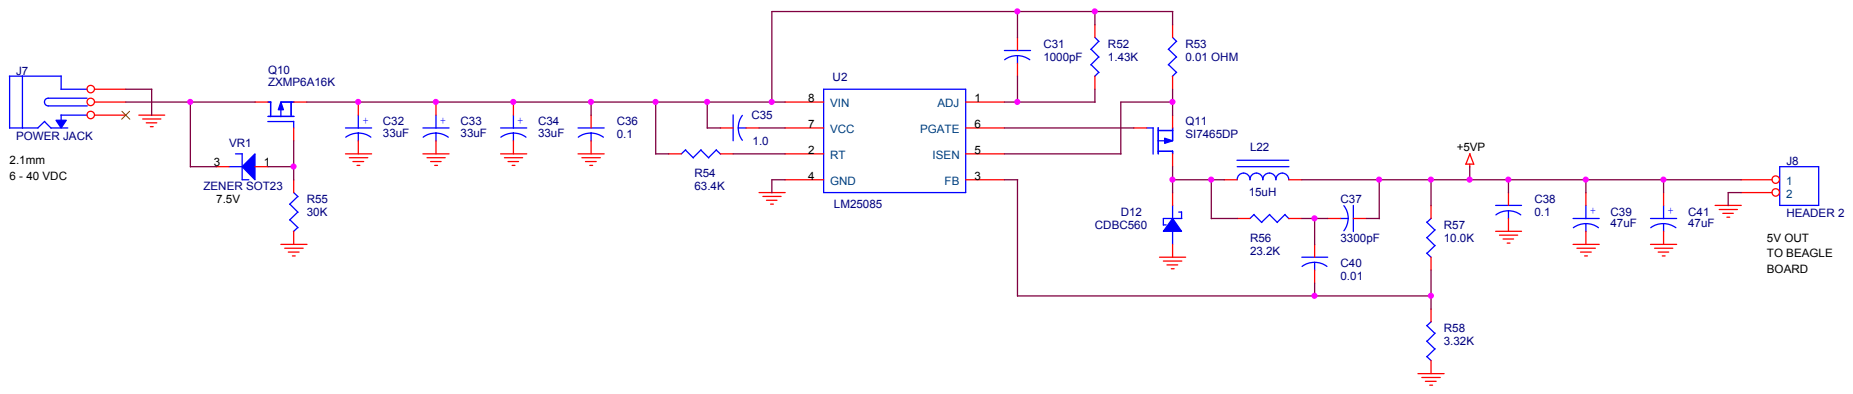
[picture p107: page 3]

Level One eXpansion (LOX) Board

Saturday, March 19, 2011 | 3 3
