mattcarberry/echolink_hardware/Documentation/Project/Interim Report/LinkingInterfaceV2.2.pdf

1 | 2 ¹⁴ 7 | + C11

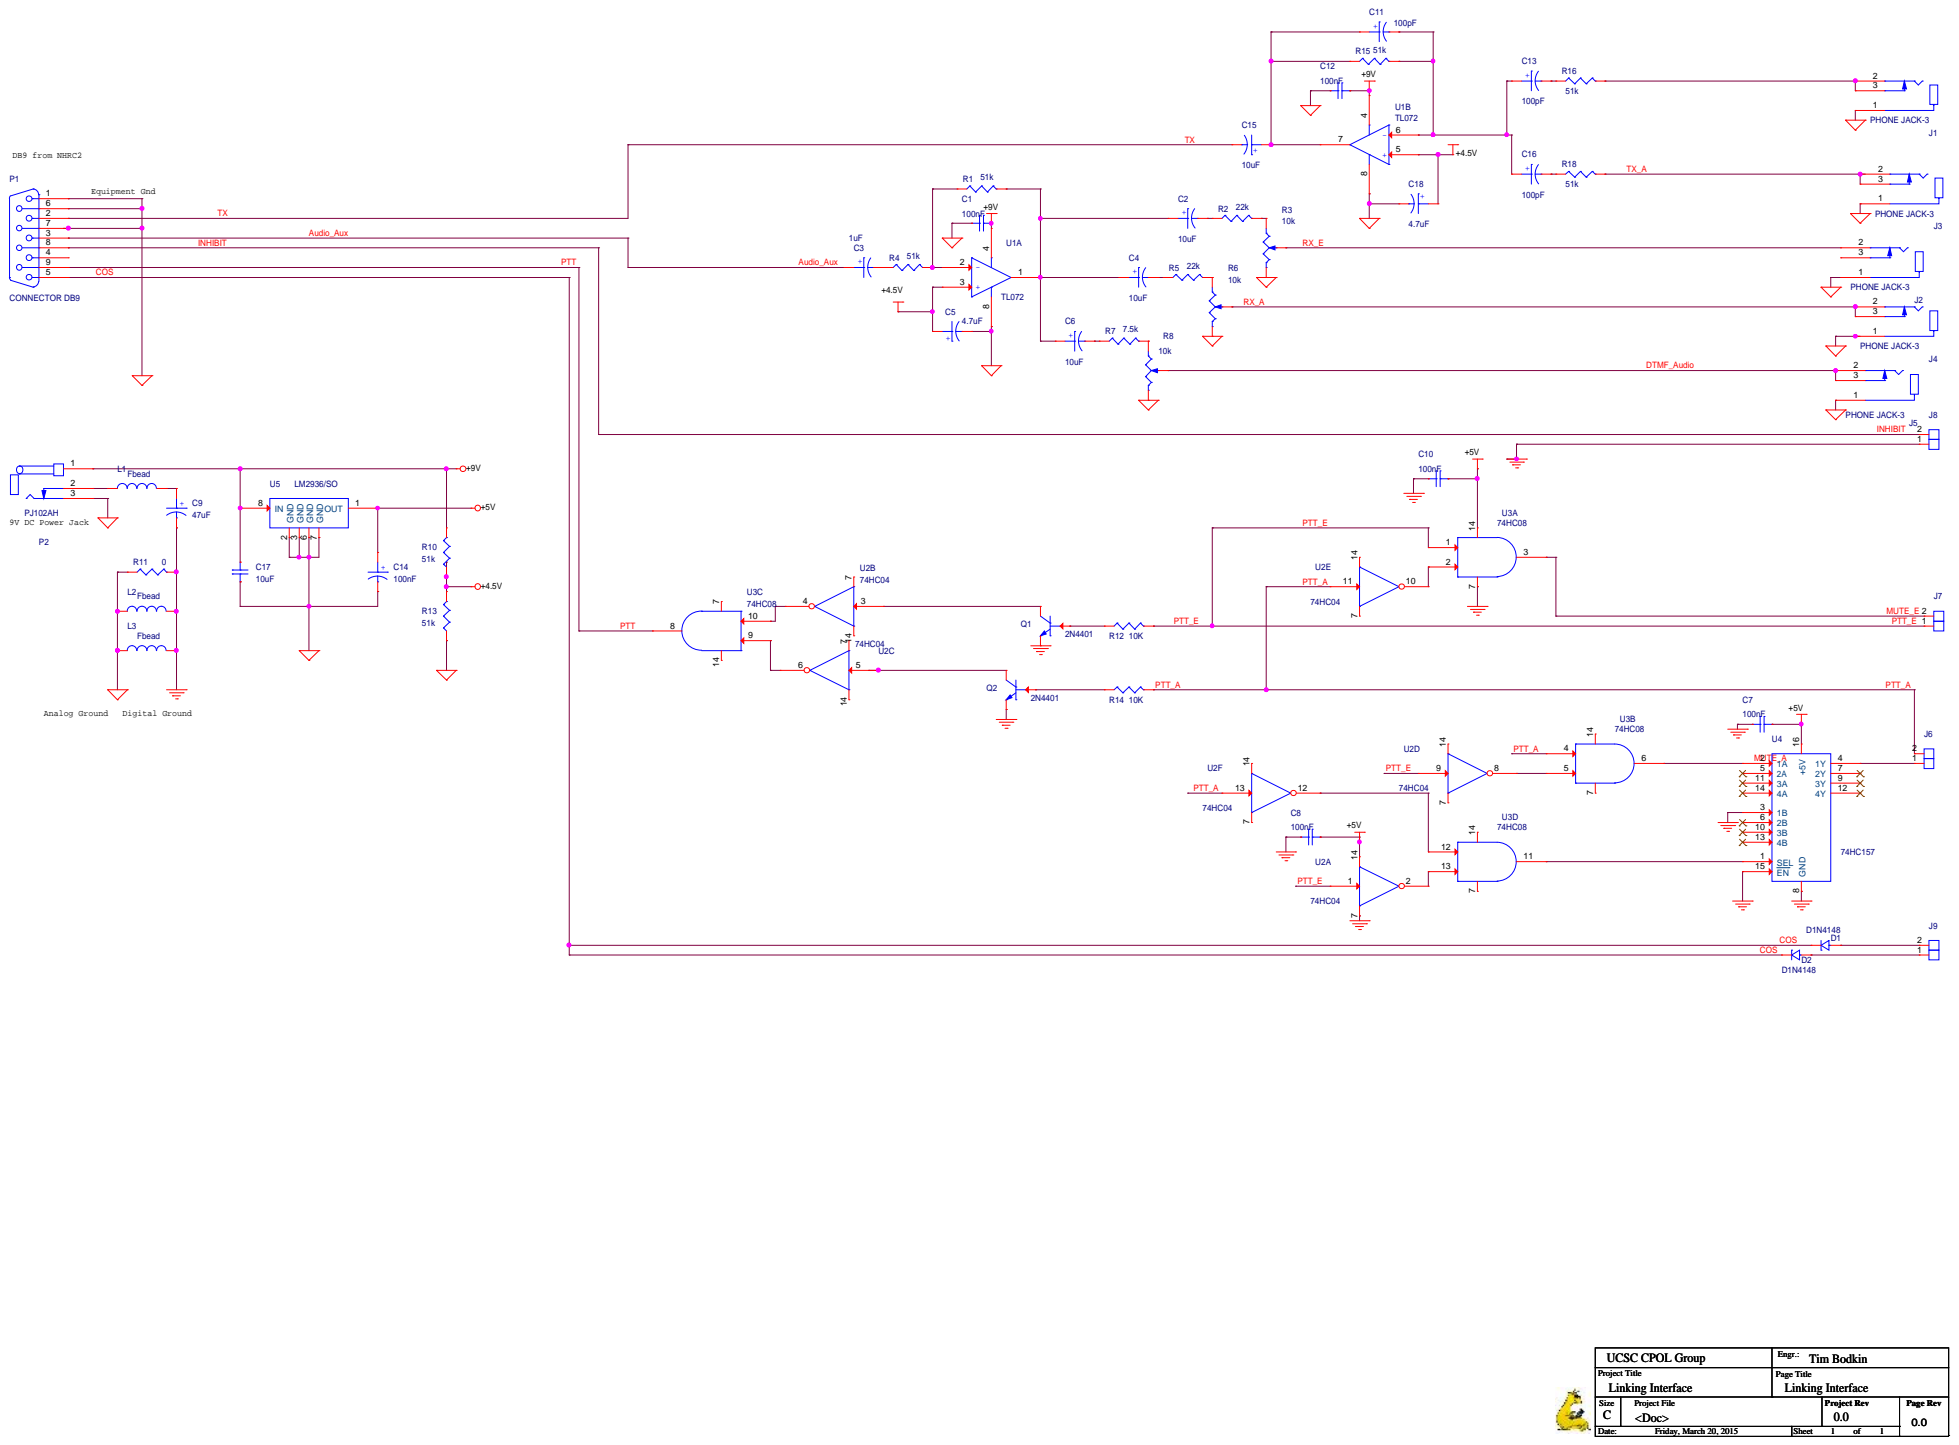
[picture p108: page 1]
