mattcarberry/echolink_hardware/CPOLAntenna/CircPolarization_II/Hardware/v1.0/Allegro.pdf

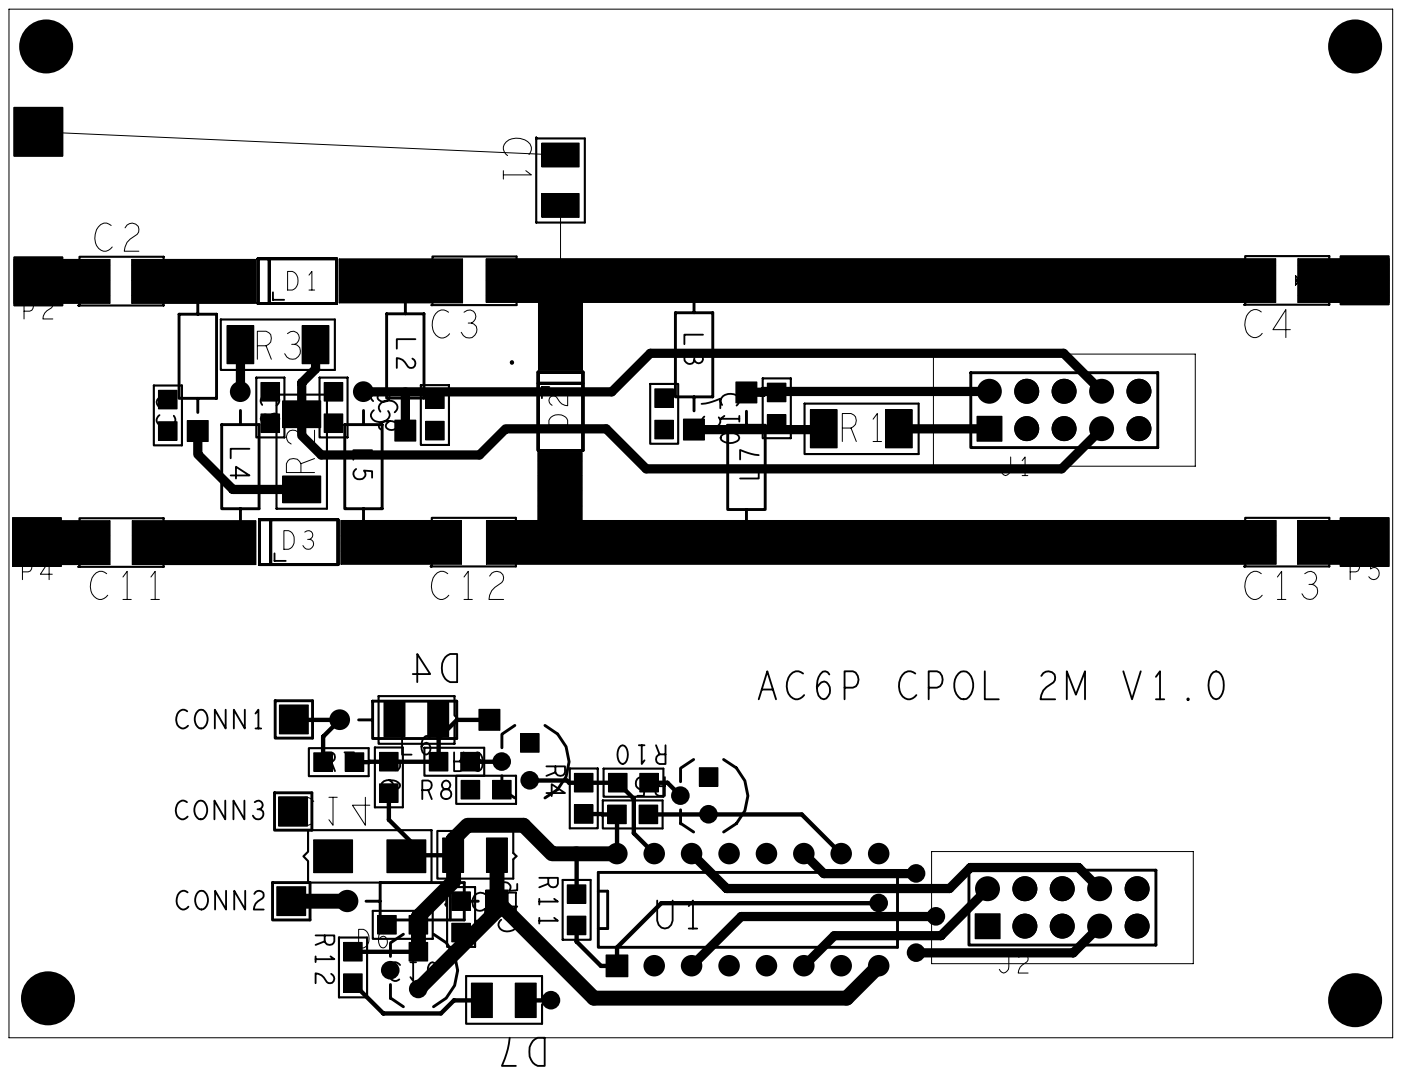
[picture p109: page 1]
