mattcarberry/echolink_hardware/Documentation/DTMF_Rev4.pdf

# DTMF Decoder

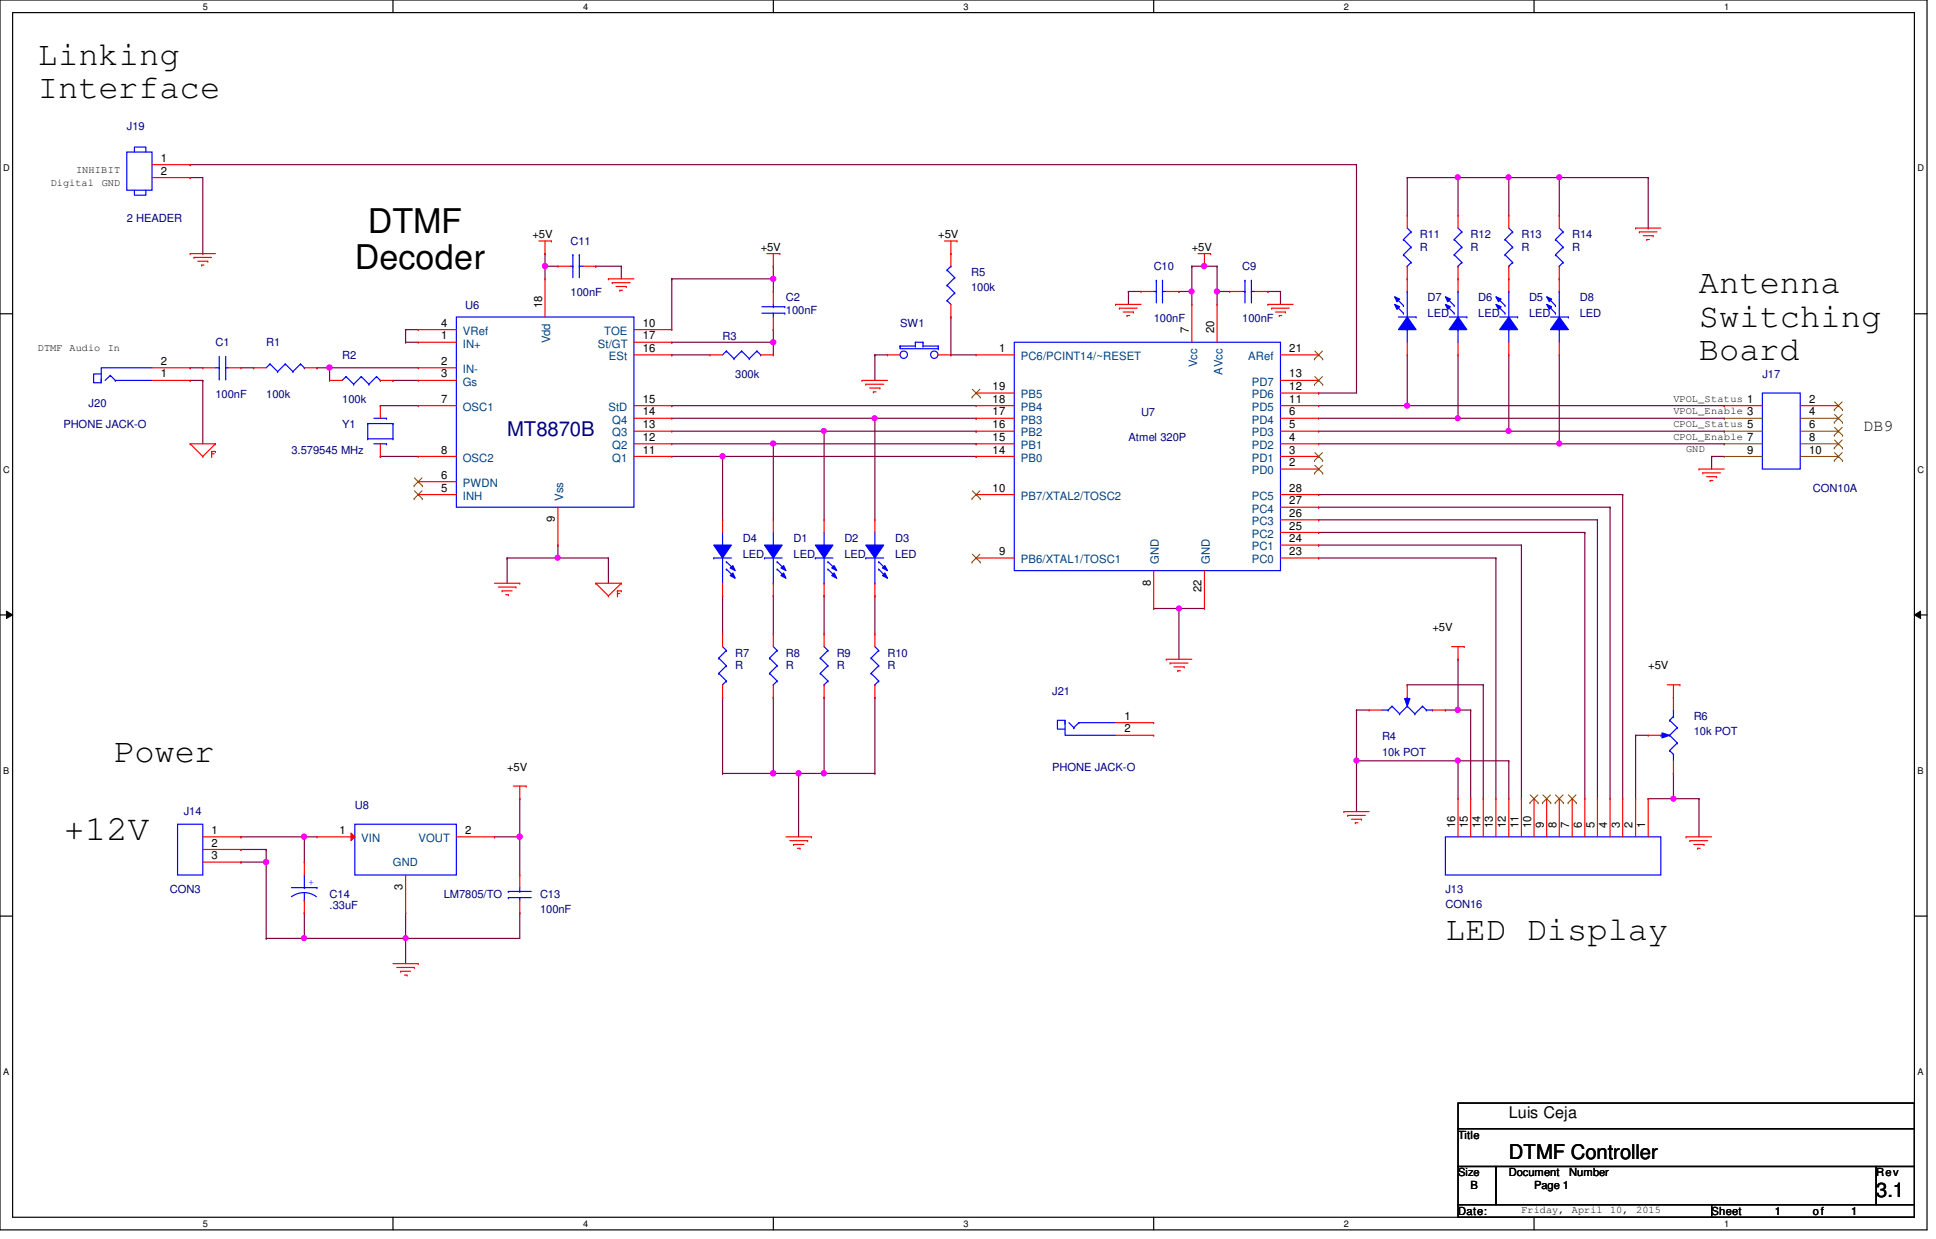
[picture p110: page 1]
