mattcarberry/echolink_hardware/Documentation/PI_Interface.pdf

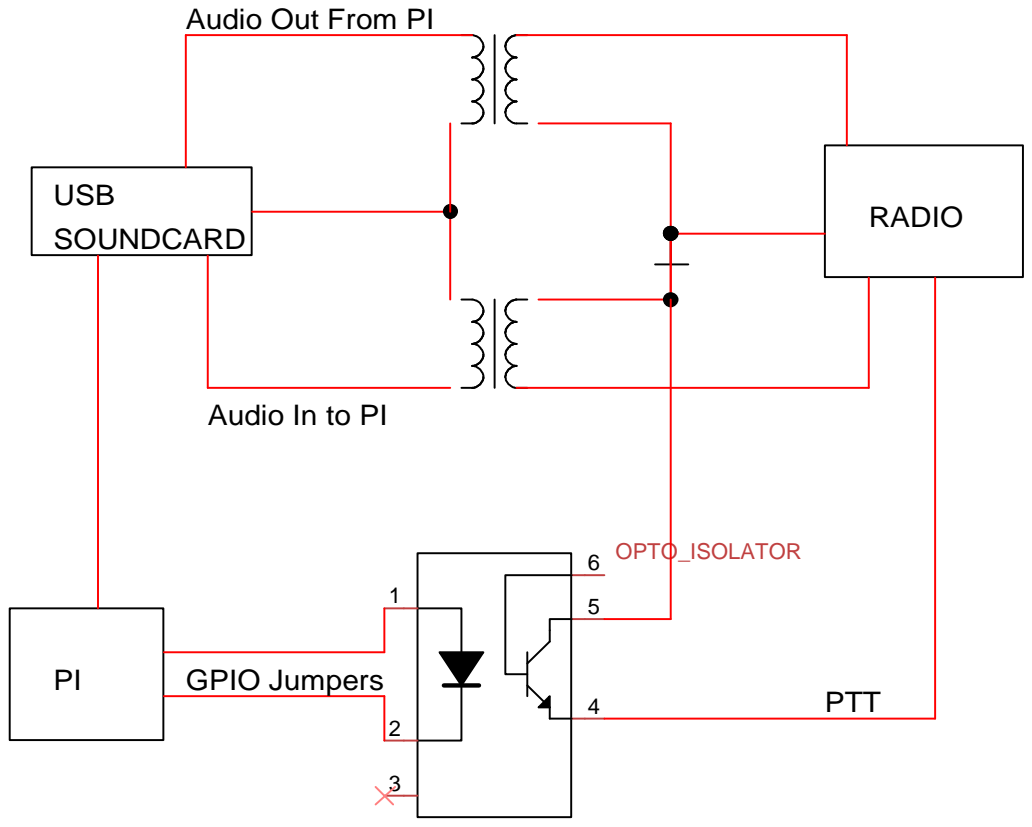
[picture p111: page 1]
RADIO; 6 OPTO_ISOLATOR; USB SOUNDCARD; GPIO Jumpers; PTT; Title; Author; GB3YL Echolink PI Interface; M0JGX

Audio Out From PI

Audio In to PI

File Z:\JAMES\HAM\GB3YL R\PI_Interface.dsn | Document

Revision 1.0 | Date | Sheets 1 of 1
