mattcarberry/echolink_hardware/Documentation/Project Documents/Logo Stuff/ControlSignalStateDiagram.pdf

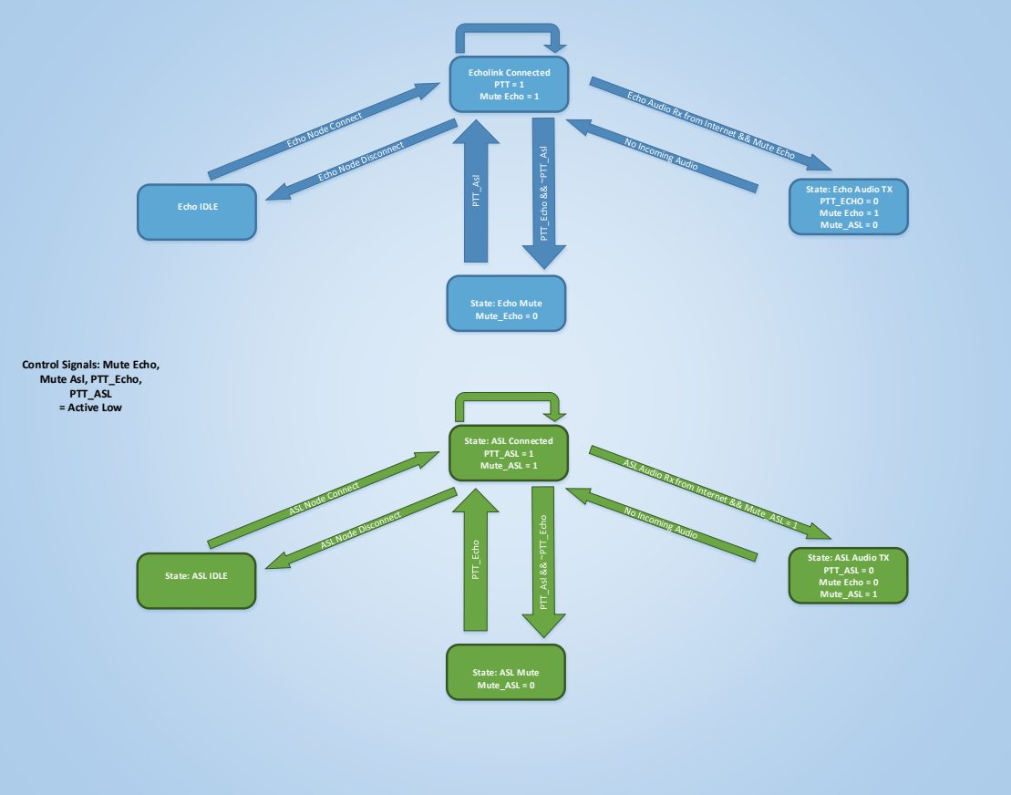
[picture p112: page 1]
Echo IDLE; Echolink Connected PTT = 1 Mute Echo = 1; State: ASL Connected PTT_ASL = 1 Mute_ASL = 1

State: Echo Audio TX
PTT_ECHO = 0
Mute Echo = 1
Mute_ASL = 0

State: Echo Mute
Mute_Echo = 0

Control Signals: Mute Echo,
Mute Asl, PTT_Echo,
PTT_ASL
= Active Low

State: ASL Audio TX
PTT_ASL = 0
Mute Echo = 0
Mute_ASL = 1

State: ASL IDLE

State: ASL Mute
