mattcarberry/echolink_hardware/LinkingInterface/v2_13/fromChris/linkinginterface/Schematics/LinkingInterfaceV2.pdf

# HEADER 10 123456789

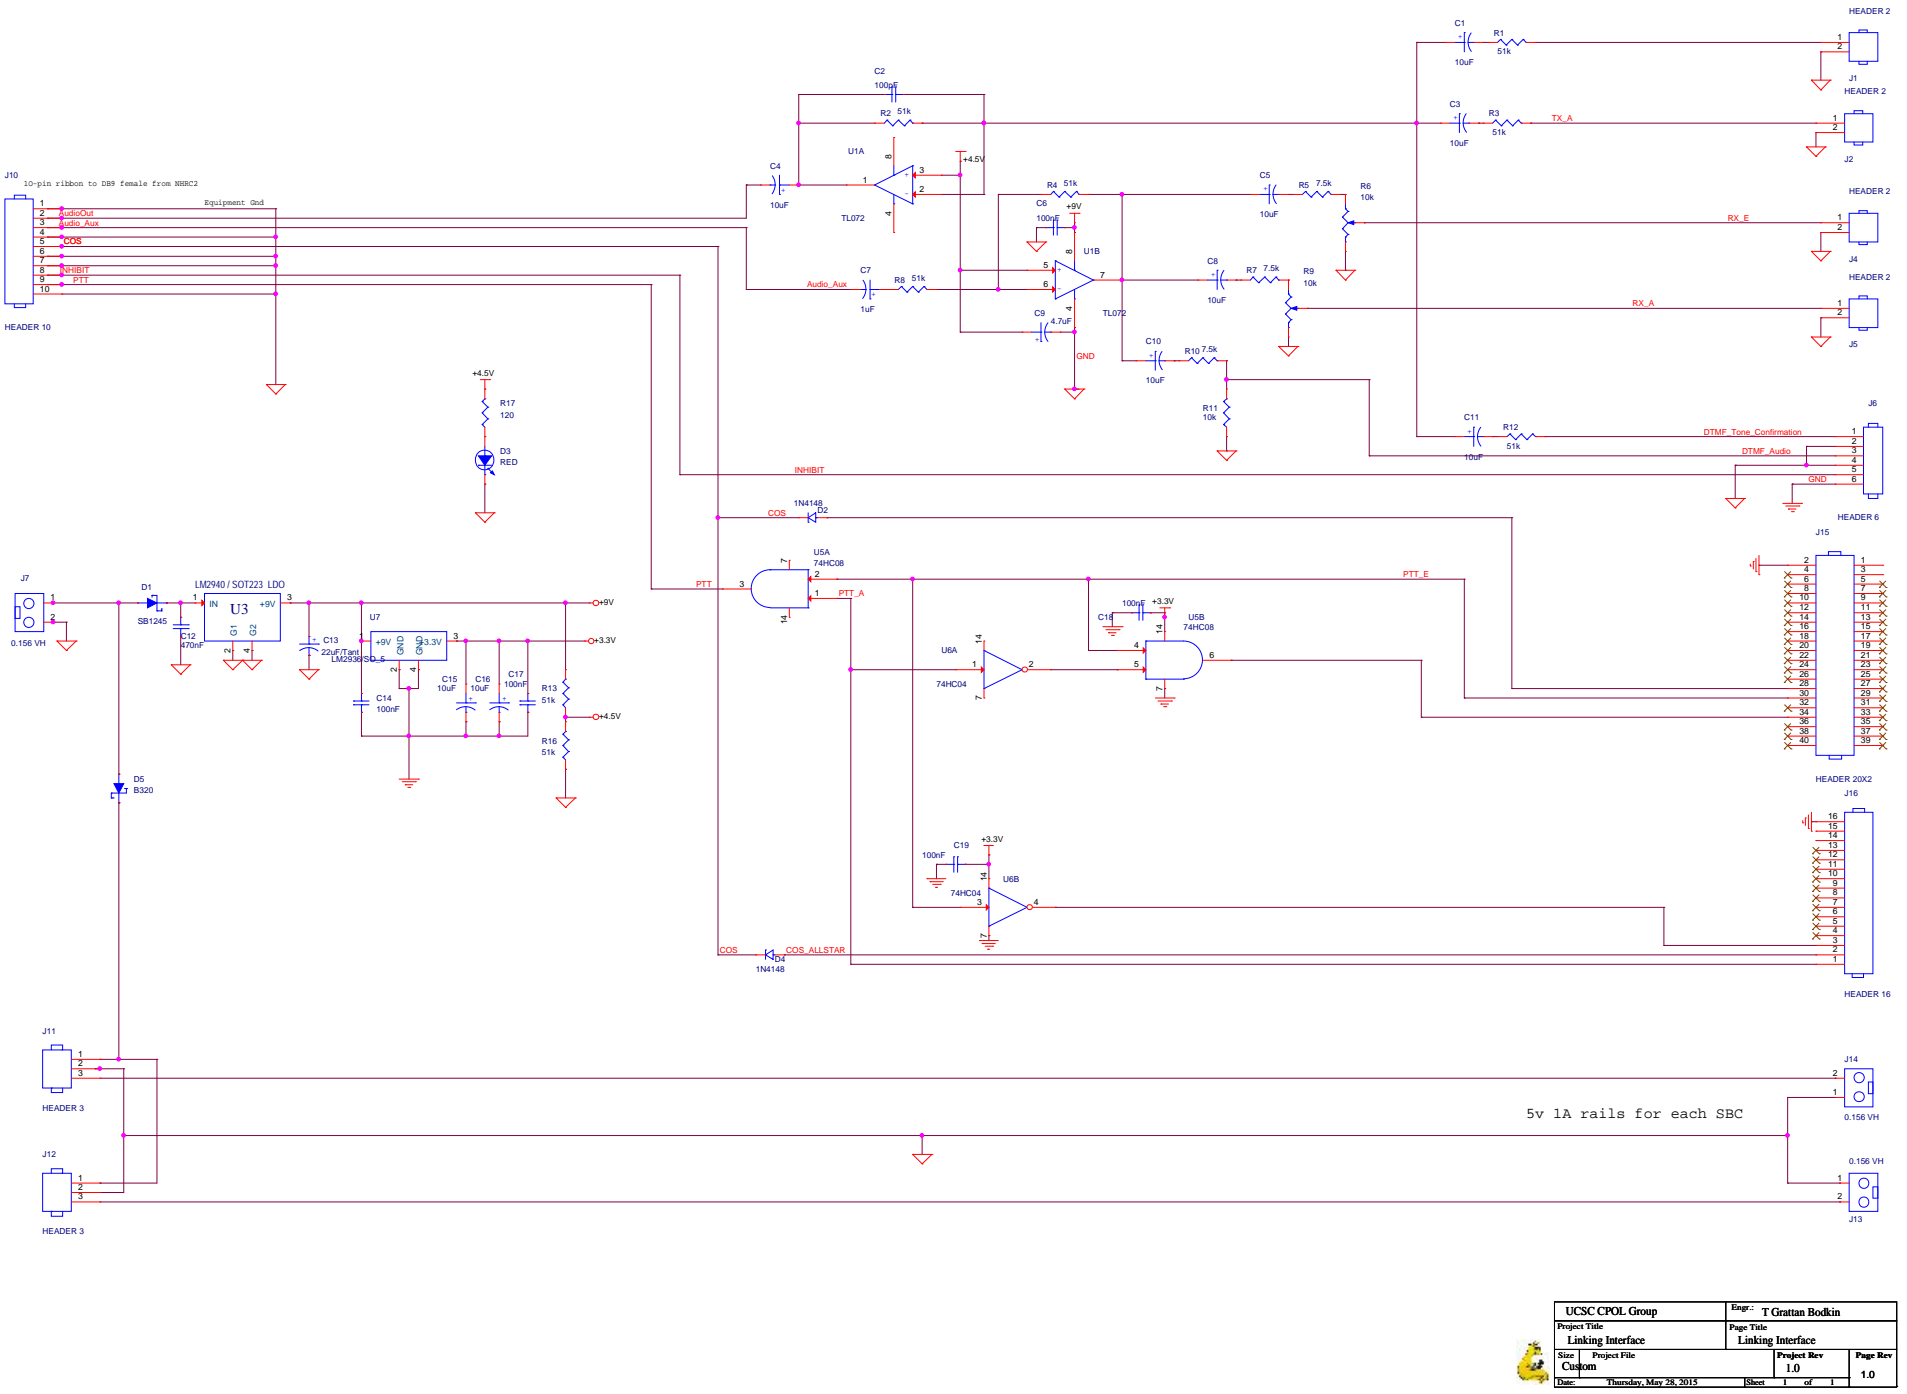
[picture p113: page 1]

1O-pin ribbon to DB9 female from NHRC2

5v 1A rails for each SBC
