mattcarberry/echolink_hardware/LinkingInterface/v2_13/fromChris/linkinginterface/Schematics/LinkingInterfaceV2_1.pdf

# HEADER 9 123456789

# 74HC043 4 ¹⁴ 7 -+ U1A

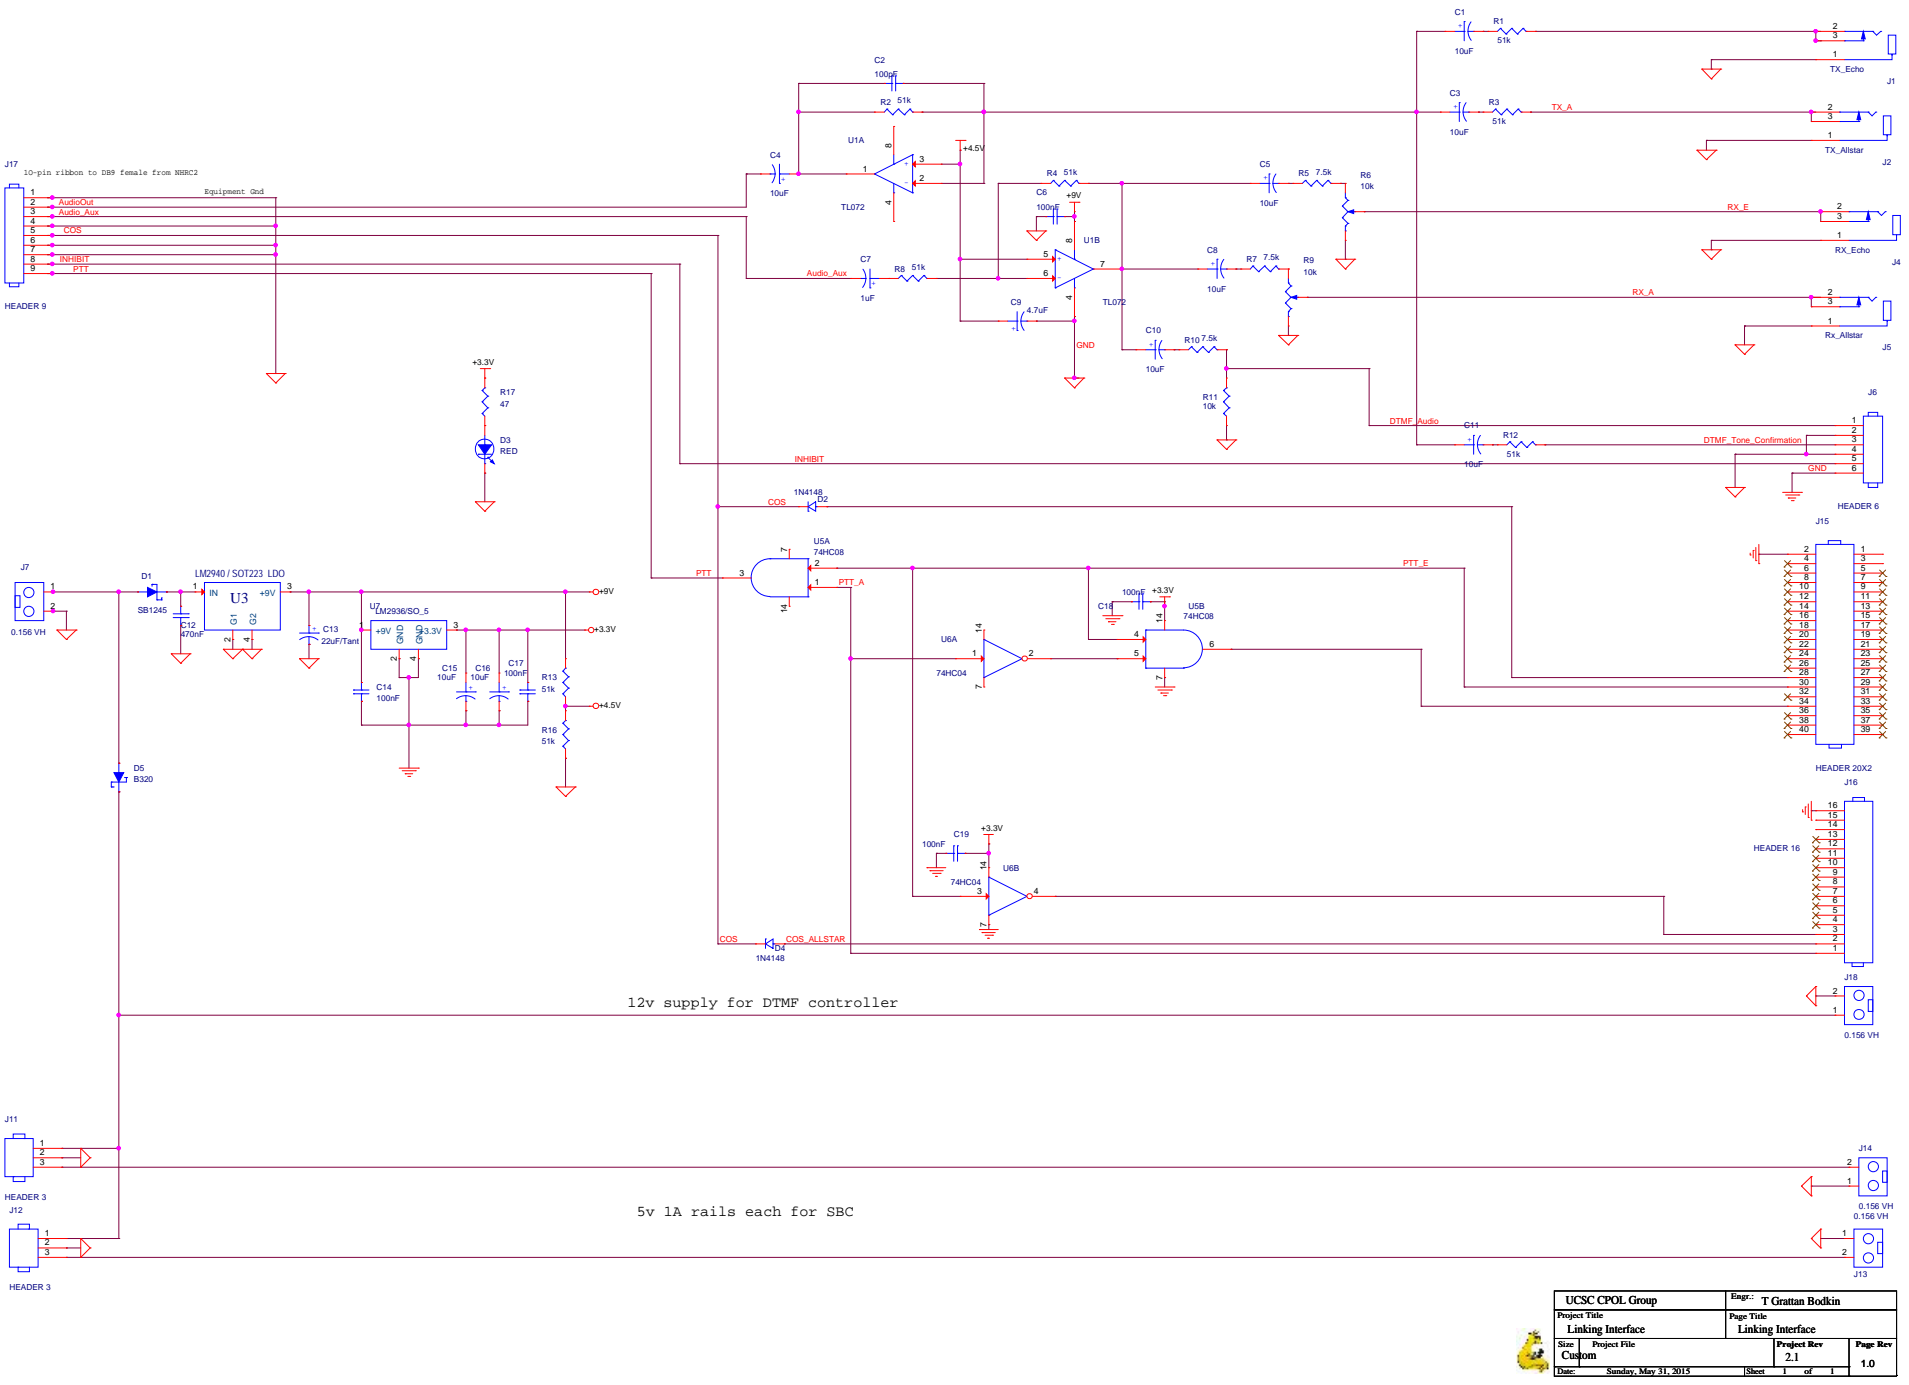
[picture p114: page 1]

1O-pin ribbon to DB9 female from NHRC2

12v supply for DTMF controller

5v 1A rails each for SBC
