mattcarberry/echolink_hardware/LinkingInterface/v2_13/fromChris/linkinginterface/Schematics/LinkingInterfaceV2_13.pdf

# Equipment Gnd 1O-pin ribbon to DB9 female from NHRC2

# 10 Pin Header to DTMF Ctrl 123456789 ⁻⁺ U1A

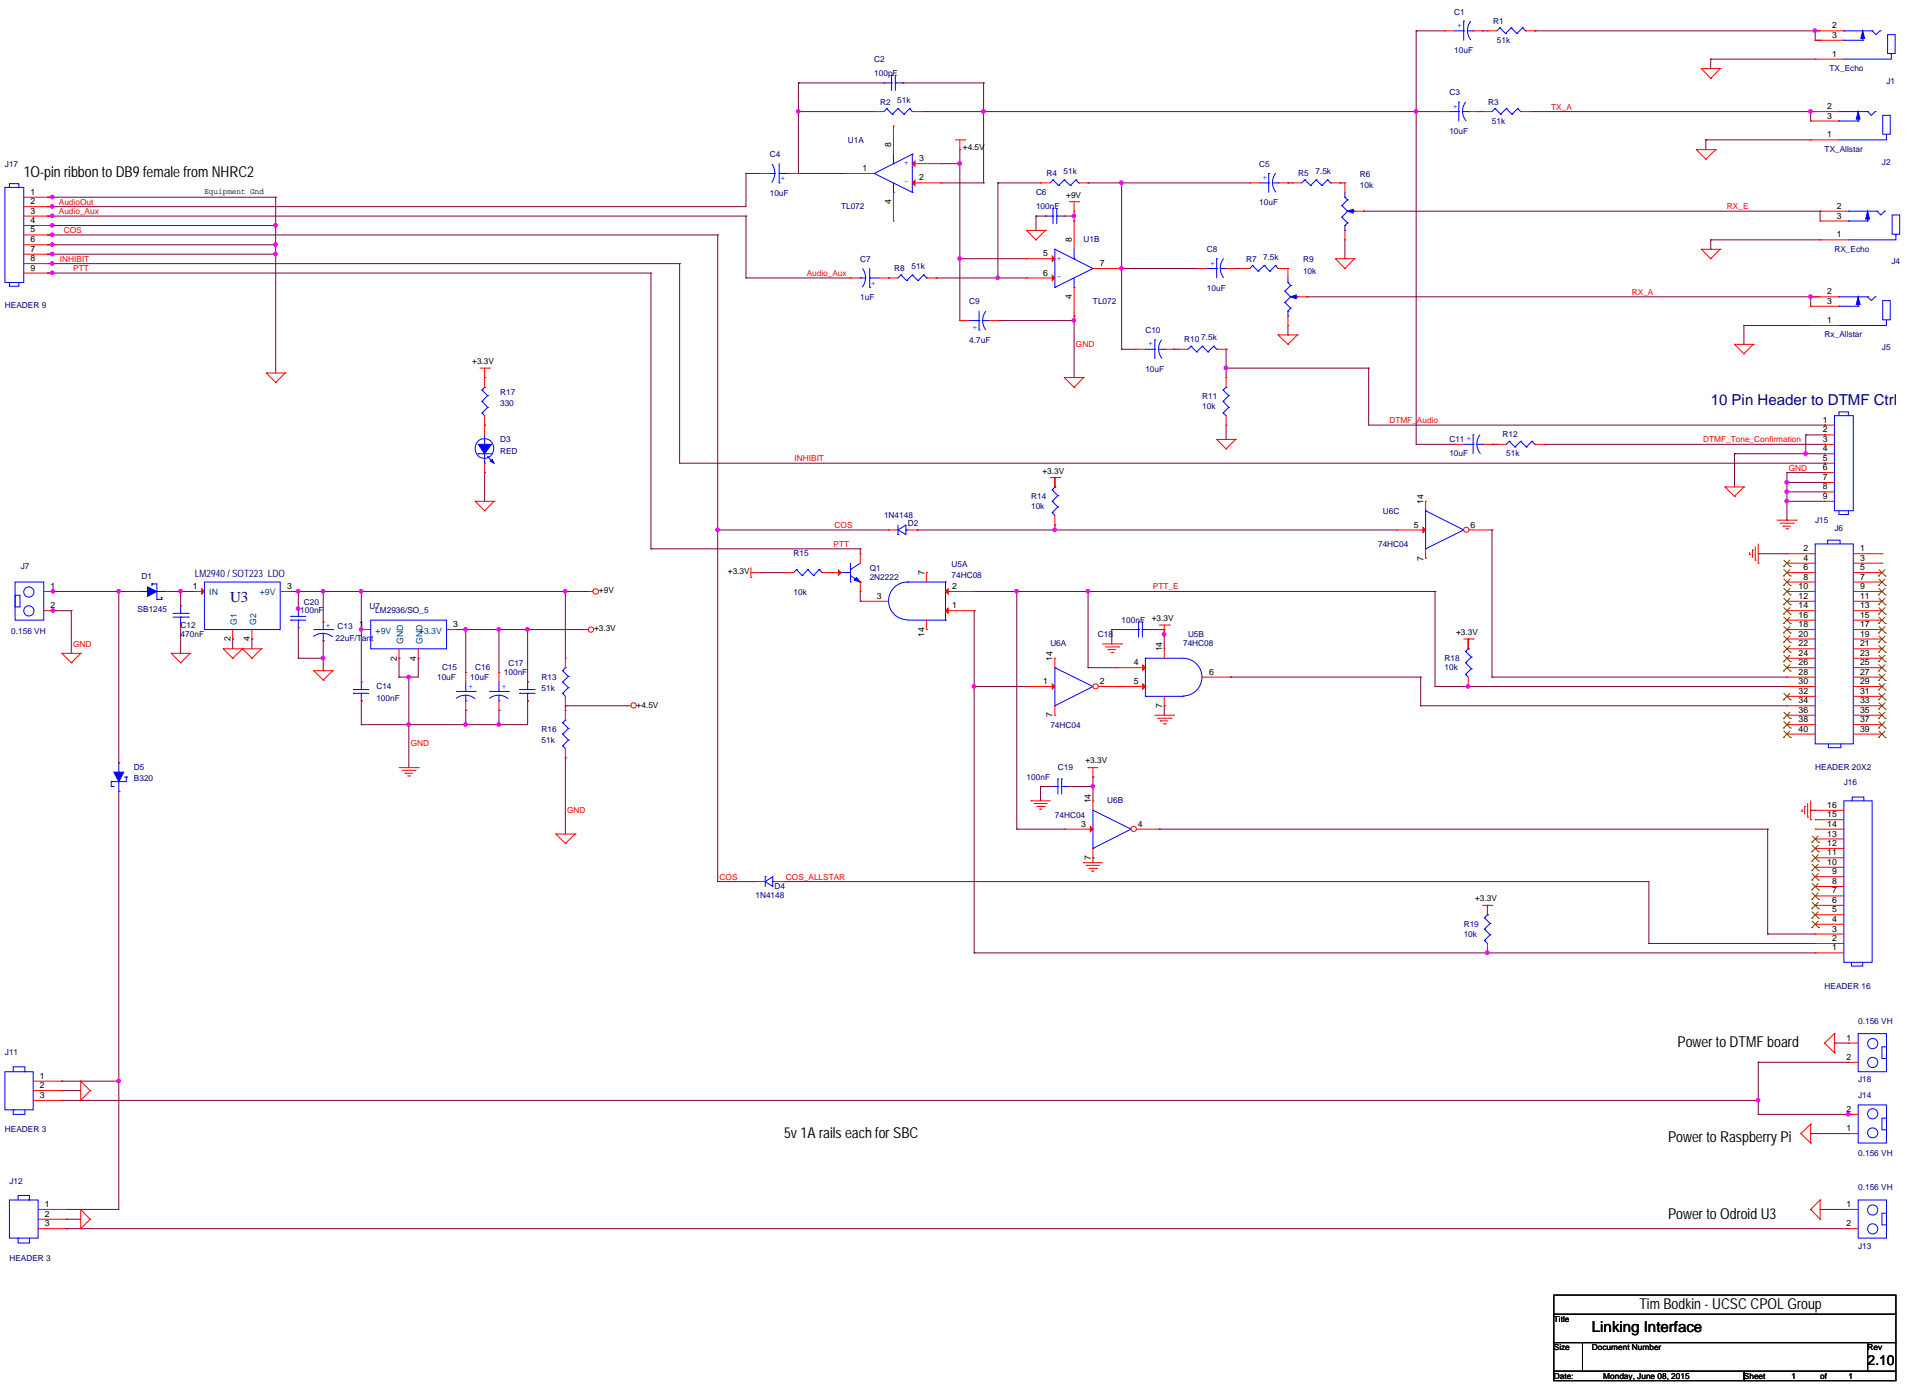
[picture p115: page 1]

Power to DTMF board

5v 1A rails each for SBC

Power to Raspberry Pi

Tim Bodkin - UCSC CPOL Group
