mattcarberry/echolink_hardware/LinkingInterface/v2_13/fromChris/linkinginterface/Schematics/LinkingInterfaceV2_2.pdf

# HEADER 9 123456789

# 0.156 VH 12 ⁺ C1

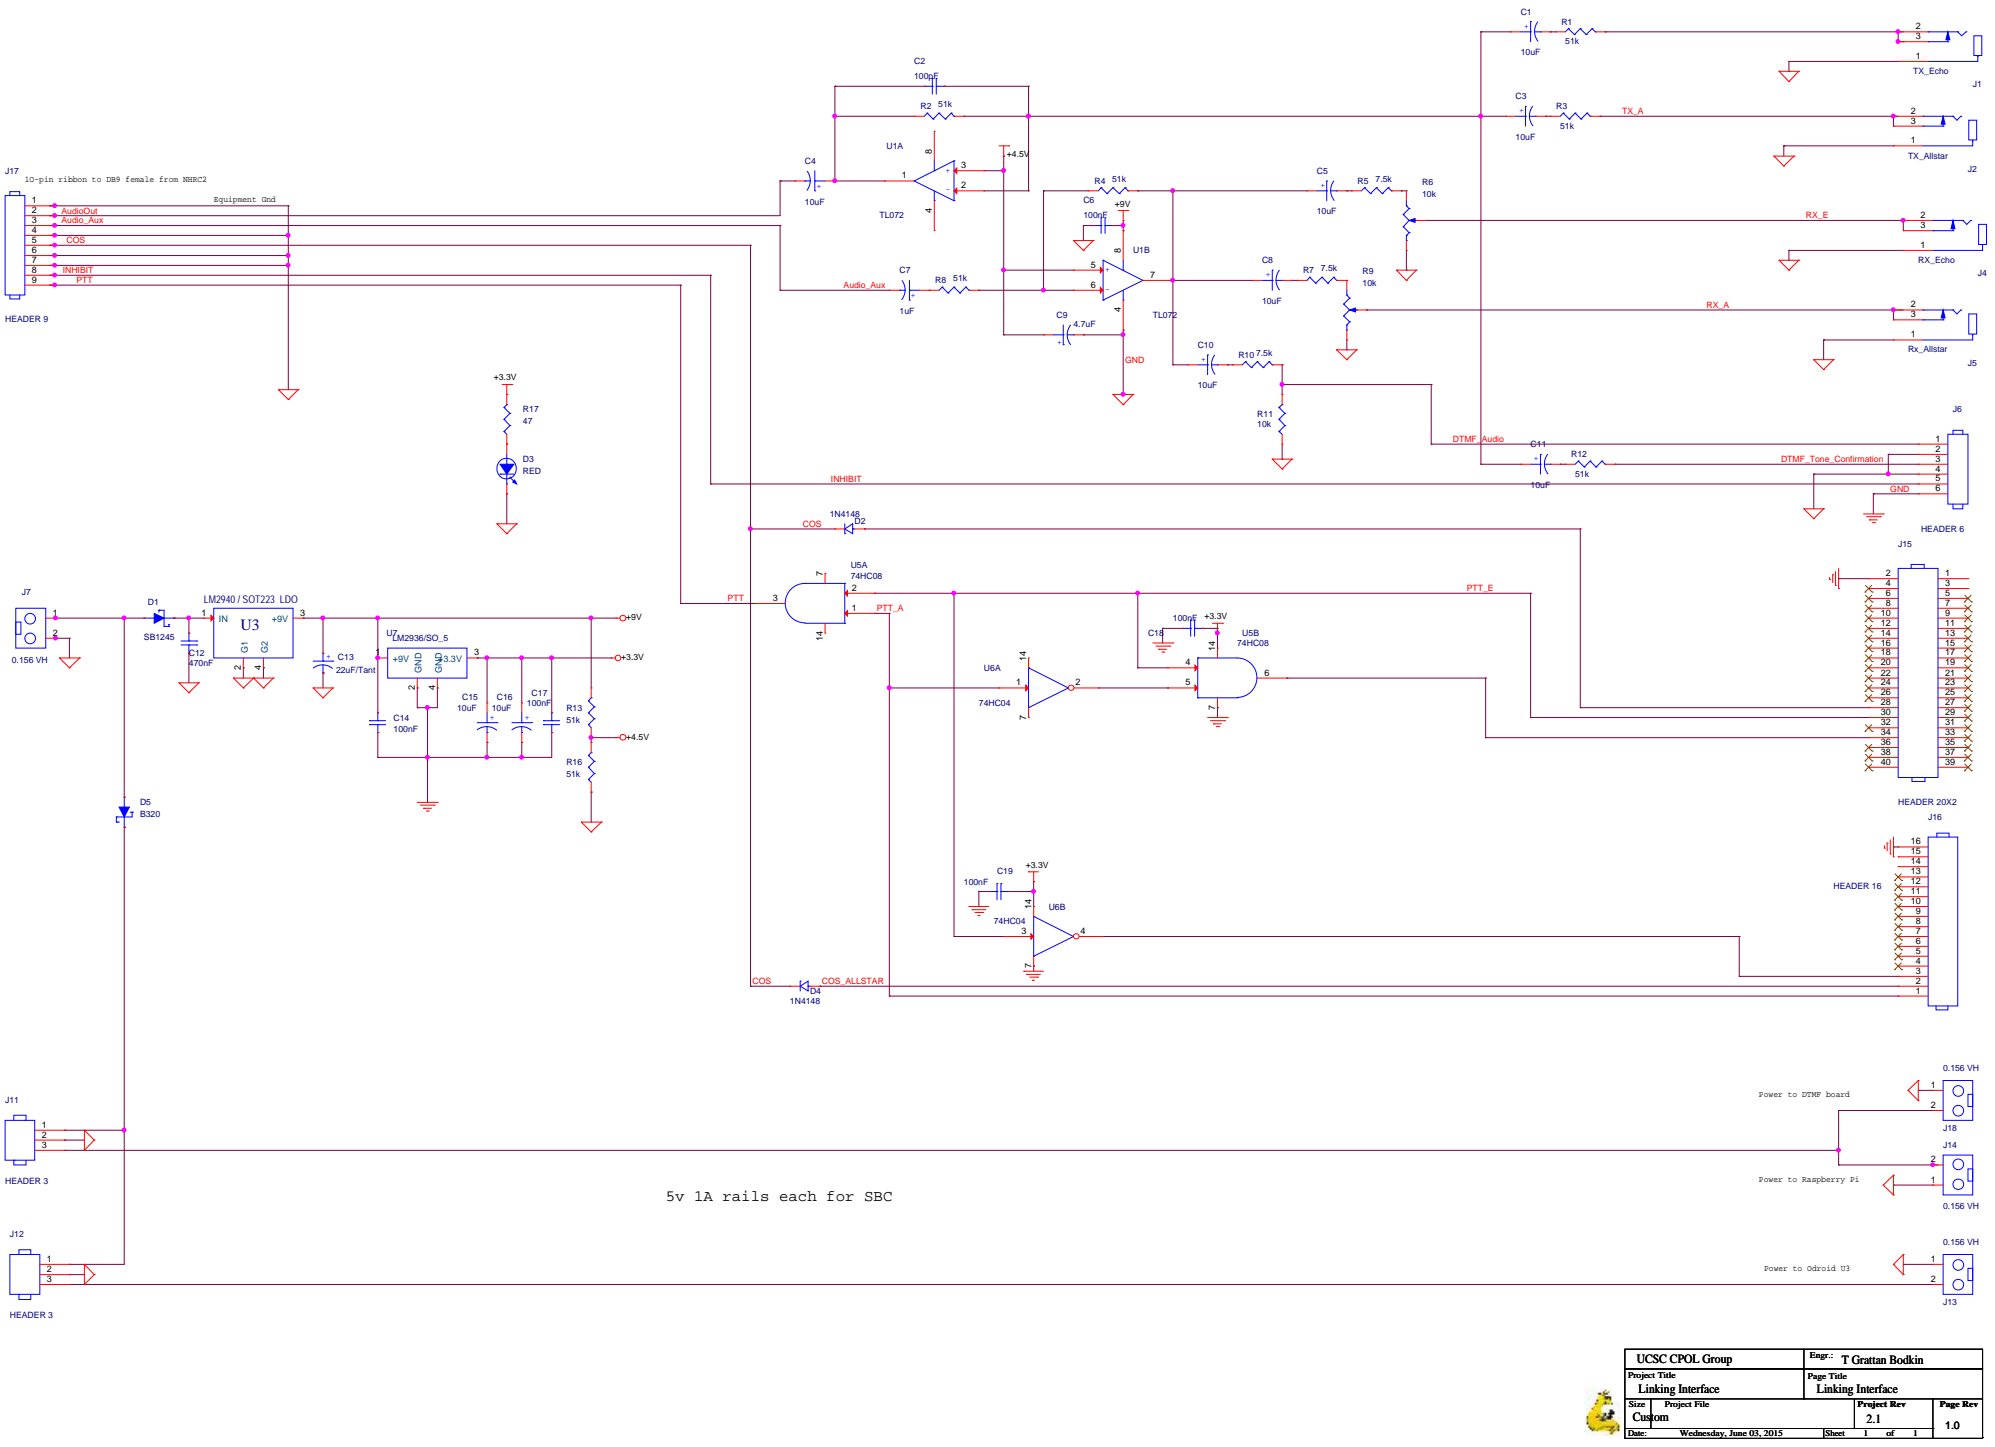
[picture p116: page 1]

1O-pin ribbon to DB9 female from NHRC2

Power to DTMF board

5v 1A rails each for SBC

Power to Raspberry Pi
