mattcarberry/echolink_hardware/Documentation/Project/Interim Report/LinkingInterfaceV2.pdf

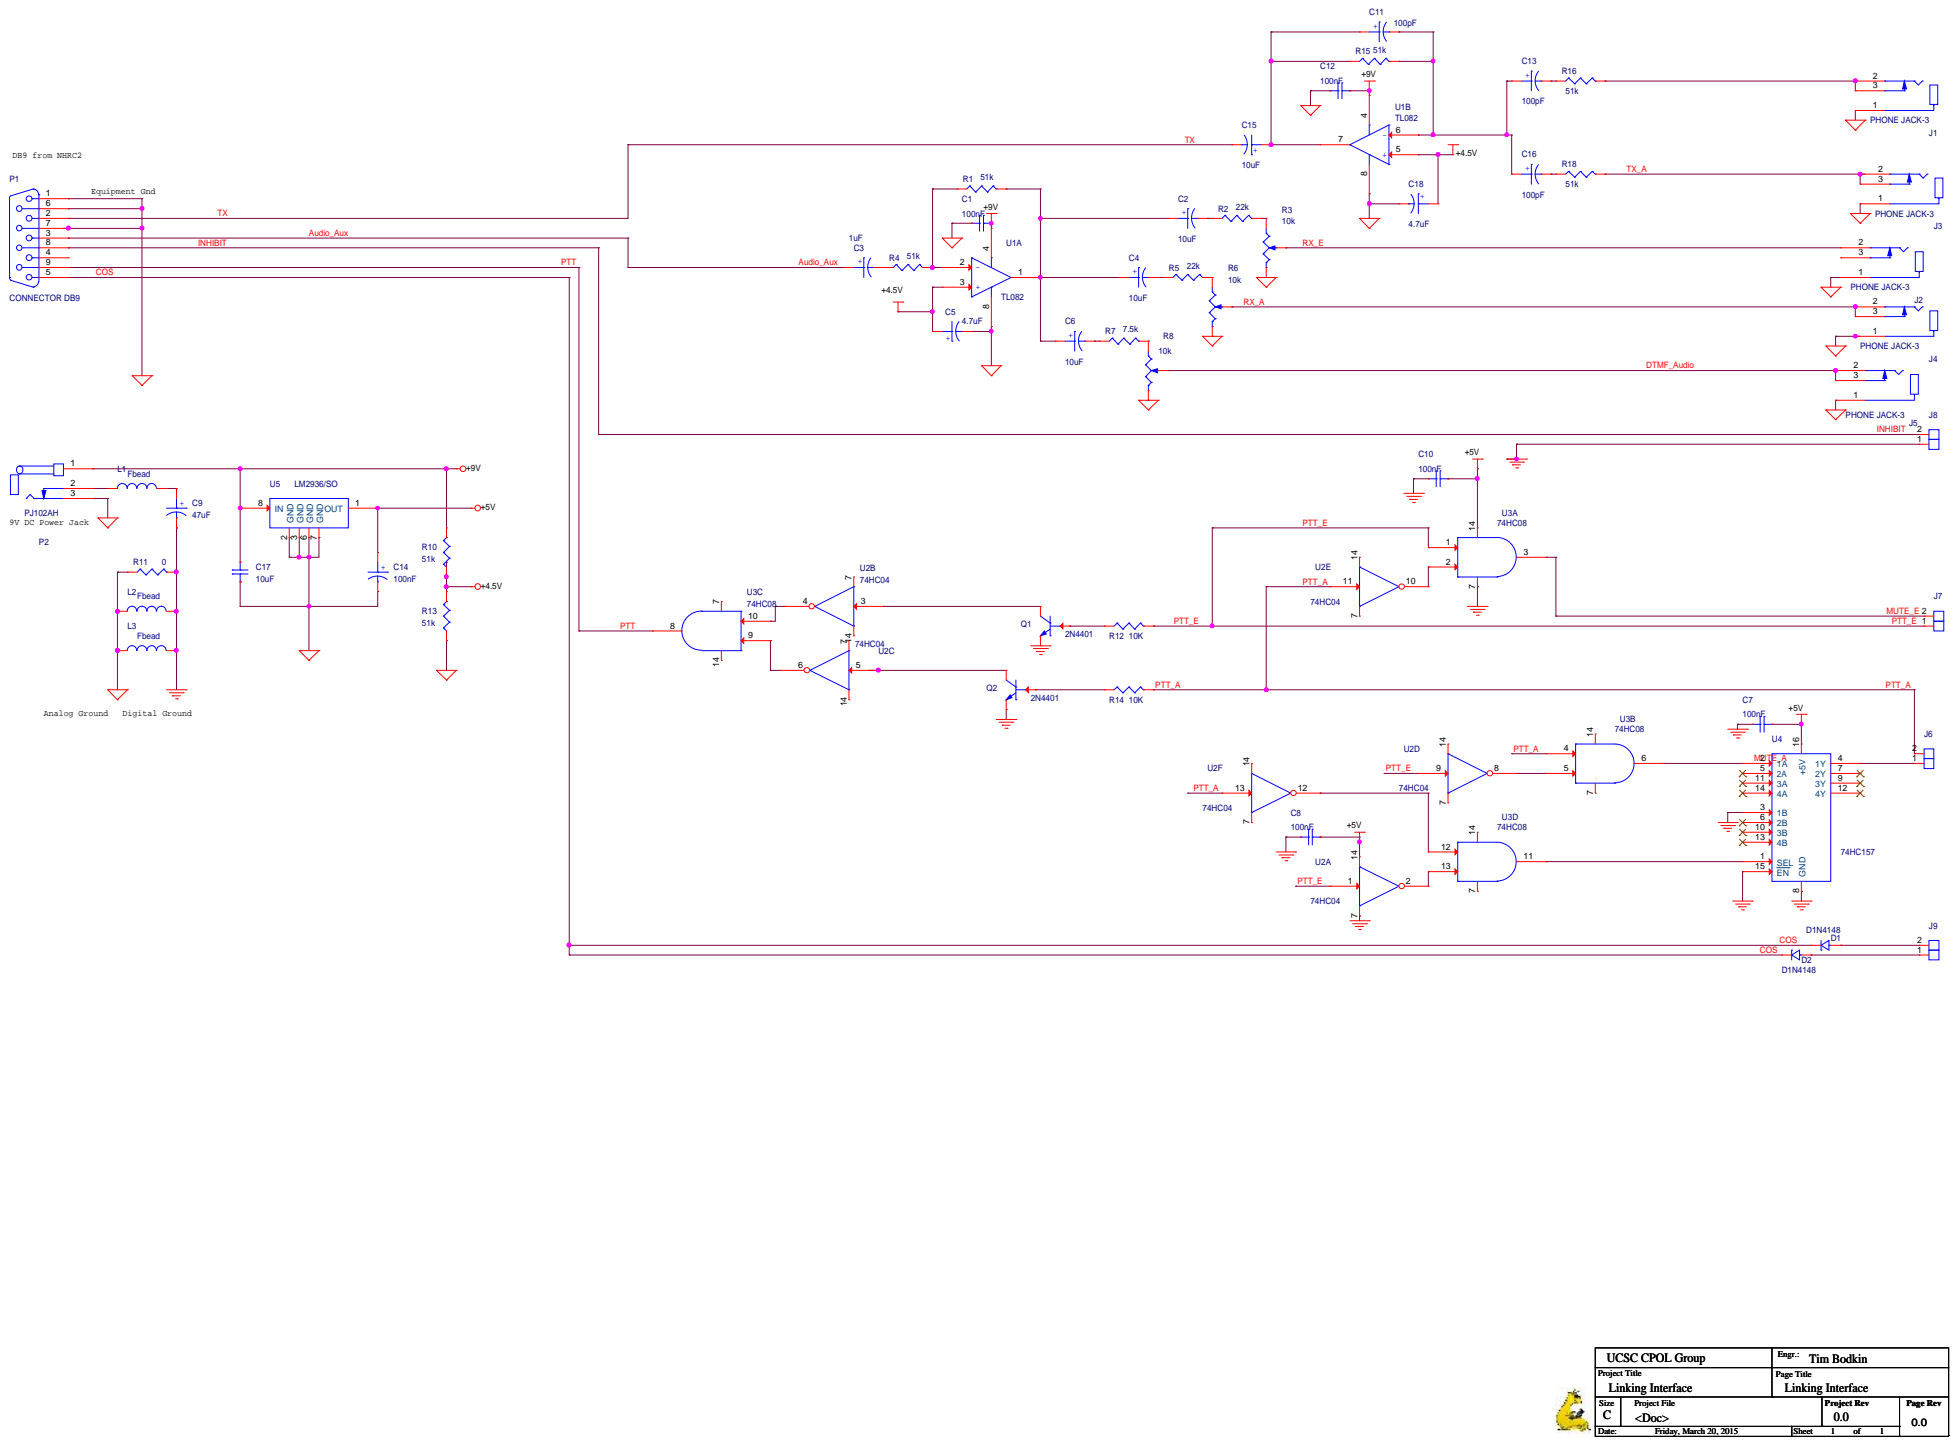
[picture p117: page 1]
