mattcarberry/echolink_hardware/LinkingInterface/v2_13/fromChris/linkinginterface/Schematics/LinkingInterfaceV1_2.pdf

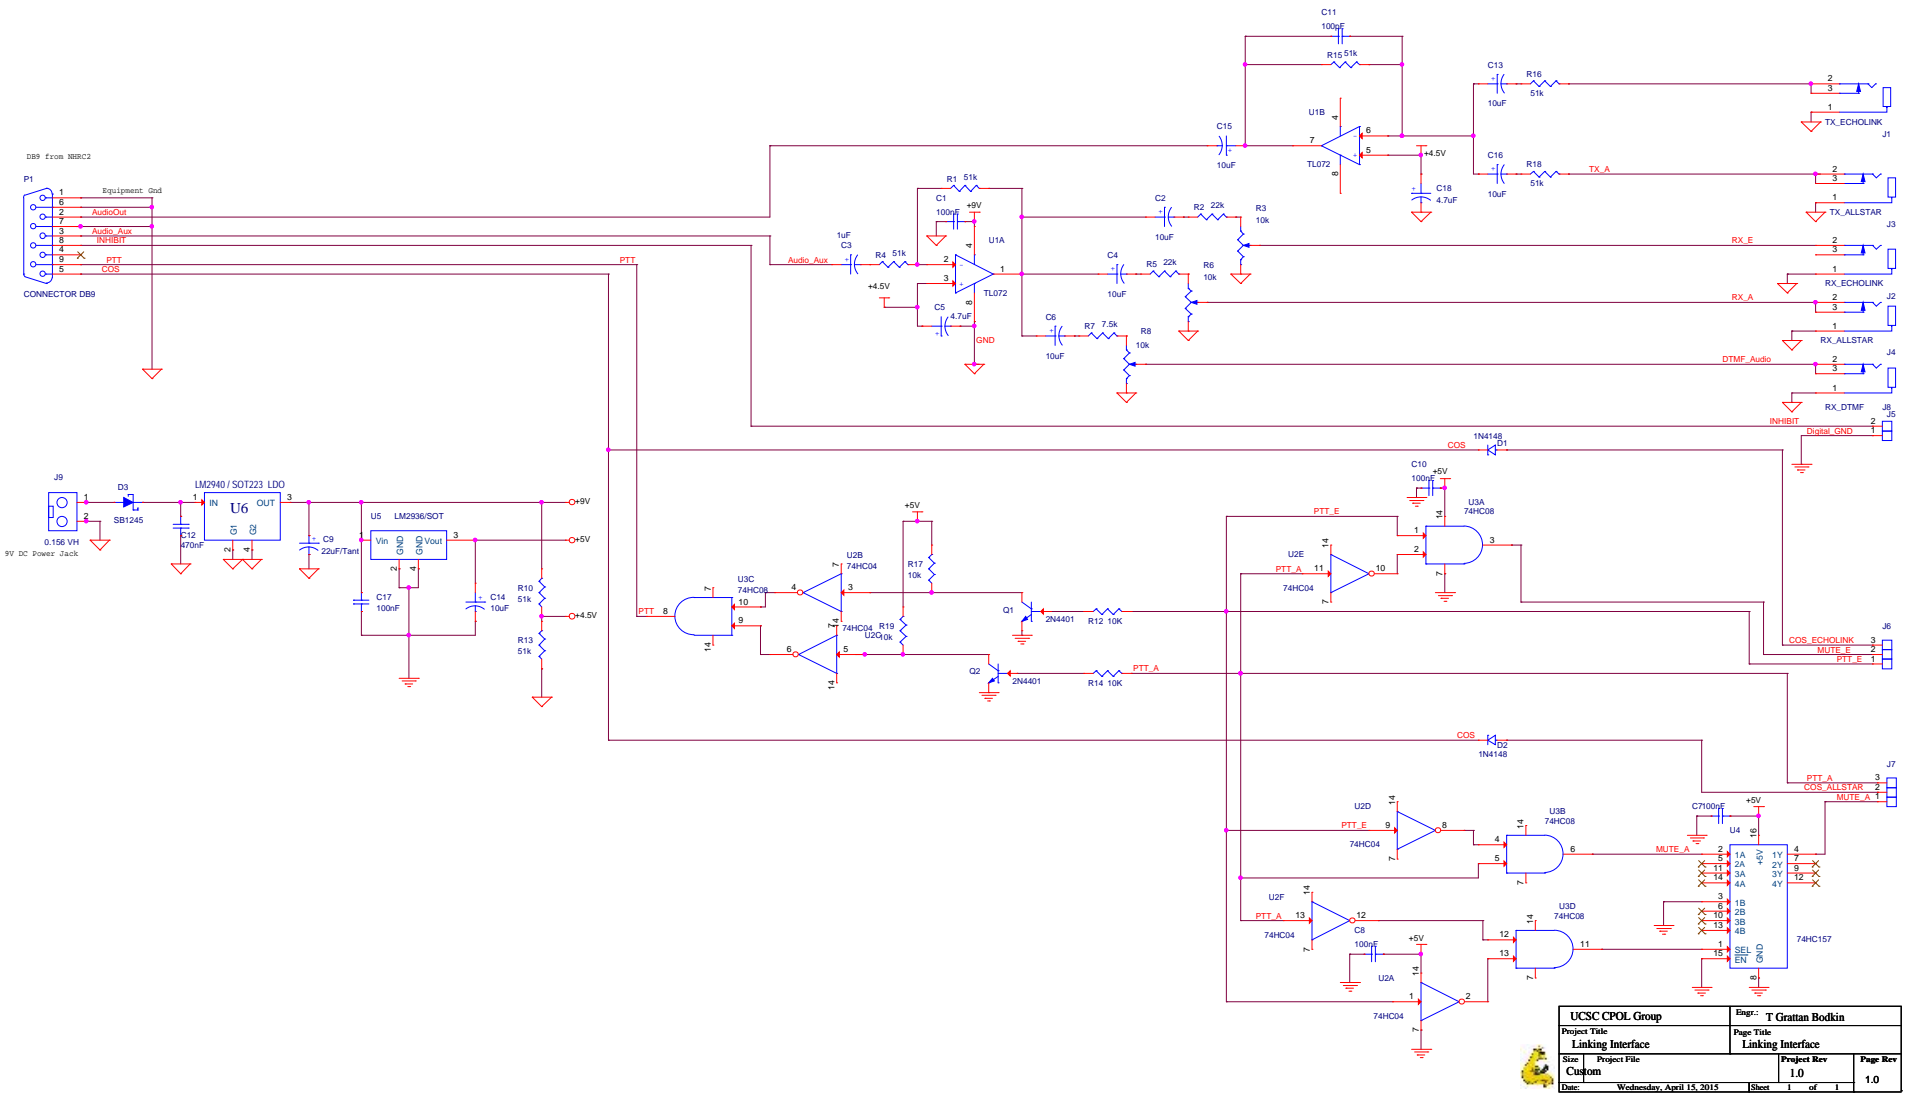
[picture p118: page 1]
