mattcarberry/echolink_hardware/LinkingInterface/v2_13/fromChris/linkinginterface/Schematics/LinkingInterfaceV1_2_Pinout.pdf

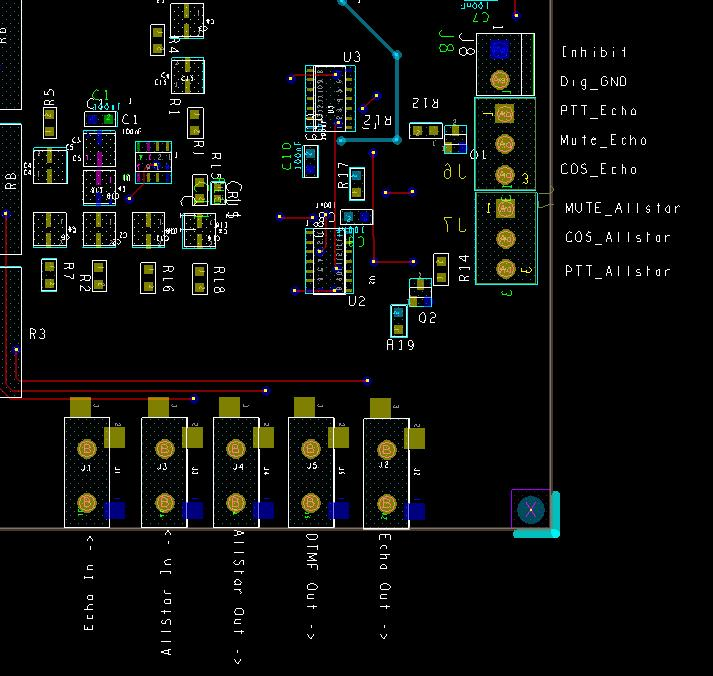
[picture p119: page 2]
