mattcarberry/echolink_hardware/(list of files, drawings)

Other design files:
CPOLAntenna/CircPolarization_II/Hardware/Archives/_CONTROLLER_0_53.DSN
CPOLAntenna/CircPolarization_II/Hardware/Archives/_controller_0_53.opj
CPOLAntenna/CircPolarization_II/Hardware/Archives/CONTROLLER_0_2.opj
CPOLAntenna/CircPolarization_II/Hardware/Archives/CONTROLLER_0_3.DSN
CPOLAntenna/CircPolarization_II/Hardware/Archives/controller_0_3.opj
CPOLAntenna/CircPolarization_II/Hardware/Archives/CONTROLLER_0_4.DSN
CPOLAntenna/CircPolarization_II/Hardware/Archives/CONTROLLER_0_4.opj
CPOLAntenna/CircPolarization_II/Hardware/Archives/CONTROLLER_0_5.DSN
CPOLAntenna/CircPolarization_II/Hardware/Archives/CONTROLLER_0_5.opj
CPOLAntenna/CircPolarization_II/Hardware/Archives/CONTROLLER_0_6.DSN
CPOLAntenna/CircPolarization_II/Hardware/Archives/CONTROLLER_0_6.opj
CPOLAntenna/CircPolarization_II/Hardware/Archives/CONTROLLER_0_9.DSN
CPOLAntenna/CircPolarization_II/Hardware/Archives/CONTROLLER_0_51.DSN
CPOLAntenna/CircPolarization_II/Hardware/Archives/CONTROLLER_0_51.opj
CPOLAntenna/CircPolarization_II/Hardware/Archives/CONTROLLER_0_52.DSN
CPOLAntenna/CircPolarization_II/Hardware/Archives/controller_0_52.opj
CPOLAntenna/CircPolarization_II/Hardware/Archives/CONTROLLER_0_53.DSN
CPOLAntenna/CircPolarization_II/Hardware/Archives/CONTROLLER_0_53.opj
CPOLAntenna/CircPolarization_II/Hardware/Archives/CONTROLLER_1_0.DSN
CPOLAntenna/CircPolarization_II/Hardware/Archives/CONTROLLER_1_0.opj
CPOLAntenna/CircPolarization_II/Hardware/CPOL.DSN
CPOLAntenna/CircPolarization_II/Hardware/CPOL_2M.DSN
CPOLAntenna/CircPolarization_II/Hardware/cpol_2m.opj
CPOLAntenna/CircPolarization_II/Hardware/CPOL_Chassis.DSN
LinkingInterface/v1_0/linkinginterface_V1/linkinginterface/AUDIOLINKINGINTERFACE.DSN
LinkingInterface/v1_0/linkinginterface_V1/linkinginterface/AudioLinkingInterface.opj
LinkingInterface/v1_0/linkinginterface_V1/V1/linkinginterface/linkinginterface/AUDIOLINKINGINTERFACE.DSN
LinkingInterface/v1_0/linkinginterface_V1/V1/linkinginterface/linkinginterface/AudioLinkingInterface.opj
LinkingInterface/v1_2/linkinginterface/AUDIOLINKINGINTERFACE.DSN
LinkingInterface/v1_2/linkinginterface/AudioLinkingInterface.opj
LinkingInterface/v2_7/linkinginterface/AUDIOLINKINGINTERFACE.DSN
LinkingInterface/v2_7/linkinginterface/AudioLinkingInterface.opj
LinkingInterface/v2_13/fromChris/linkinginterface/linkinginterface/AUDIOLINKINGINTERFACE.DSN
LinkingInterface/v2_13/fromChris/linkinginterface/linkinginterface/AudioLinkingInterface.opj
LinkingInterface/v2_13/fromChris/linkinginterface/linkinginterface/LIBRARY1.OLB
LinkingInterface/v2_13/fromChris/linkinginterface/linkinginterface/pcb/LinkingInterface.dsn
LinkingInterface/v2_13/linkinginterface/linkinginterface/AUDIOLINKINGINTERFACE.DSN
LinkingInterface/v2_13/linkinginterface/linkinginterface/AudioLinkingInterface.opj
LinkingInterface/v2_13/linkinginterface/linkinginterface/LIBRARY1.OLB
LinkingInterface/v2_13/linkinginterface/linkinginterface/pcb/LinkingInterface.dsn
LinkingInterface/v2_16/linkinginterface/linkinginterface/AUDIOLINKINGINTERFACE.DSN
LinkingInterface/v2_16/linkinginterface/linkinginterface/AudioLinkingInterface.opj
LinkingInterface/v2_16/linkinginterface/linkinginterface/LIBRARY1.OLB
LinkingInterface/v2_16/linkinginterface/linkinginterface/pcb/LinkingInterface.dsn
