mattcarberry/echolink_hardware/Other/GroundBounce_v1_2_Artwork/nc_param.txt

INTEGER-PLACES         2
DECIMAL-PLACES         4
X-OFFSET               0.000000
Y-OFFSET               0.000000
FEEDRATE               1
COORDINATES            ABSOLUTE
OUTPUT-UNITS           ENGLISH
TOOL-ORDER             DECREASING
REPEAT-CODES           YES
SUPPRESS-LEAD-ZEROES   NO
SUPPRESS-TRAIL-ZEROES  YES
SUPPRESS-EQUAL         NO
TOOL-SELECT            YES
OPTIMIZE_DRILLING      NO
ENHANCED_EXCELLON      YES
TAPE-FILE              C:/Users/tgbodkin/Desktop/GroundBounce/linkinginterface/pcb/GroundBounce/NCdrill.drl
HEADER                 none
LEADER                 12
CODE                   ASCII
SEPARATE               NO
DRILLING               LAYER-PAIR
BACKDRILL              NO
CAVITY                 NO
