mattcarberry/echolink_hardware/(commit log)

2016-04-20 Initial commit from dump of the dropbox folder. Organization to come.
    [AUDIOLINKINGINTERFACE.DSN, AudioLinkingInterface.opj, Connector_Order_June1.xlsx, LIBRARY1.OLB, LinkingInterface.dsn, LinkingInterfaceV1.2.brd, LinkingInterfaceV1.3.brd, LinkingInterfaceV2_0.brd]
2016-05-12 Removed initial files. Files sent by Chris are now in a different directory and partially filtered for duplication.
    [AUDIOLINKINGINTERFACE.DSN, AudioLinkingInterface.opj, Connector_Order_June1.xlsx, LIBRARY1.OLB, LinkingInterface.dsn, LinkingInterfaceV1.2.brd, LinkingInterfaceV1.3.brd, LinkingInterfaceV2_0.brd]
2016-05-12 Initial commit of partially sorted information from ftp dump of AC6P's server directory.
    [AUDIOLINKINGINTERFACE.DSN, AudioLinkingInterface.opj, BOM-DTMF.xlsx, CONTROLLER_0_2.opj, CONTROLLER_0_3.DSN, CONTROLLER_0_4.DSN, CONTROLLER_0_4.opj, CONTROLLER_0_5.DSN]
2016-05-12 Minor directory fixing and removed some rmlint files. Need to make a gitignore.
    [AUDIOLINKINGINTERFACE.DSN, AudioLinkingInterface.opj, LIBRARY1.OLB, LinkingInterface.dsn, LinkingInterfaceV1.2.brd, LinkingInterfaceV1.3.brd, LinkingInterfaceV2_0.brd, LinkingInterfaceV2_1.brd]
2016-08-04 Added version 3 as reviewed by Chris Tatosian and Prof Petersen
    [AUDIOLINKINGINTERFACE.DSN, AudioLinkingInterface.opj, LinkingInterface.dsn, LinkingInterfaceV2_13.brd, LinkingInterfaceV3_0.brd, LinkingInterfaceV3_0a.brd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]
2016-08-04 Removed old brd files from directory
    [LinkingInterfaceV2_13.brd]
2016-08-05 Moving directories to hopefully not his max window filename limit
    [AUDIOLINKINGINTERFACE.DSN, AudioLinkingInterface.opj, LIBRARY1.OLB, LinkingInterface.dsn, LinkingInterfaceV1.2.brd, LinkingInterfaceV1.3.brd, LinkingInterfaceV2_0.brd, LinkingInterfaceV2_10.brd]
2016-08-05 Significant path cleanup
    [AUDIOLINKINGINTERFACE.DSN, AudioLinkingInterface.opj, LIBRARY1.OLB, LinkingInterface.dsn, LinkingInterfaceV1.2.brd, LinkingInterfaceV1.3.brd, LinkingInterfaceV2_0.brd, LinkingInterfaceV2_1.brd]
